Manimohan05/SG13G2_2.4GHz_LC_VCO_FPLL/README.md

## A 2.4 GHz Type-II ∆Σ Fractional-N Phase Locked Loop (PLL) with a Type-IV Cross-Coupled Differential LC Voltage-Controlled Oscillator (VCO) for Wi-Fi/Bluetooth Applications — [Universalization of IC Design from CASS](https://github.com/unic-cass)

**Paper:** [A 2.4 GHz LC-VCO Fractional-N Phase Locked Loop Open-Source Design in 130-nm BiCMOS — IEEE Xplore](https://ieeexplore.ieee.org/document/11647761) (SMACD 2026)

# Table of Contents

1. [Members](#members)
2. [Overview of the Project](#overview)
3. [Specifications of the Project](#specs)
    - [Achieved — as published at SMACD 2026](#specs_achieved)
    - [Specifications not yet verified](#specs_open)
4. [Circuit Design](#circuit)
    - [Phase-Locked Loop (PLL)](#pll)
    - [Phase-Frequency Detector (PFD)](#pfd)
    - [Charge Pump (CP)](#cp)
    - [Loop Filter (LF)](#lf)
    - [Bandgap Reference (BGR)](#bgr)
    - [LC Voltage-Controlled Oscillator (LC-VCO)](#vco)
    - [Delta-Sigma Modulator and Fractional-N Divider](#dsm)
5. [On-Chip Spiral Inductor](#inductor)
    - [Geometry and Performance](#ind_geom)
    - [Open-Source EM Extraction Flow](#ind_flow)
6. [Simulation Results (Pre-Layout)](#sim)
    - [LC-VCO Output Waveform and Spectrum](#sim_vco)
    - [Varactor Tuning Range](#sim_var)
    - [VCO Tuning Curve and K_VCO](#sim_kvco)
    - [Integrated PLL Testbench](#sim_pll)
    - [Integrated Pre-Layout Simulation Circuit](#sim_circuit)
7. [Layout Design](#layout)
    - [Integrated PLL Layout](#lay_pll)
    - [2.5D View](#lay_3d)
    - [Layout Information](#layout_info)
8. [Physical Verification (DRC, LVS)](#pv)
9. [Post-Layout Results after PEX](#pex)
    - [Parasitic Extraction (RC) with Kpex](#pex_flow)
    - [Post-Layout Performance](#pex_results)
    - [Lock Behaviour](#pex_lock)
    - [Phase Noise](#pex_pn)
    - [Reference Spur](#pex_spur)
    - [Comparison with Published Work](#pex_cmp)
    - [Block-Level Pre- vs Post-Layout Comparison](#pex_blocks)
    - [LC-VCO Tuning: Pre- vs Post-Layout](#pex_vco)
10. [UNIC-CASS Tapeout](#tapeout)
11. [Repository Structure](#repo)
12. [Publication](#paper)
13. [References](#ref)

---

## 1. Members (Department of Electronic and Telecommunication Engineering, University of Moratuwa)

- Manimohan	Thiriloganathan (BSc).
- Shenal Ranasinghe (UG).
- Avishka Herath (BSc).
- Rajinthan	Rameshkumar (UG).
- Hansa Marasinghe (BSc).
- Anjana Viduranga (UG).
- Gayangana Leelarathne (MSc) - School of Electrical Engineering, Aalto University, Finland.
- Kithmin Wickremasinghe (MASc) - Department of Electrical and Computer Engineering, University of British Columbia, Canada.

[Return to top](#toc)

---

## 2. Overview of the Project

This project implements a charge-pump (Type-II) **fractional-N phase-locked loop** in the
**IHP SG13G2 130 nm open-source BiCMOS PDK**, using a fully open-source EDA flow. The
loop synthesises the 2.4 GHz ISM band from a stable `10 MHz` reference.

### Architecture

- **Phase-frequency detector** compares the reference `CLK_IN` against the divided VCO
  output and emits `UP`/`DN` pulses proportional to phase error.
- **Charge pump** converts those pulses into a signed current into the loop filter.
- **Third-order passive loop filter** integrates that charge into the control voltage
  `VCTRL` and suppresses reference-rate ripple.
- **Cross-coupled LC-VCO** converts `VCTRL` into an output near 2.44 GHz, tuned by an
  accumulation-mode varactor pair across a tank built on a **custom on-chip spiral
  inductor**.
- **Fractional-N divider** divides the output by 240 or 248, dithered by a first-order
  **delta-sigma modulator** so the *average* ratio is fractional.

### Frequency Relationship

`f_out = N_eff × f_ref`, where `N_eff` ranges from 240 to 248 as set by a 9-bit word
loaded serially over `SCLK`/`SDATA`/`EN`. With `f_ref = 10 MHz` this spans
`2.40 GHz to 2.48 GHz`, covering the 2.4 GHz ISM band. Fractional-N is what gets the
channel resolution below the 10 MHz reference spacing that integer-N would impose.

### Why this design is unusual

Open-source PDKs ship **no on-chip spiral inductor models**. Every previously published
open-source PLL therefore falls back on a ring oscillator and accepts the phase-noise
penalty. This design builds the missing model from scratch with an electromagnetic
solver, making it — to the best of our knowledge — the **first fully open-source CMOS
PLL with an integrated on-chip spiral inductor**.

### Block Diagram

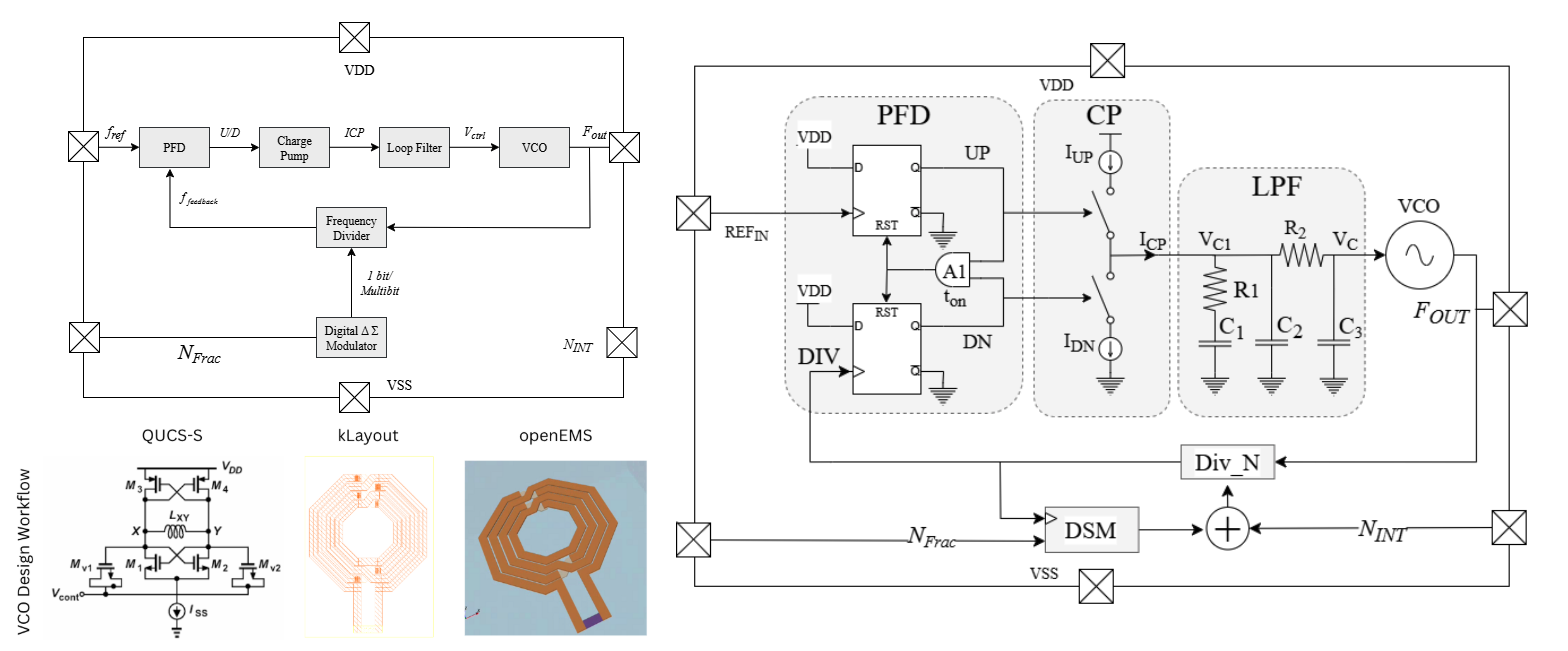
[picture p1: images/block.png]

<p align="center"><em>Figure 1: Block diagram of the fractional-N PLL</em></p>

[Return to top](#toc)

---

## 3. Specifications of the Project

The goal was a 2.4 GHz fractional-N synthesiser suitable for BLE and 2.4 GHz Wi-Fi,
minimising power and area while meeting phase-noise and settling requirements. BLE needs
stringent phase noise and fast settling (typically `< 150 µs`) for stable frequency
hopping.

| Category | Specification | Min | Typ | Max | Unit |
|---|---|-----|-----|-----|---|
| Top-level | Supply voltage | 1.08 | **1.20** | 1.32 | V |
| Top-level | Temperature | 20 | 27 | 50 | °C |
| Top-level | Reference frequency | – | 10 | – | MHz |
| Top-level | Output centre frequency range | 2.40 | 2.45 | 2.48 | GHz |
| Top-level | Expected PLL lock time | – | 25 | 40 | µs |
| Loop/Control | Loop bandwidth | 80 | 150 | 300 | kHz |
| Loop/Control | Phase margin | 50 | 55 | 60 | ° |
| Dividers | MMD division range | 240 | 245 | 248 | – |
| Charge Pump | CP current range | 50 | 150 | 300 | µA |
| VCO | Oscillation frequency | 2.35 | 2.45 | 2.55 | GHz |
| VCO | K<sub>VCO</sub> sensitivity | 50 | 80 | 150 | MHz/V |
| VCO | Phase noise (@1 MHz offset) | – | −100 | – | dBc/Hz |
| Power/Area | Total DC power consumption | – | 12 | 25 | mW |
| Power/Area | Die area | 0.48 | 0.8 | 1.2 | mm² |

> **Supply note.** Earlier revisions of this repository listed a 1.8 V supply. That was
> inherited from an older plan and is wrong for this implementation: SG13G2 low-voltage
> devices are 1.2 V parts, every testbench runs at `.param VDD=1.2`, and the archived
> corner runs use 1.08 / 1.20 / 1.32 V.

### 3.1 Achieved — post-layout, as published at SMACD 2026

Values below are the ones reported in the paper (see [§12](#paper)), measured from
post-layout simulation with parasitic extraction at V<sub>DD</sub> = 1.2 V, 27 °C,
f<sub>REF</sub> = 10 MHz, carrier 2.44 GHz.

| Parameter | Value |
|---|---|
| Technology | IHP SG13G2, 130 nm SiGe BiCMOS |
| Architecture | Type-II fractional-N, 1st-order digital ∆Σ |
| Reference frequency | 10 MHz |
| Division ratios | 240 and 248, ∆Σ-dithered |
| Output frequency range | 2.4 – 2.48 GHz |
| VCO tuning range | > 3.3 % |
| K<sub>VCO</sub> | ≈ 120 MHz/V |
| Phase noise @ 1 MHz offset | −100.8 dBc/Hz |
| Reference spur | ≈ −40.2 dBc |
| Total DC power | 12.73 mW |
| Die area | 660 µm × 526.5 µm ≈ 0.347 mm² |
| Varactor capacitance swing | 70 – 200 fF over 1.2 V V<sub>CTRL</sub> |
| VCO startup | reliable down to ≈ 0.7 V tail bias |

> The frequency and K<sub>VCO</sub> rows are the paper's figures. Re-simulating the LC-VCO alone
> on the extracted layout gives 2.3255 – 2.4256 GHz, so the post-layout VCO does not reach the
> top of the band; see [§9.8](#pex_vco).

The tuning range and the reference spur fall short of the targets in the table above —
3.3 % against 8 %, and −40.2 dBc against −60 dBc. The achieved tuning range still covers
the intended ISM band, and the spur still meets BLE requirements; both are addressed
under future work in [§9.6](#pex_cmp).

**Spiral inductor (paper §II):**

| Parameter | Value |
|---|---|
| Geometry | 3-turn symmetric octagonal, TopMetal2 spiral, TopMetal1 underpass via TopVia2 |
| R<sub>out</sub> / S / W | 218 µm / 14 µm / 30 µm |
| L<sub>diff</sub> @ 2.45 GHz | **4.000 nH** (2 % tolerance constraint) |
| Q<sub>diff</sub> @ 2.45 GHz | **16.80** |
| Peak Q<sub>diff</sub> | ≈ 18.9 near 3.8 GHz |
| Self-resonant frequency | ≈ 10 GHz |
| Q<sub>diff</sub> over 2.3 – 2.7 GHz, ±5 % geometry | 16.32 – 17.49 |
| L<sub>diff</sub> over 2.3 – 2.7 GHz, ±5 % geometry | 3.9 – 4.1 nH |
| EM setup | OpenEMS FDTD, 0 – 12 GHz Gaussian excitation, 0.5 µm refined cell size |

### 3.2 Specifications not yet verified

Listed rather than silently omitted — these appear in the target table but have no
archived evidence in this repository:

| Specification | Status |
|---|---|
| Lock time (25 – 40 µs) | Measured on the pre-layout schematic-level closed-loop run (§9.3): frequency-locked within ±1000 ppm from 7.6 µs, phase settled from 11 µs — inside the target. No post-layout closed-loop lock-time measurement yet |
| Loop bandwidth and phase margin | Design values from `model/calculations/PLL/`; no post-layout loop-gain measurement |
| PVT across TT/FF/SS/FS/SF | Corner libraries wired into the testbenches; only the typical corner archived |
| Monte Carlo yield (99 %) | Not run as a full sign-off across all blocks; bandgap and charge-pump mismatch run, see below |
| Power-down current | No power-down mode in this revision |

**Monte Carlo (mismatch), 200 samples, ngspice `mos_tt_mismatch`/`res_typ_mismatch`/`cap_typ_mismatch`:**

| Block | Quantity | Mean | Std. dev. |
|---|---|-----:|---:|
| Bandgap reference | V<sub>BGR</sub> | 601.6 mV | 3.7 mV |
| Charge pump | `UP` current | 48.8 µA | 0.4 µA |
| Charge pump | `DN` current | 51.7 µA | 0.4 µA |
| Charge pump | Up/down mismatch | −5.8 % | 0.5 % |

The −5.8 % mean mismatch is a real, quantified instance of the mechanism named in
[§4.3](#cp) as the dominant reference-spur source. Not yet run: a full 99 % yield
Monte Carlo across every block, and no PVT corners were combined with mismatch.

[Return to top](#toc)

---

## 4. Circuit Design

### 4.1 Phase-Locked Loop (PLL)

The top-level cell `LC_VCO_FPLL` has the interface:

```
.subckt LC_VCO_FPLL CLK_IN VDD CLK_OUT VSS EN RST SDATA SCLK
```

| Pin | Direction | Function |
|-----|---|---|
| `CLK_IN` | input | 10 MHz reference clock |
| `CLK_OUT` | output | Buffered 2.4 GHz VCO output |
| `EN`, `SCLK`, `SDATA` | input | Serial configuration of the division ratio |
| `RST` | input | Asynchronous active-high reset |
| `VDD`, `VSS` | supply | 1.2 V / ground |

A bandgap reference biases both the charge pump and the VCO tail current source, so loop
gain and oscillation amplitude track together over supply and temperature. Forty MIM
capacitors (20 µm × 20 µm) decouple the supply at the top level, keeping the switching
digital divider out of the VCO tank.

### 4.2 Phase-Frequency Detector (PFD)

Two rising-edge-triggered D flip-flops with a NAND reset — built entirely from SG13G2
standard cells:

| Instance | Cell | Role |
|---|---|---|
| `x1` | `sg13g2_dfrbp_2` | Reference-path flip-flop, sets `UP` |
| `x2` | `sg13g2_dfrbp_2` | Feedback-path flip-flop, sets `DN` |
| `x3` | `sg13g2_nand2_2` | Reset from `UP · DN` |

Being a PFD rather than a plain phase detector, its average output tracks *frequency*
error as well as phase, so the loop pulls in without a separate acquisition aid. The
delay through the NAND reset path sets a minimum `UP`/`DN` pulse width, which removes the
**dead zone** that would otherwise leave the VCO drifting near zero phase error.

### 4.3 Charge Pump (CP)

A current-steering charge pump: cascoded PMOS source and NMOS sink branches, switched by
`UP` and `DN`, biased from `VBGR`.

| Device | Type | W / L | Fingers | Role |
|---|---|---|---|---|
| `MM9` | `sg13_lv_pmos` | 163.6 µm / 2 µm | 20 | Source device into `VCP` |
| `MM5` | `sg13_lv_nmos` | 40.7 µm / 2 µm | 5 | Sink device from `VCP` |
| `MM7` | `sg13_lv_pmos` | 29.6 µm / 2 µm | 5 | `UP` switch |
| `MM1` | `sg13_lv_nmos` | 6 µm / 2 µm | 1 | `DN` switch |
| `MM6` | `sg13_lv_nmos` | 3.9 µm / 2 µm | 1 | `VBGR` reference current |

Every device is drawn at `L = 2 µm` — not for speed, but for output impedance and
matching. **Up/down current mismatch is the dominant reference-spur mechanism**: any
imbalance injects a net charge packet once per reference cycle, modulating the VCO at
10 MHz.

### 4.4 Loop Filter (LF)

Third-order passive, entirely on-chip:

| Element | Device | Size | Value |
|---|---|---|---|
| `RR1`, `RR2` | `rppd` | W = 2 µm, L = 407.2 µm | ≈ 14.84 kΩ each |
| `CC1` | `cap_cmim` | 48.34 µm × 48.34 µm, m = 16 | Integrating capacitor |
| `CC2` | `cap_cmim` | 18.63 µm × 18.63 µm, m = 4 | Ripple bypass |

`C1` gives the pole at the origin that makes the loop **type-II** (zero static phase
error). `R1` sets the stabilising zero that recovers phase margin. `R2`–`C2` add a third
pole well above the loop bandwidth to attenuate reference-rate ripple without eating the
margin `R1` just bought back.

### 4.5 Bandgap Reference (BGR)

An all-CMOS self-biased reference producing `VBGR ≈ 0.6 V`, with a startup network
(`dn2`/`dn3`/`dn4`) that forces the circuit out of its zero-current state at power-up and
then disengages. Channel lengths of 5 µm and above throughout — matching and low flicker
noise matter far more than speed here, because `VBGR` noise reaches the VCO tail and
up-converts into phase noise.

### 4.6 LC Voltage-Controlled Oscillator (LC-VCO)

A **type-IV cross-coupled topology**: complementary NMOS *and* PMOS cross-coupled pairs
across a shared LC tank, with an NMOS tail current source.

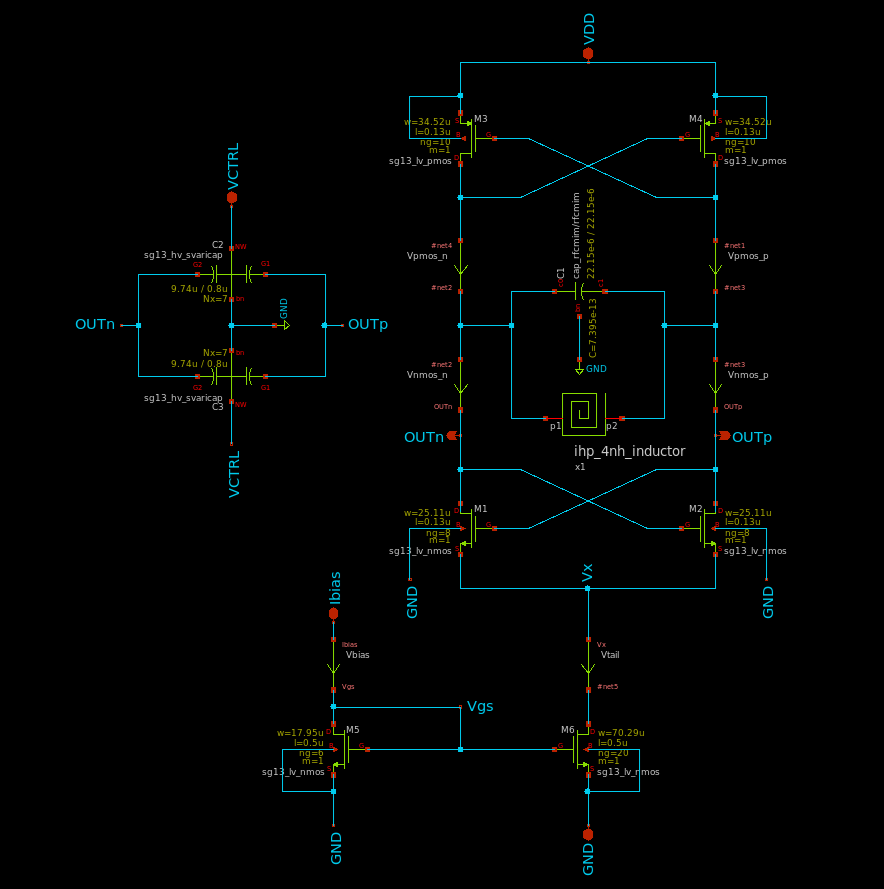
[picture p2: xschem/lc-vco/images/VCO_v2_Sch.png]

<p align="center"><em>Figure 2: LC-VCO schematic</em></p>

| Device | Type | W / L | Fingers | Role |
|---|---|---|---|---|
| `MM1`, `MM2` | `sg13_lv_nmos` | 21.99 µm / 130 nm | 3 | NMOS cross-coupled pair |
| `MM3`, `MM4` | `sg13_lv_pmos` | 36 µm / 130 nm | 5 | PMOS cross-coupled pair |
| `MM5` | `sg13_lv_nmos` | 384 µm / 1 µm | 48 | Tail current source |
| `MM6` | `sg13_lv_nmos` | 64 µm / 1 µm | 8 | Tail mirror diode |
| `MM7` | `sg13_lv_pmos` | 38 µm / 1 µm | 5 | Bias injection from `VBGR` |
| `MM8`, `MM9` | lv pmos / nmos | 15 µm, 1.5 µm / 130 nm | 10 / 1 | Output buffer |
| `MM10`, `MM11` | lv pmos / nmos | 15 µm, 1.5 µm / 130 nm | 10 / 1 | Dummy, balances the load |

Adding the PMOS pair roughly doubles the transconductance available for a given bias
current, which buys startup margin — the design starts reliably down to about `0.7 V` on
the tail bias — at the cost of extra tank parasitic capacitance.

`MM10`/`MM11` drive nothing. They exist so both tank nodes see the same capacitive load;
an asymmetric load would convert common-mode noise into phase noise.

**The tank:**

| Element | Device | Size | Value |
|---|---|---|---|
| `x1` | `4nH_INDUCTOR` | see [§5](#inductor) | 4.0 nH, Q<sub>diff</sub> = 16.8 @ 2.45 GHz |
| `CC1` | `rfcmim` | 21.9 µm × 21.9 µm | Fixed tank capacitance |
| `CC2`, `CC3` | `sg13_hv_svaricap` | 9.74 µm / 0.8 µm, Nx = 7 | Tuning, 70–200 fF over 1.2 V |

### 4.7 Delta-Sigma Modulator and Fractional-N Divider

The only synthesised block, hardened from Verilog with Yosys and LibreLane into the
`DSM_N_FREQ_DIV` macro.

**Divider chain:**

```
CLK_OUT ──► ÷4 fixed ──► ÷4/÷5 prescaler ──► mod-7 counter ──► ÷2 duty corrector ──► CLK_FB
 2.4 GHz      600 MHz          ▲                     │
                               └─── modulus controller ◄─── SEL (from ΔΣ)
```

| Path | Arithmetic | Total |
|---|---|---|
| ÷4 → (÷4/÷5 + mod-7 = 30) → ÷2 | 4 × 30 × 2 | **240** |
| ÷4 → (÷4/÷5 + mod-7 = 31) → ÷2 | 4 × 31 × 2 | **248** |

Only the first stage runs at 2.4 GHz; everything after it sees 600 MHz or less, so the
ratio-switching logic is ordinary synthesised standard-cell logic. The final ÷2 forces an
exact 50 % duty cycle, so the PFD sees no ratio-dependent phase offset.

**Delta-sigma modulator:** a first-order digital modulator — 9-bit signed accumulator,
9-bit comparator acting as a 1-bit quantiser, and a mapper expanding the decision back to
9 bits for subtraction. It shapes the quantisation error to high frequencies where the
loop filter attenuates it, replacing discrete fractional spurs with a small noise floor.
This is why the loop bandwidth must stay well below the frequency at which the shaped
noise rises.

[Return to top](#toc)

---

## 5. On-Chip Spiral Inductor

### 5.1 Geometry and Performance

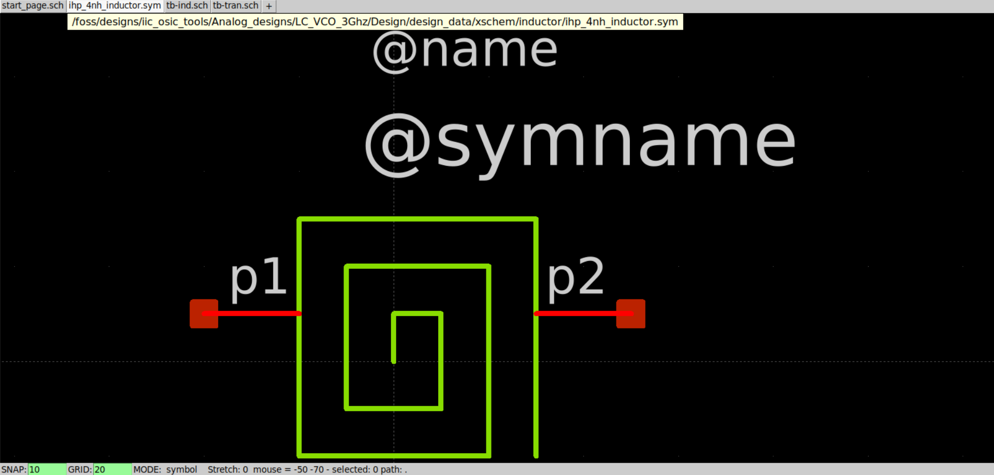
[picture p3: xschem/lc-vco/inductor/images/Inductor_symbol.png]

<p align="center"><em>Figure 3: Inductor symbol used in the VCO schematic</em></p>

| Parameter | Symbol | Value |
|---|---|---|
| Turns | N | 3 |
| Shape | – | Symmetric octagonal |
| Outer radius | R<sub>out</sub> | 218 µm |
| Turn spacing | S | 14 µm |
| Trace width | W | 30 µm |
| Main spiral | – | TopMetal2 (3.0 µm thick, σ = 3.03e7 S/m) |
| Underpass | – | TopMetal1 via TopVia2 |

**Octagonal** rather than square: the 45° corners avoid the current crowding that square
corners cause. **TopMetal2** because it is the thickest metal in the stack, giving the
lowest series resistance — and series resistance is what limits Q.

| Quantity | Value |
|---|---|
| L<sub>diff</sub> @ 2.45 GHz | 4.000 nH |
| Q<sub>diff</sub> @ 2.45 GHz | 16.80 |
| Peak Q<sub>diff</sub> | ≈ 18.9 near 3.85 GHz |
| Self-resonant frequency | ≈ 9.95 GHz |
| Q<sub>diff</sub> over 2.3–2.7 GHz (±5 % geometry) | 16.32 – 17.49 |
| L<sub>diff</sub> over 2.3–2.7 GHz (±5 % geometry) | 3.9 – 4.1 nH |

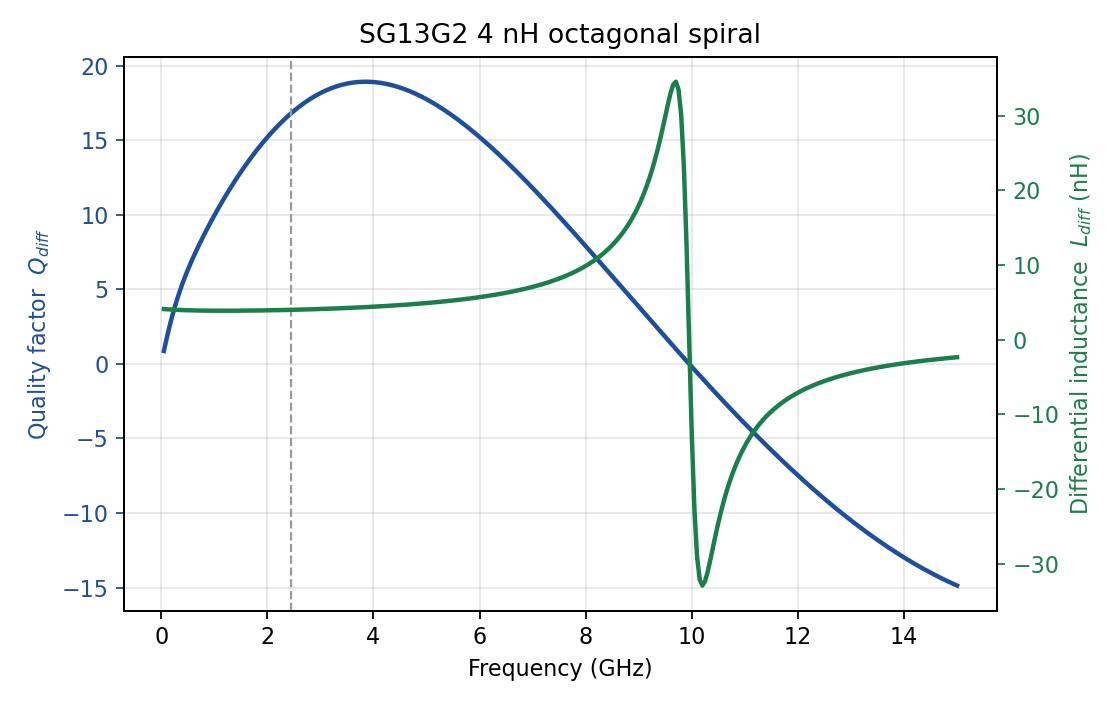
[picture p4: docs/img/inductor-LQ.png]

<p align="center"><em>Figure 4: Differential inductance and quality factor versus frequency, produced by the open-source flow in <code>em/</code></em></p>

Tank Q is essentially inductor Q, and oscillator phase noise falls as 1/Q², so every
point of Q is worth roughly 2 dB. Maximising Q<sub>diff</sub> at 2.45 GHz was therefore
the objective of the geometry optimisation; the 4 nH target was the *constraint*.

### 5.2 Open-Source EM Extraction Flow

The on-chip inductor is characterised by a **fully open-source EM extraction flow** in
[`em/`](em/), which takes the layout and emits the SPICE model directly, with no
proprietary EM solver in the loop:

```
gds/blocks/4nH_INDUCTOR.gds
      │  flatten polygons, map GDS layers onto the SG13G2 stackup
      ▼
 OpenEMS FDTD (0–12 GHz, graded mesh, real BEOL stack and substrate)
      │  raw 2-port S-parameters
      ▼
 two-step open-short de-embedding
      │
      ├──► L_diff, Q_diff, peak Q, SRF + plot
      ▼
 vector fit (shared poles) ──► .subckt 4nH_INDUCTOR 1 2
```

The generated model's subcircuit name and pin order match the Xschem testbenches, so it
drops straight in with no schematic change. An Ansys HFSS characterisation of the same
geometry (archived in [`archive/hfss/`](archive/hfss/)) is kept for cross-reference. The
`em` stage (the OpenEMS FDTD solve itself) has not been run in this repository; what is
verified is the rest of the pipeline — running the de-embedding, vector-fit and
circuit-solve stages on the archived HFSS S-parameters reproduces every published figure
to within a fraction of a percent:

| Quantity | Open-source flow | HFSS |
|---|---|---|
| L<sub>diff</sub> @ 2.45 GHz | 4.0005 nH | 4.000 nH |
| Q<sub>diff</sub> @ 2.45 GHz | 16.805 | 16.80 |
| Peak Q<sub>diff</sub> | 18.915 at 3.85 GHz | ≈ 18.9 near 3.8 GHz |
| Self-resonant frequency | 9.95 GHz | ≈ 10 GHz |

```bash
cd em
pip install -r requirements.txt
python scripts/validate.py                                   # self-check
python scripts/run_pipeline.py --config config/inductor_4nH.yaml
```

Full details in [`em/README.md`](em/README.md).

[Return to top](#toc)

---

## 6. Simulation Results (Pre-Layout)

### 6.1 LC-VCO Output Waveform and Spectrum

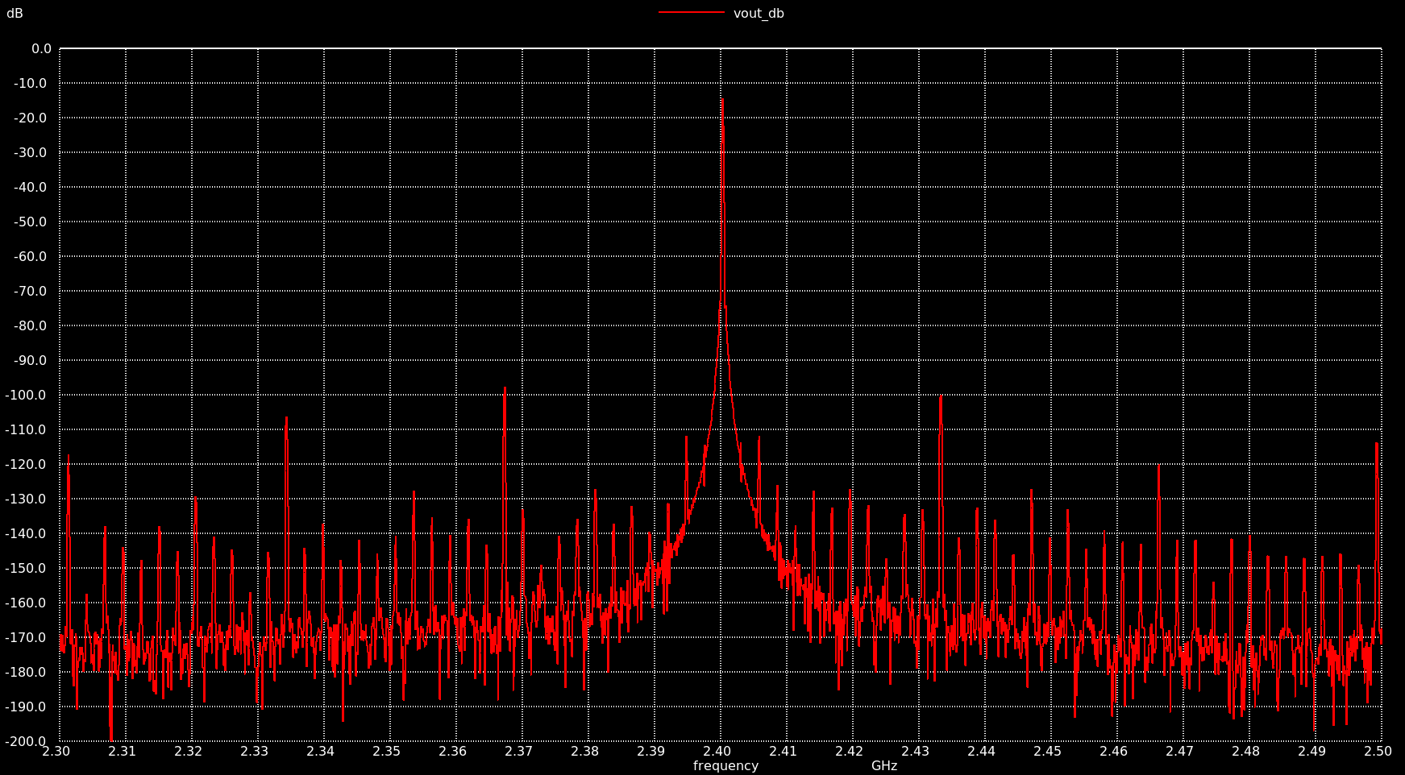
[picture p5: xschem/lc-vco/images/VCO_v2_FFT_2.4G.png]

<p align="center"><em>Figure 5: LC-VCO output spectrum at 2.4 GHz</em></p>

### 6.2 Varactor Tuning Range

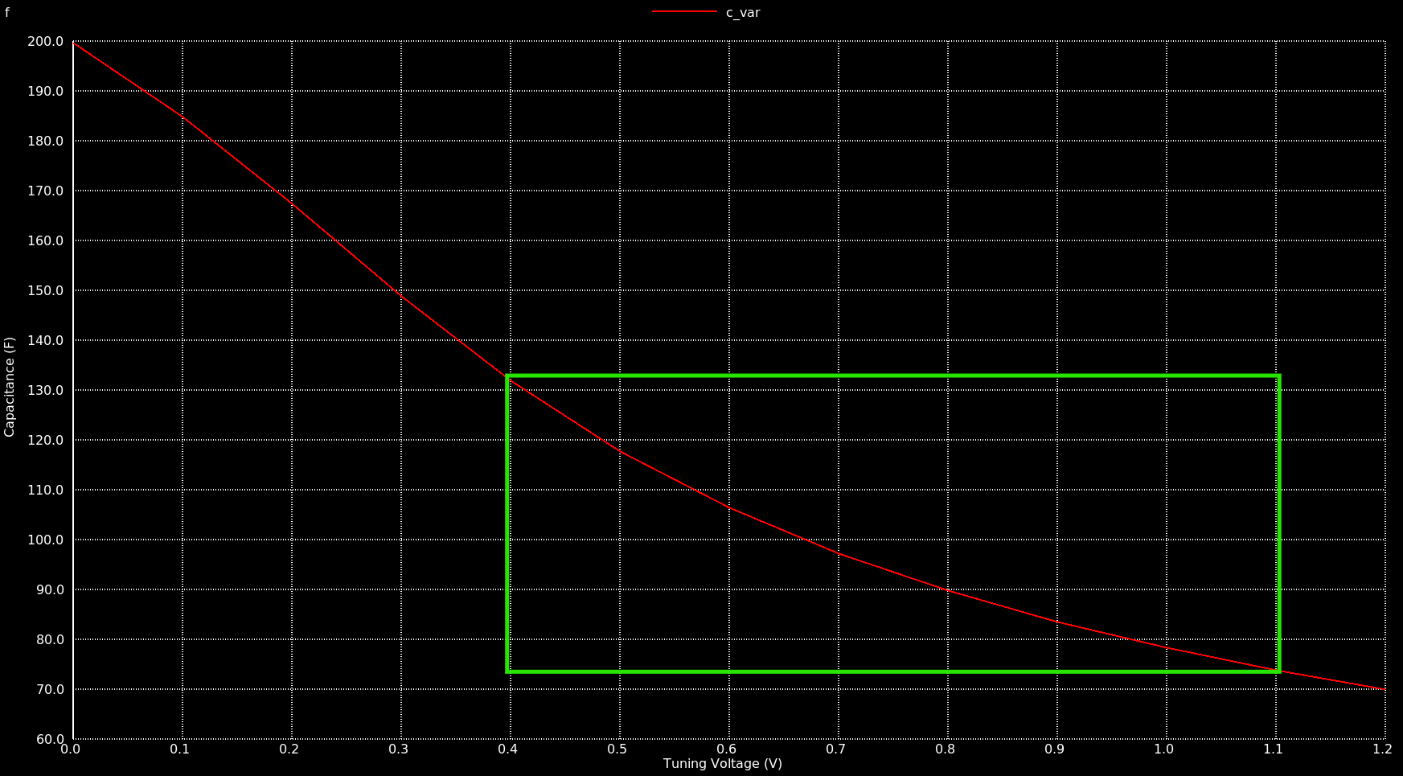
[picture p6: xschem/lc-vco/images/Varicap_Range.png]

<p align="center"><em>Figure 6: Varactor capacitance versus control voltage — 70 fF to 200 fF over 1.2 V</em></p>

### 6.3 VCO Tuning Curve and K<sub>VCO</sub>

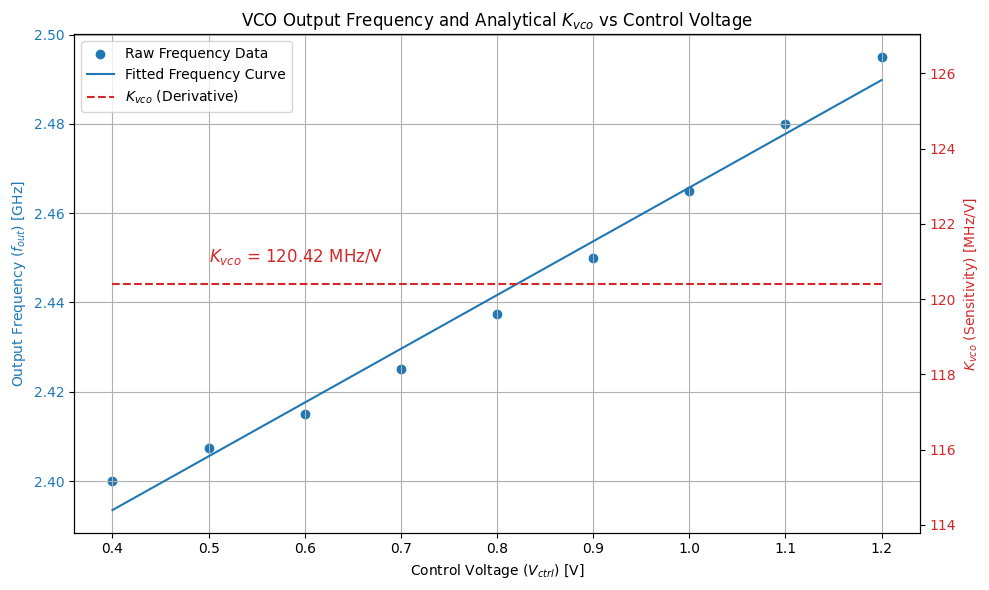
[picture p7: xschem/lc-vco/images/VCO_v2_Kvco.png]

<p align="center"><em>Figure 7: Oscillation frequency and K<sub>VCO</sub> versus control voltage</em></p>

### 6.4 Integrated PLL Testbench

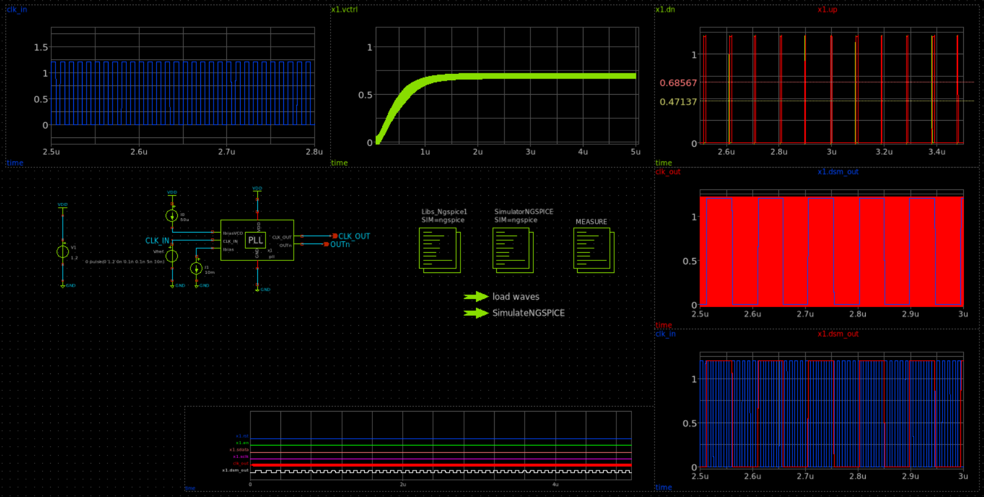
[picture p8: xschem/top-pll/images/Pll_tb.png]

<p align="center"><em>Figure 8: Closed-loop PLL testbench</em></p>

### 6.5 Integrated Pre-Layout Simulation Circuit

The complete schematic driven for the pre-layout closed-loop runs — PFD, charge pump,
loop filter, LC-VCO, bandgap reference and the ∆Σ fractional-N divider wired as one
system.

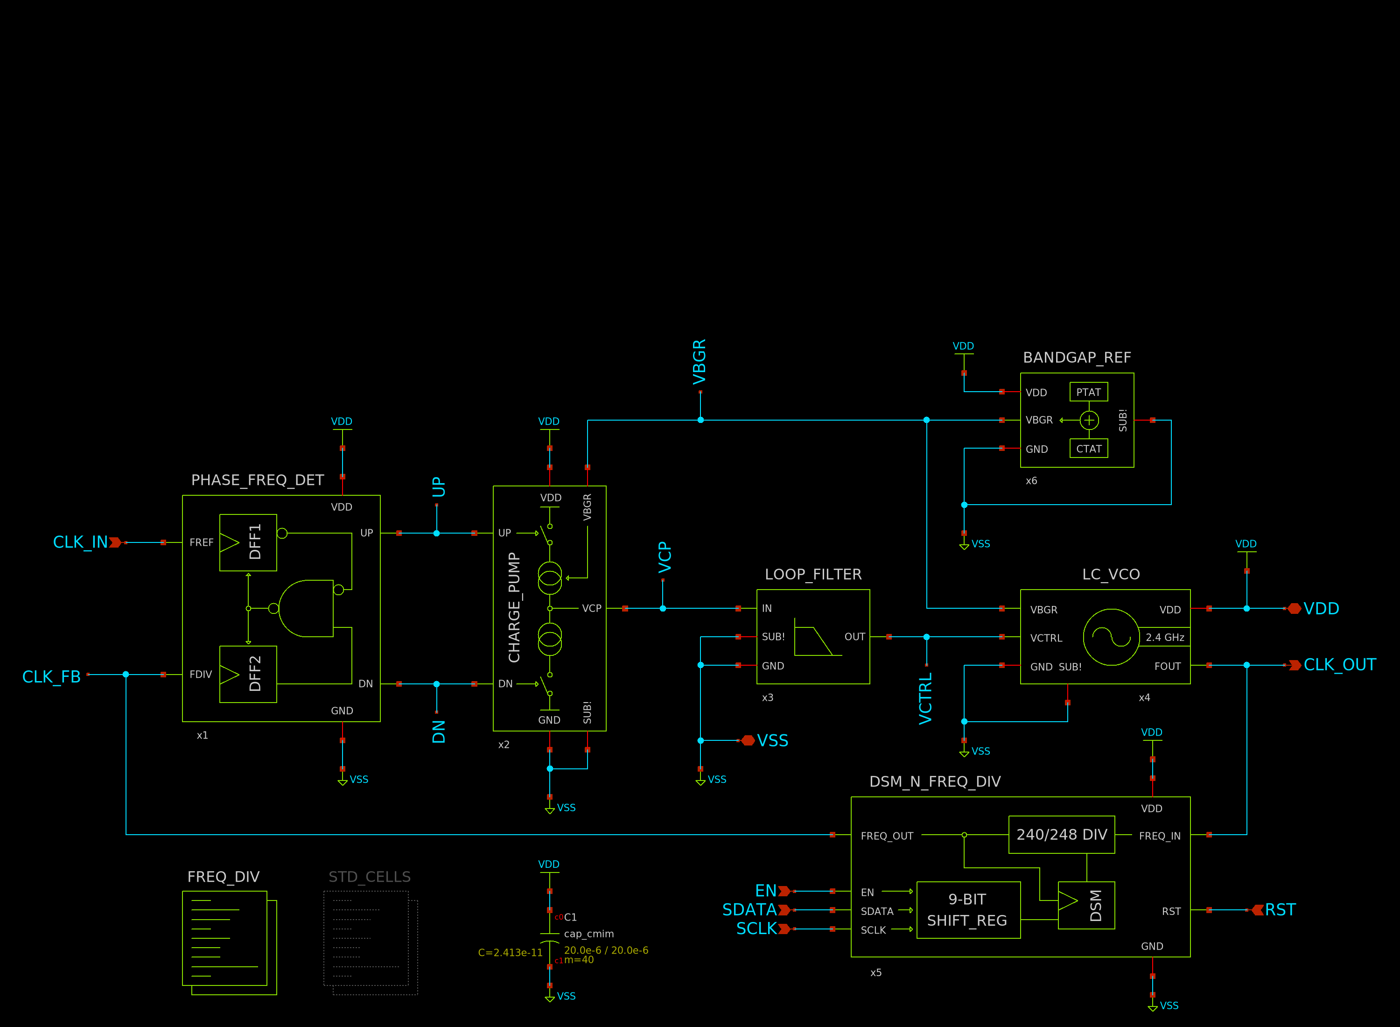
[picture p9: images/PLL_integrated_schematic.png]

<p align="center"><em>Figure 9: Integrated pre-layout simulation circuit</em></p>

[Return to top](#toc)

---

## 7. Layout Design

### 7.1 Integrated PLL Layout

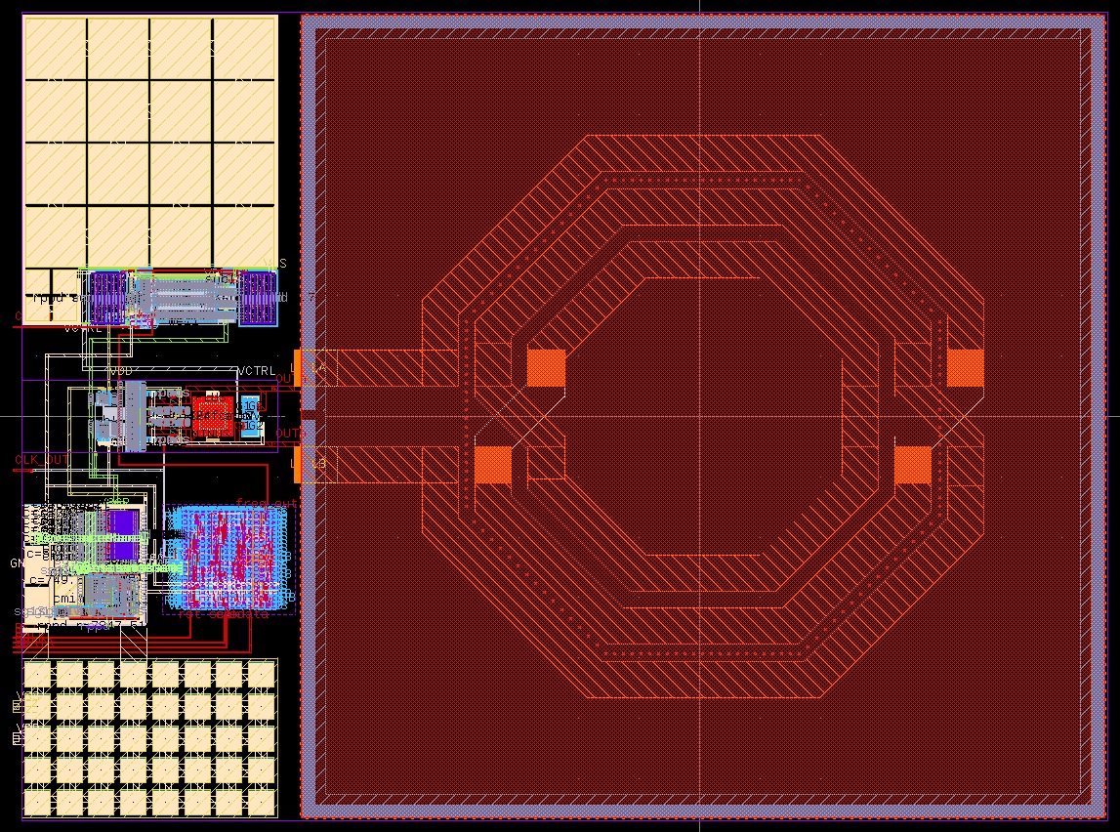
[picture p10: images/PLL_Layout.jpeg]

<p align="center"><em>Figure 10: Top-level PLL layout — 907 µm × 670 µm</em></p>

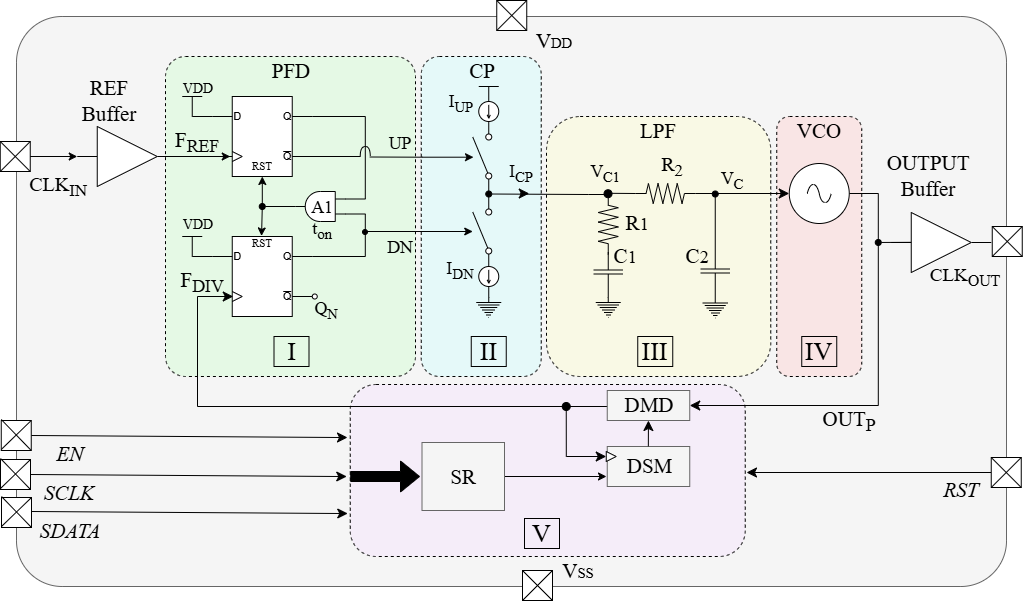
[picture p11: images/PLL_Architecture.png]

<p align="center"><em>Figure 11: The five blocks of the PLL — PFD (I), charge pump (II), loop filter (III), LC-VCO (IV), and the serially programmed ΔΣ modulator with divider (V)</em></p>

The spiral inductor dominates the die and sets its size. The floorplan reflects each
block's sensitivity: the inductor and VCO occupy a guard-ringed region as far as
practical from the digital divider; the switching `DSM_N_FREQ_DIV` macro is placed away
from the tank with its own decoupling; and the PFD, charge pump and loop filter sit
together as the `PFD_CP_LF` group, because charge-pump current matching depends on how
the filter loads it.

### 7.2 2.5D View

The metal stack rendered with KLayout's 2.5D viewer — the spiral on TopMetal2 with its
TopMetal1 underpass is clearly separated from the rest of the circuitry below.

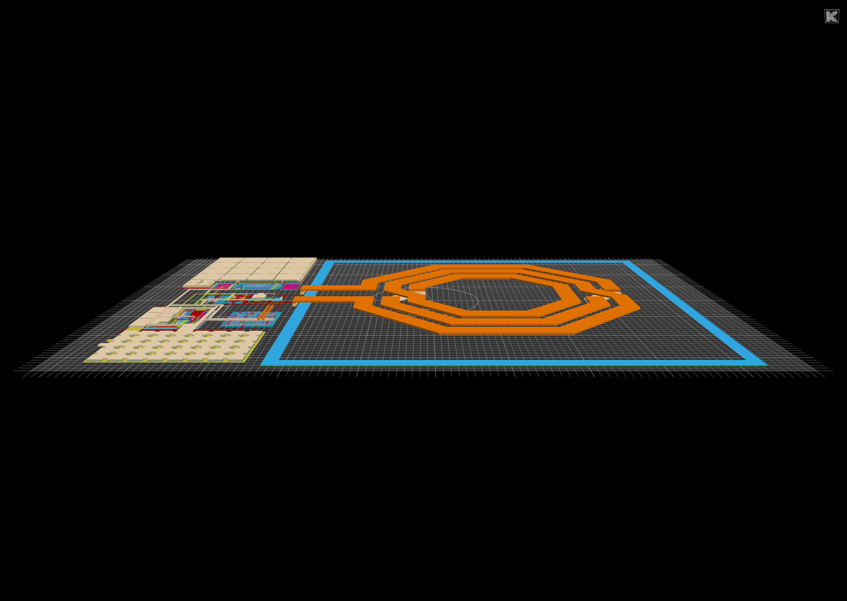
[picture p12: images/PLL_layout_2p5D_oblique_view.png]

<p align="center"><em>Figure 12: 2.5D view of the integrated PLL layout</em></p>

### 7.3 Layout Information

| | **Width (µm)** | **Height (µm)** | **Area (µm²)** | Notes |
|--|---|---|---|---|
| **Integrated PLL** | 907.0 | 670.0 | 607,690 (≈ 0.608 mm²) | bounding box of all layers in `gds/LC_VCO_FPLL.gds` |
| **Spiral inductor** | 666 | 672 | ≈ 447,000 | TopMetal2 / TopMetal1, guard-ringed |

[Return to top](#toc)

---

## 8. Physical Verification (DRC, LVS)

All runs used **KLayout 0.30.11** and IHP-Open-PDK `7e53c77` against the IHP SG13G2 rule
decks (`main` and `sg13g2_maximal` tables for DRC, density rules off). **LVS was run with
strict port checking** — no `--ignore_top_ports_mismatch` — so pin names and pin count on
the layout must equal those of the schematic netlist.

| Cell | DRC | LVS |
|---|-----|-----|
| `LC_VCO_FPLL` (integrated top level) | ✅ clean | ✅ match |
| `PFD_CP_LF` | ✅ clean | ✅ match |
| `PHASE_FREQ_DET` | ✅ clean | ✅ match |
| `CHARGE_PUMP` | ✅ clean | ✅ match |
| `LOOP_FILTER` | ✅ clean | ✅ match |
| `BANDGAP_REF` | ✅ clean | ✅ match |
| `DSM_N_FREQ_DIV` | ✅ clean | ✅ match |
| `LC_VCO_NOIND` | ✅ clean | ✅ match |
| `LC_VCO` | ✅ clean | ✅ match |
| `4nH_INDUCTOR` | ✅ clean | ℹ️ extraction only |

**The integrated top level `LC_VCO_FPLL` is DRC clean and LVS matching** — the result
that gates tapeout.

> **Block pin names.** The standalone block layouts carry the same pin names as their
> schematics: ground is `GND` (`LOOP_FILTER`, `CHARGE_PUMP`), the supplies of
> `DSM_N_FREQ_DIV` are `GND`/`VDD`, and `LC_VCO` has its five pins labelled on the top
> cell. `LOOP_FILTER`, `CHARGE_PUMP` and `BANDGAP_REF` declare a `SUB!` substrate pin in
> their schematics; each layout has a small P+ substrate tap on a Metal1 pad labelled
> `SUB!` (placed clear of the existing shapes) so that pin exists in the layout as well.
> These edits add labels and one tap per block and change no existing geometry. The
> full-chip and `PFD_CP_LF` layouts contain their own copies of these blocks without the
> extra pad and still match. `4nH_INDUCTOR` is extraction-only because there is no
> schematic to compare a passive spiral against; LVS sees the two-terminal black box
> `spice/4nH_INDUCTOR_LVS.spice`.

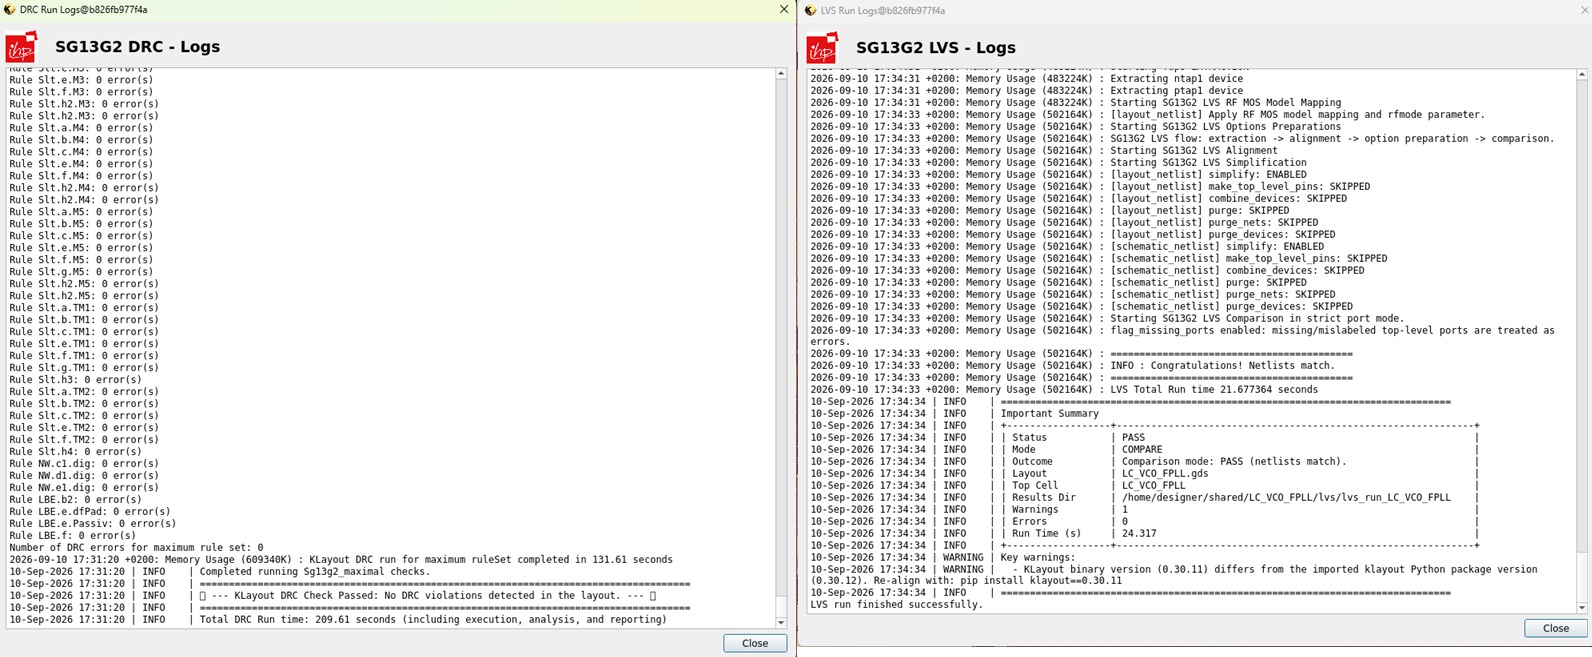
[picture p13: images/DRC_and_LVS_all_blocks_passed_log.jpeg]

<p align="center"><em>Figure 13: DRC and LVS run logs for the blocks</em></p>

Archived runs live in [`drc/`](drc/) and [`lvs/`](lvs/), one directory per cell.

[Return to top](#toc)

---

## 9. Post-Layout Results after PEX

Nominal conditions: V<sub>DD</sub> = 1.2 V, 27 °C, typical corner, f<sub>REF</sub> =
10 MHz, carrier 2.44 GHz.

> **What is actually post-layout here.** §9.2 (frequency, K<sub>VCO</sub>, phase noise, spur,
> power) reports the paper's published post-layout numbers. §9.7 and §9.8 are this repository's
> own post-layout PEX comparisons, block by block and for the VCO alone. §9.3 and §9.4 (lock
> behaviour and phase noise plots) are from a **closed-loop run of the schematic netlist**, not
> a post-layout run — the closed-loop PLL has not yet been simulated on the extracted netlist
> (§9.7 explains why). They are placed here, next to the paper's numbers, so the two can be
> compared; the captions say "schematic level" for this reason. §9.5's figure is the paper's
> post-layout spectrum; the text below it adds the schematic-level run's own spur measurement
> for the same comparison.

### 9.1 Parasitic Extraction (RC) with Kpex

RC extraction is run with Magic through `kpex`. Results are archived per cell in
[`pex/`](pex/):

```
pex/<CELL>__<TOPCELL>/
  kpex.log
  magic_RC/<CELL>.pex.spice              ← the extracted netlist used in PEX simulation
  magic_RC/<CELL>.ext
  magic_RC/<CELL>_MAGIC_RC_Script.tcl
```

Extracted netlists feed the `*_PEX` testbenches in [`simulations/`](simulations/), for
example `tb_CP_LF_PEX.spice` and `tb_PHASE_FREQ_DET_PEX.spice`. PEX is archived for
`BANDGAP_REF`, `CHARGE_PUMP_V2`, `LOOP_FILTER`, `PHASE_FREQ_DET` and `LC_VCO_NOIND`. The archived `<CELL>.pex.spice` files are the testbench-ready netlists
(subcircuit named `<CELL>_PEX`, ports in the testbench pin order); the extraction is from
the layouts in `gds/blocks/`, including revision **V2** of the charge pump that ships in
the top level.

**Digital divider.** `DSM_N_FREQ_DIV` is a standard-cell block from the OpenLane flow, so it has no separate
RC extraction here. Its post-layout simulation uses the layout-extracted netlist of the OpenLane run,
[`xschem/dsm/src/runs/RUN_2026-03-04_15-08-00/final/spice/dsm_and_freq_divider.spice`](xschem/dsm/src/runs/RUN_2026-03-04_15-08-00/final/spice/dsm_and_freq_divider.spice)
(transistor-level, no parasitic elements), with the standard cells taken from the PDK.

**LC-VCO.** `kpex`/Magic extract only resistance and capacitance — no inductance and no
mutual coupling — so the spiral must not be extracted with the rest of the VCO. The VCO
is extracted without the inductor as `LC_VCO_NOIND`, and the EM-extracted
`4nH_INDUCTOR` model is connected between its `OUTn` and `OUTp` pins in
`simulations/LC_VCO_NOIND_pex_tb.spice`. `LC_VCO_NOIND.pex_sim.spice` is the same
netlist with the four extracted varactor lines replaced by two `sg13_hv_svaricap`
instances, which ngspice can bind to the PDK model.

### 9.2 Post-Layout Performance

| Metric | Value |
|---|---|
| Output frequency range | 2.40 – 2.48 GHz |
| VCO tuning range | > 3.3 % |
| K<sub>VCO</sub> | ≈ 120 MHz/V |
| Phase noise @ 1 MHz offset | **−100.8 dBc/Hz** |
| Reference spur | ≈ −40.2 dBc |
| Total power consumption | **12.73 mW** |
| Die area | **907 µm × 670 µm (≈ 0.608 mm²)** |

> The die area is measured from the current `gds/LC_VCO_FPLL.gds` (bounding box of all layers); the paper
> reports 660 µm × 526.5 µm (≈ 0.347 mm²), which is a different floorplan (§3.1). The output-frequency and K<sub>VCO</sub> rows are the paper's figures. The extracted LC-VCO,
> simulated on its own, covers 2.3255 – 2.4256 GHz with K<sub>VCO</sub> ≈ 106 MHz/V over
> 0.4 – 1.2 V; see [§9.8](#pex_vco).

### 9.3 Lock Behaviour

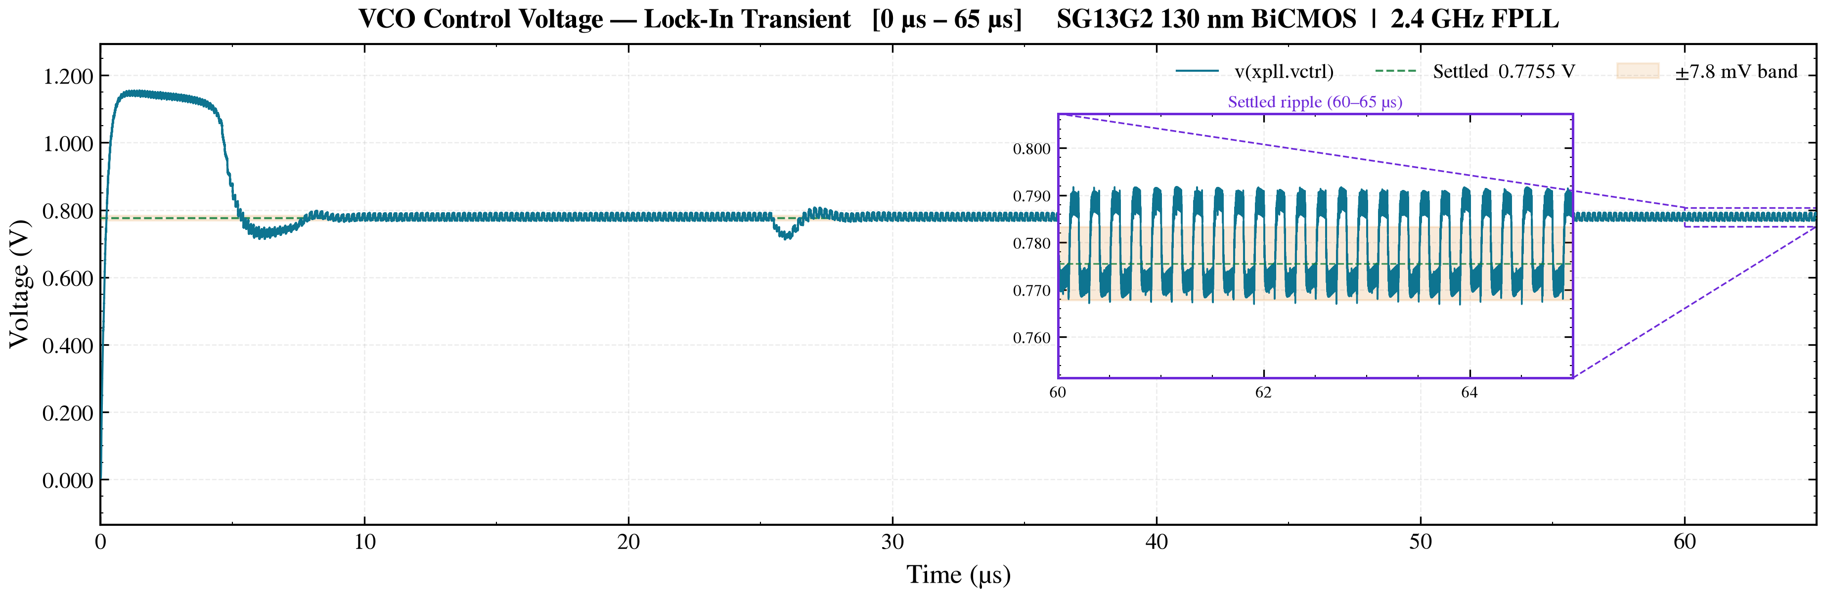
[picture p14: xschem/top-pll/plots/prelayout/plot_vctrl_transient.png]

<p align="center"><em>Figure 14: Control voltage over 0–65 µs (closed-loop run at schematic level) — overshoot to 1.16 V, lock at about 8 µs, and a short disturbance every 25.5 µs from the divider's modulator pattern</em></p>

The loop is frequency-locked within ±1000 ppm from 7.6 µs and within ±500 ppm from 8.5 µs; the phase error is within
±100 ps of its final value from 11 µs. Every 25.5 µs (255 reference cycles) the modulator repeats a pattern in which two
equal bits follow each other, and the loop takes about 2 µs to recover from it; it always returns to the same phase. The
steady-state control voltage is 0.7795 V with about 26 mV of ripple at 10 MHz. Details and plots: [`xschem/top-pll/plots/prelayout/`](xschem/top-pll/plots/prelayout/).

### 9.4 Phase Noise

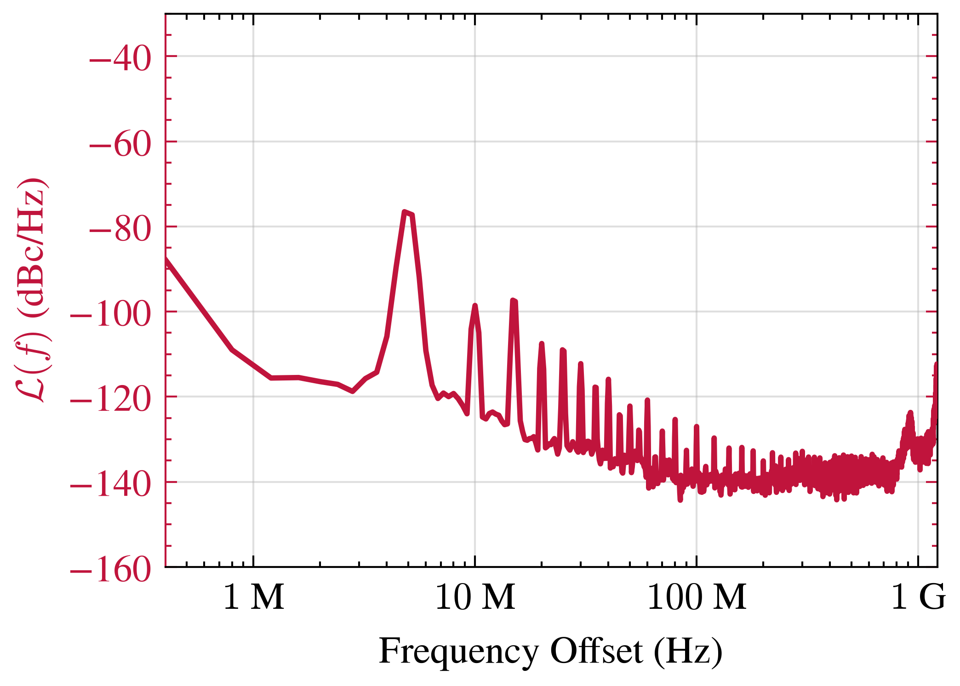
[picture p15: xschem/top-pll/plots/prelayout/phase_noise_with_tone_1.png]

<p align="center"><em>Figure 15: Steady-state closed-loop phase noise at a 2.44 GHz carrier (closed-loop run at schematic level). The peak at 5 MHz, and the smaller peaks at its multiples, come from the divider alternating between 240 and 248 — they are not noise</em></p>

> ngspice has no closed-loop PLL phase-noise analysis, so phase noise is derived by
> post-processing a long transient. The spectrum is taken from the **settled** portion
> only — including the acquisition transient corrupts it. The reference open-source work
> this is compared against uses the same method, so the comparison is like-for-like.

The peak at 5 MHz (about −77 dBc/Hz) is a discrete tone at f<sub>REF</sub>/2. With the
programmed code the ΔΣ modulator makes the divider alternate between ratios 240 and 248 on every
other reference period, so the average is 244 but the instantaneous ratio toggles by ±4. That
modulates the VCO at 5 MHz and at its harmonics, which is also why the 10 MHz reference spur
(§9.5) is one of the peaks. Read the noise level away from the tones: at 1 MHz it is about
−109 to −118 dBc/Hz, depending on the analysis window, and with the tones removed it is about
−122 dBc/Hz at 10 MHz. The paper's −100.8 dBc/Hz (§3.1) is not reproduced by this run. The
tone-free plots, the tone sizes (5 MHz: −17.7 dBc; 10 MHz: −40.7 dBc) and the other analysis
windows are in [`xschem/top-pll/plots/prelayout/`](xschem/top-pll/plots/prelayout/).

### 9.5 Reference Spur

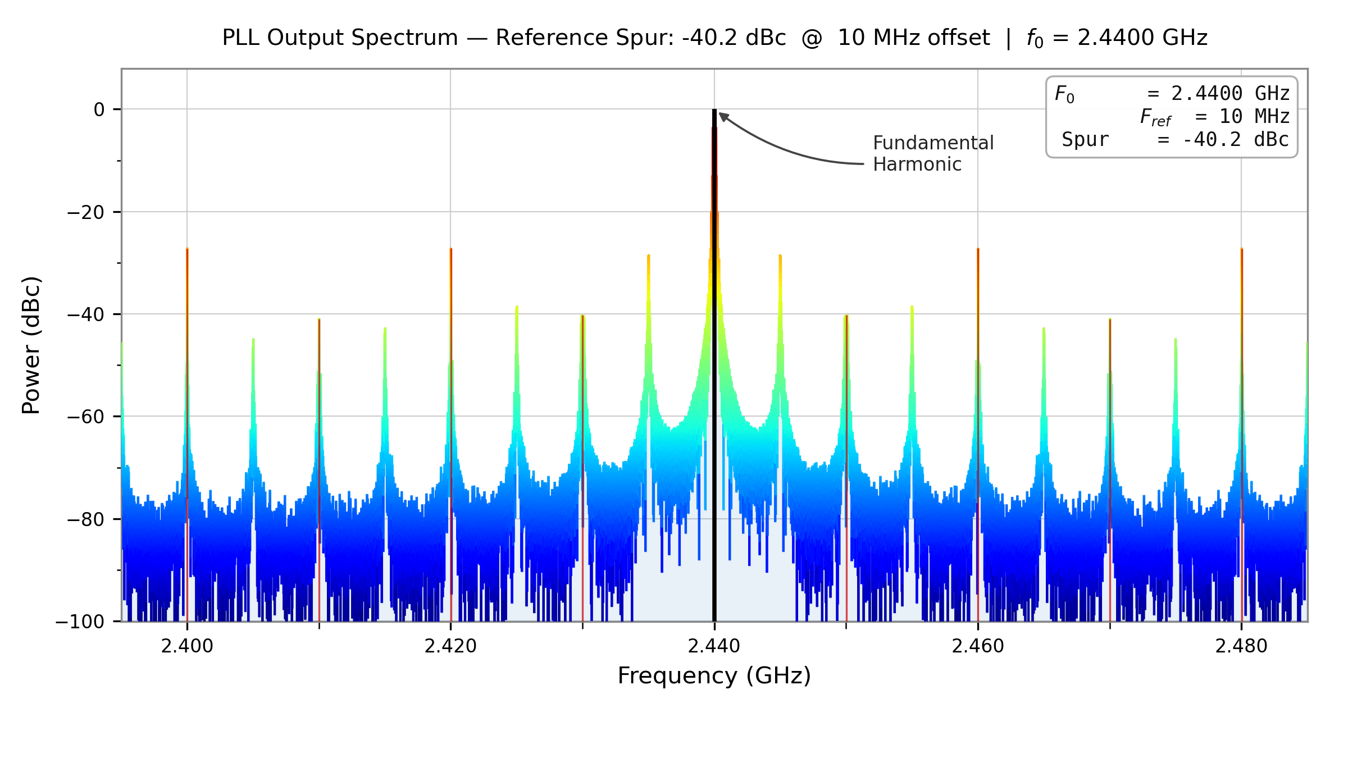
[picture p16: xschem/top-pll/plots/reference_spur_SA.png]

<p align="center"><em>Figure 16: Output spectrum showing the reference spur at f<sub>out</sub> ± 10 MHz</em></p>

At ≈ −40.2 dBc this is the weakest result in the design (the schematic-level run gives −40.7 dBc at 10 MHz; the larger tone at 5 MHz is not part of this figure). It clears BLE requirements but
misses the −60 dBc target. The two mechanisms are charge-pump up/down current mismatch
and finite loop-filter rejection at 10 MHz.

### 9.6 Comparison with Published Work

| PLL Architecture | VCO | Process | Frequency (GHz) | Phase Noise (dBc/Hz) | Power (mW) | Area (mm²) |
|---|-----|---|---|---|---|---|
| Integer-N PLL | Ring-Oscillator | 130 nm | 2.4 | −167.88 (@1 MHz) | 11.63 | 0.0495 |
| Integer-N PLL | CMOS LC VCO | 180 nm | 2.4 | −119 (@1 MHz) | 8 | 0.96 |
| CMOS LC-PLL | CMOS LC VCO | 65 nm | 10.3 | −95.12 (@1 MHz) | 6.8 | — |
| Fractional-N PLL | Multi-Core VCO | 130 nm | 0.125–8.4 | −152.9 (@10 MHz) | — | — |
| Fractional-N Oversampling PLL | CMOS LC VCO | 65 nm | 2.4 | −217.8 (FOM) | 4.97 | 0.58 |
| **Our Design [Fractional-N PLL]** | **CMOS LC VCO** | **130 nm** | **2.4** | **−100.8 (@1 MHz)** | **12.73** | **0.347** |

Most entries are published silicon; this work is post-layout simulation. The contribution
here is not a phase-noise record — it is that an LC tank with a real, EM-characterised
on-chip inductor can be built at all in a fully open-source flow.

**Future work.** Reference-spur suppression via charge-pump current matching and loop
filter optimisation; higher-order ∆Σ modulators and fast-locking techniques to reduce
fractional spurs and settling time.

### 9.7 Block-Level Pre- vs Post-Layout Comparison

Each block was simulated twice with the same testbench and stimulus: **pre-layout** on the
schematic netlist and **post-layout** on the layout-extracted netlist (the Magic RC extraction
archived in [`pex/`](pex/), and for the digital divider the layout-extracted netlist of the OpenLane
run). Conditions: V<sub>DD</sub> = 1.2 V, 27 °C, typical corner, ngspice. Each testbench is an xschem
schematic (`tb_<BLOCK>.sch` and `tb_<BLOCK>_PEX.sch`) whose waveform viewer shows the same
signals as its ngspice popup plots.

| Block | Metric | Pre-layout | Post-layout | Difference |
|---|---|---:|---:|---:|
| Bandgap reference | Output at 27 °C | 0.6024 V | 0.6026 V | +0.04 % |
| | Supply current | 183 µA | 183 µA | 0.0 % |
| Phase-frequency detector | `UP` average | 0.916 V | 0.901 V | −1.7 % |
| | `DN` average | 0.040 V | 0.057 V | +44 % (17 mV) |
| | `UP` second rising edge | 3.17 ns | 3.31 ns | +4.4 % |
| | `DN` second rising edge | 12.90 ns | 12.94 ns | +0.4 % |
| | Supply current (100 MHz test stimulus) | 20.0 µA | 25.8 µA | +29 % |
| Charge pump + loop filter | `CTRL` after 6 µs | 0.0770 V | 0.0691 V | −10 % |
| | `CTRL` peak | 1.176 V | 1.177 V | +0.1 % |
| | `VCP` peak | 1.283 V | 1.281 V | −0.2 % |
| | Supply current | 102.5 µA | 102.3 µA | −0.2 % |
| PFD + charge pump + loop filter (`PFD_CP_LF`) | `VCTRL` after 300 ns | 0.892 V | 0.877 V | −1.8 % |
| LC-VCO (with the EM-extracted inductor) | Oscillation frequency at V<sub>ctrl</sub> = 0.6 V | 2.416 GHz | 2.356 GHz | −2.5 % |
| | Output swing (`OUTp`) | 0.769 V<sub>pp</sub> | 0.749 V<sub>pp</sub> | −2.6 % |
| | Supply power | 0.93 mW | 1.00 mW | +8.6 % |
| ∆Σ modulator + divider (2.4 GHz, 1.2 V clock) | First output rising edge | 80.02 ns | 78.72 ns | −1.6 % |
| | First output falling edge | 131.69 ns | 130.35 ns | −1.0 % |
| | Output period (division ratio) | 103.334 ns (248.0) | 103.335 ns (248.0) | 0.0 % |

The blocks agree within a few percent wherever the quantity is a level or a frequency.
The larger percentages (`DN` average, the PFD supply current) are differences of a few tens of
millivolts or microamps on small signals. The 2.5 % lower VCO frequency is the expected effect of
the added interconnect capacitance; the inductor is the EM model in both runs (the extraction
covers the rest of the VCO only, see §9.1 and §9.8).

> **DSM testbench.** The divider runs at the PLL's own condition: a 2.4 GHz, 1.2 V input clock
> (what the VCO delivers) with the reset, enable and serial-load stimulus of `stimuli_test.cir`,
> a 10 ps step and a 250 ns window. Pre-layout uses the compiled behavioural divider
> (`dsm_and_freq_divider.so`); post-layout uses the transistor-level netlist extracted from the
> layout by the OpenLane flow (standard cells from the PDK, no parasitic elements), so the
> comparison is transistor level against the ideal model. Both divide by 248. The paper
> testbench's original 10 MHz, 1.8 V clock works pre-layout (first edge at 5.709 µs) but makes
> the transistor-level netlist abort at about 15 µs, so it is not used post-layout.

Testbenches: `tb_BGR`, `tb_PHASE_FREQ_DET`, `tb_CP_LF`, `tb_DSM_N_FREQ_DIV` and `LC_VCO_tb`
(pre-layout) and the matching `*_PEX` testbenches, including `LC_VCO_PEX_tb` (post-layout), in
[`xschem/`](xschem/), with their netlists in [`simulations/`](simulations/).
The full closed-loop PLL is not simulated on the transistor-level extracted netlist: at 10 ps
steps it runs at roughly 4 ns of simulated time per minute on the machine used here, so 40 µs
would take weeks.

### 9.8 LC-VCO Tuning: Pre- vs Post-Layout

The LC-VCO alone was swept over V<sub>CTRL</sub> = 0 – 1.2 V in 0.1 V steps at V<sub>DD</sub> = 1.2 V,
V<sub>BGR</sub> = 0.6 V, 27 °C, typical corner (10 ps step, frequency from 20 oscillation cycles
after start-up). **Pre-layout** is the schematic netlist; **post-layout** is the Magic RC
extraction of `LC_VCO_NOIND` with the EM-extracted 4 nH inductor across `OUTp`/`OUTn` (§9.1). In
a noise-free simulation the oscillator can stay at its unstable equilibrium, so a small initial
voltage on `OUTp` starts the oscillation.

| Metric | Pre-layout | Post-layout |
|---|---:|---:|
| f<sub>osc</sub> at V<sub>CTRL</sub> = 0 V | 2.3840 GHz | 2.3255 GHz |
| f<sub>osc</sub> at V<sub>CTRL</sub> = 0.6 V | 2.4160 GHz | 2.3556 GHz |
| f<sub>osc</sub> at V<sub>CTRL</sub> = 1.2 V | 2.4906 GHz | 2.4256 GHz |
| Tuning range (of centre frequency) | 4.4 % | 4.2 % |
| V<sub>CTRL</sub> for 2.40 GHz | 0.39 V | 0.99 V |
| V<sub>CTRL</sub> for 2.48 GHz | 1.12 V | not reached |
| Peak K<sub>VCO</sub> (near 1.0 V) | 134 MHz/V | 126 MHz/V |
| Mean K<sub>VCO</sub>, 0.4 – 1.2 V | 112 MHz/V | 106 MHz/V |
| Mean K<sub>VCO</sub>, 0.7 – 1.2 V | 129 MHz/V | 121 MHz/V |
| VCO core power | 0.93 mW | 1.00 mW |
| Tank swing at `OUTp` | 0.75 – 0.80 V<sub>pp</sub> | 0.74 – 0.77 V<sub>pp</sub> |

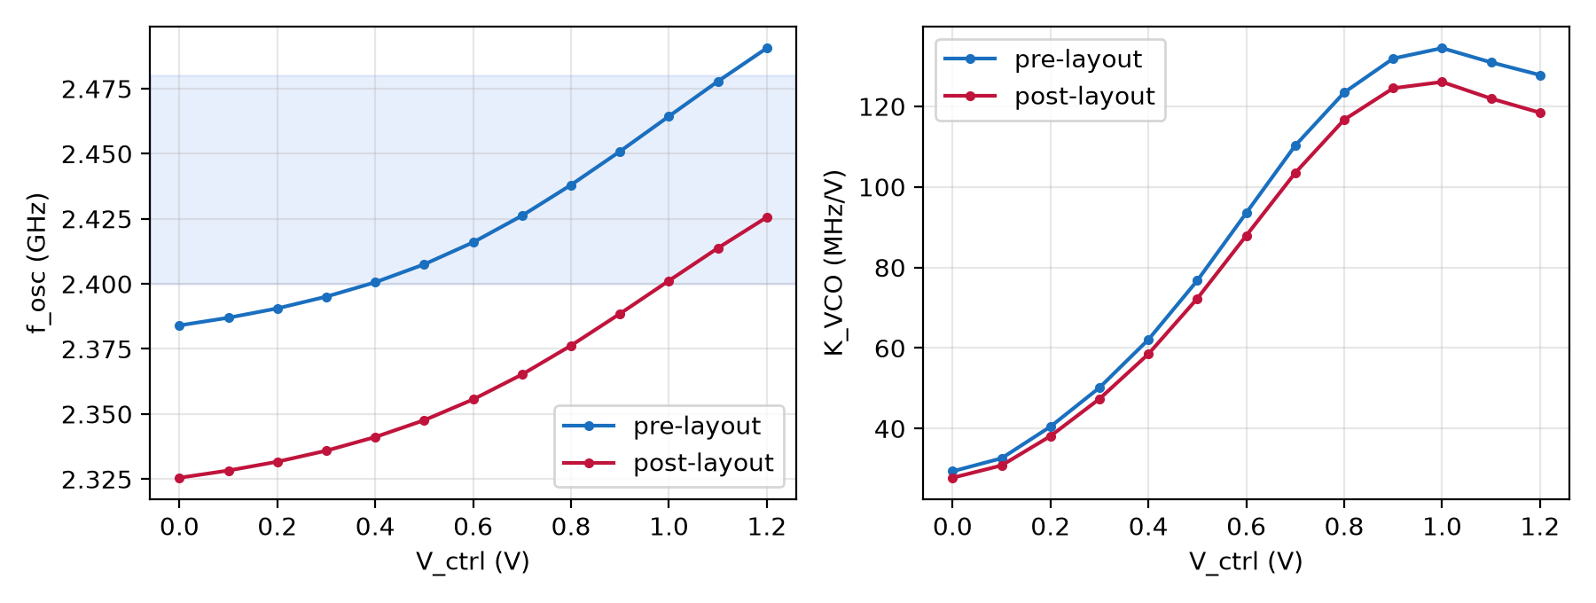
[picture p17: xschem/top-pll/plots/vco_tuning_pre_vs_post.png]

<p align="center"><em>Figure 17: LC-VCO frequency and K<sub>VCO</sub> against V<sub>CTRL</sub>, pre- and post-layout; the shaded band is 2.40 – 2.48 GHz</em></p>

K<sub>VCO</sub> is not constant: it rises from about 30 MHz/V at 0 V to a peak near 1.0 V. The
paper's ≈ 120 MHz/V corresponds to the mean slope over the operating region (0.4 – 1.2 V:
112 MHz/V pre-layout, 106 MHz/V post-layout; 0.7 – 1.2 V: 129 and 121 MHz/V). The pre-layout
sweep reproduces the paper's tuning curve — 2.40 GHz at 0.39 V and 2.48 GHz at 1.12 V, against
0.40 V and 1.10 V from the paper's points.

**Post-layout shortfall.** The layout parasitics lower the frequency by about 2.5 % (≈ 60 MHz) at
every control voltage. With V<sub>CTRL</sub> limited to 1.2 V the extracted VCO reaches 2.4256 GHz, so it
cannot cover the top of the 2.40 – 2.48 GHz band, and the higher division ratios of the
240 – 248 range are out of reach. This revision keeps the layout as taped out. A frequency
recovery would need about 5 % less tank capacitance (≈ 55 – 60 fF, estimated from the 1/√C
scaling), which is a schematic and layout change and is left to a later revision.

Data and plots: [`vco_tuning_pre.csv`](xschem/top-pll/simulations/vco_tuning_pre.csv),
[`vco_tuning_post.csv`](xschem/top-pll/simulations/vco_tuning_post.csv) and
[`plots/`](xschem/top-pll/plots/) (`vco_tuning_pre.png`, `vco_tuning_post.png`,
`vco_tuning_pre_vs_post.png`, drawn with `plot_vco_paper.py`).

[Return to top](#toc)

---

## 10. UNIC-CASS Tapeout

The design is submitted through the **UNIC-CASS** programme, which fabricates user
designs on a shared shuttle using the IHP open-source PDK. The design is integrated into
the [unic-cass-wrapper](https://github.com/unic-cass/unic-cass-wrapper), a lightweight
chip integration template that provides the pad ring and chip-level interface.

### GPIO Configuration

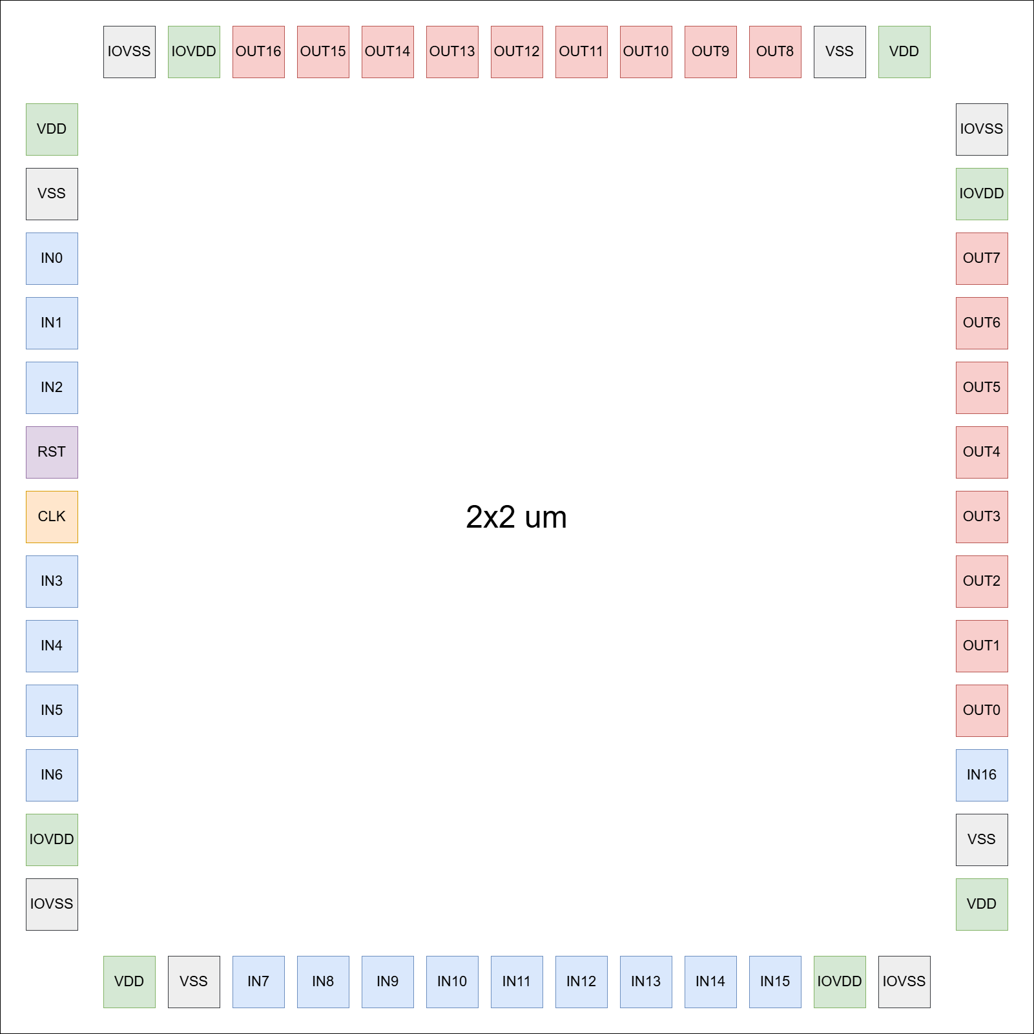
[picture p18: docs/img/unic-cass-mock-tapeout-pinlist.png]

<p align="center"><em>Figure 18: Shuttle GPIO assignment</em></p>

### Layout Integration

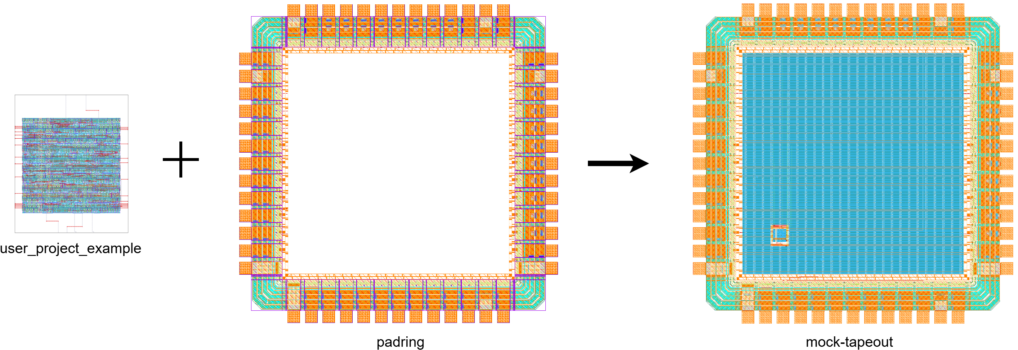
[picture p19: docs/img/unic-cass-mock-tapeout.png]

<p align="center"><em>Figure 19: Integration of user projects into the shuttle</em></p>

### Final Chip

Team 1 integrates three analog designs behind one pad ring, in the
[unic-cass-2025-analog-team1](https://github.com/manuel-monge/unic-cass-2025-analog-team1)
repository. The PLL is taken from its own repository at commit `bc5ef31`, together with the
XPCAM and the multiplier. The final top cell is `MPC0388`: the `team1` integration, the seal
ring and the density fill, on a 2000 µm × 2000 µm die.

| Block | Position on the die (µm) | Source |
|---|---|---|
| `LC_VCO_FPLL` (this PLL, rotated 90°) | x 697 – 1363, y 754 – 1659 | [avishkaherath/LC_VCO_FPLL](https://github.com/avishkaherath/LC_VCO_FPLL) |
| `TOP_XPCAM` | x 1435 – 1618, y 612 – 724 | [EstebanJGC/IHP__CMP9794](https://github.com/EstebanJGC/IHP__CMP9794) |
| `multiplier_top` | x 448 – 622, y 1107 – 1386 | [LohanAtapattu/Unic_Cass_IHP](https://github.com/LohanAtapattu/Unic_Cass_IHP) |

The integration repository reports DRC and LVS clean for the three integrated top cells and
for the chip-level integration before fill. DRC and LVS were not re-run for the copy kept
here. The PLL inside the chip is the layout of this repository: compared layer by layer with
[`gds/LC_VCO_FPLL.gds`](gds/LC_VCO_FPLL.gds), 69 of the 71 layers are identical and the other
two differ by 22.8 µm² of Metal1 and a full-cell marker on layer 189/0.

The screenshots below were taken in KLayout in editor mode with the SG13G2 technology. The
density fill cells were removed from a temporary copy so that the circuit is visible; the
delivered GDS is unchanged.

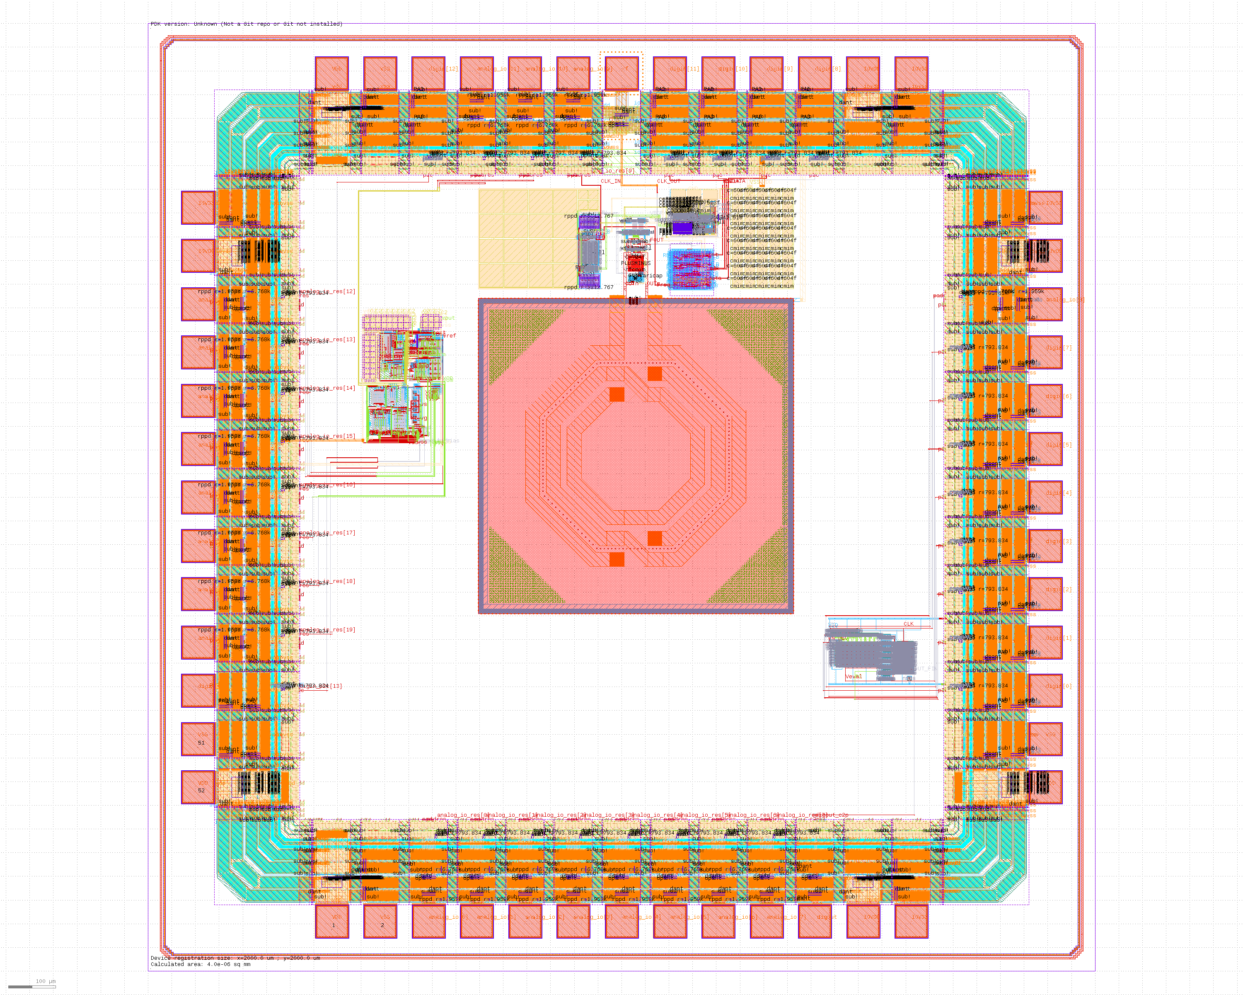
[picture p20: images/final-chip-layout.png]

<p align="center"><em>Figure 20: Final chip <code>MPC0388</code> in KLayout — 2000 µm × 2000 µm, PLL and its on-chip inductor at the centre, pad ring around it</em></p>

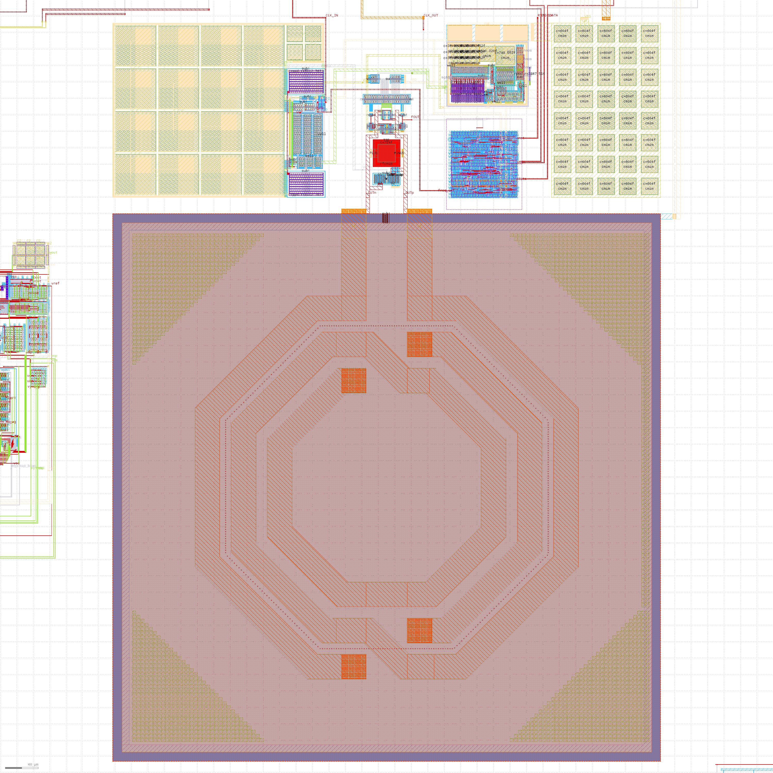
[picture p21: images/final-chip-pll-layout.png]

<p align="center"><em>Figure 21: The PLL inside the chip — inductor below, PFD/CP/LF, divider and bandgap above it</em></p>

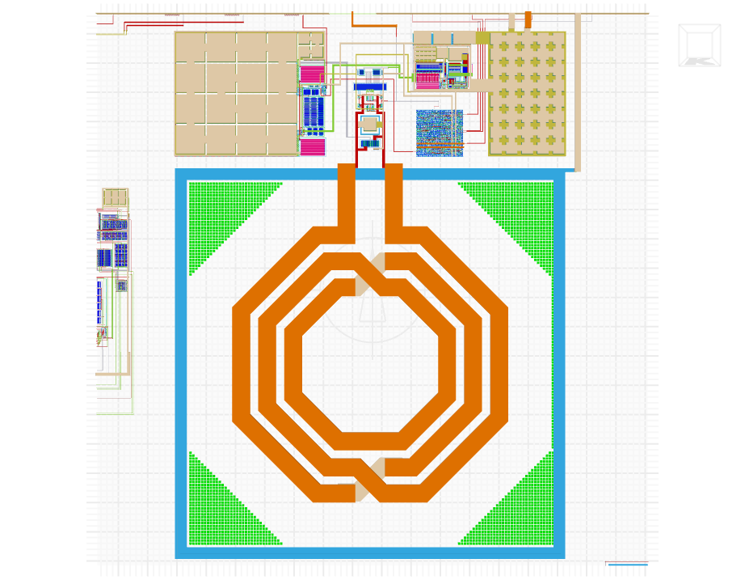
[picture p22: images/final-chip-2.5d-top.png]

<p align="center"><em>Figure 22: 2.5D view of the PLL region from above — TopMetal2 spiral, TopMetal1 underpass and the Metal1 guard ring</em></p>

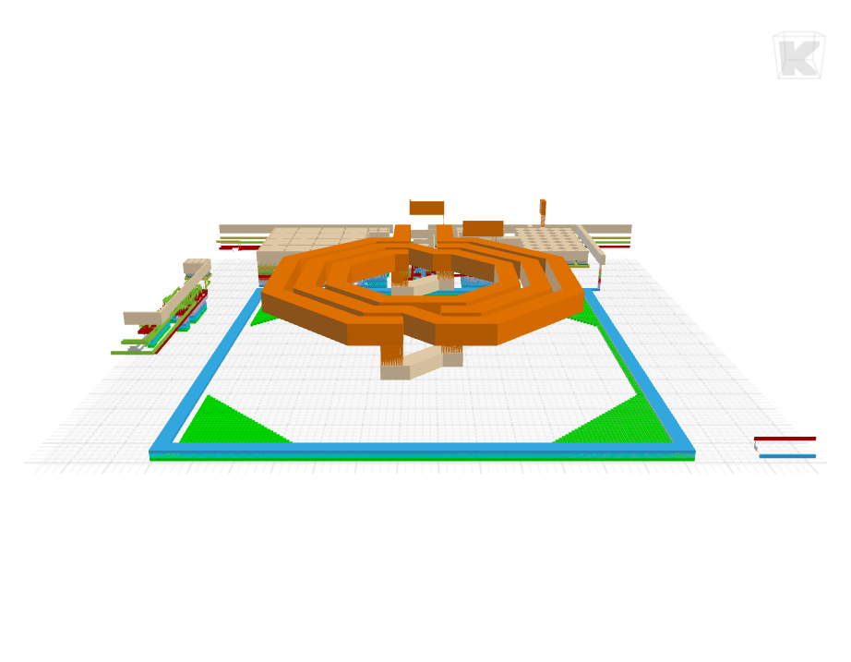
[picture p23: images/final-chip-2.5d-tilt.png]

<p align="center"><em>Figure 23: 2.5D view of the PLL region from an oblique angle, vertical scale ×10</em></p>

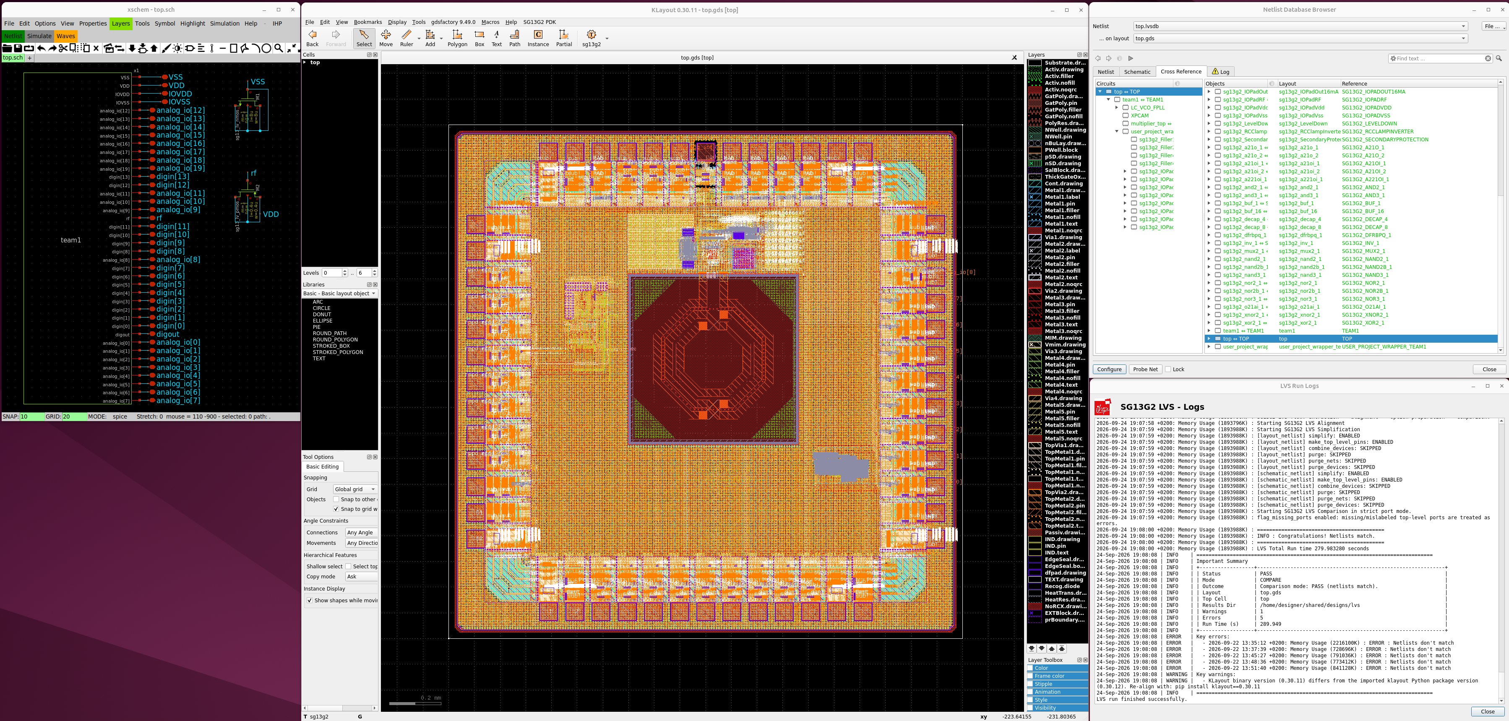
[picture p24: images/Final_chip_uniccass.png]

<p align="center"><em>Figure 24: Final chip — top-level schematic, top-level layout with the on-chip inductor, cross-reference, and the top-level LVS run (netlists match)</em></p>

The wrapper mandates a fixed 17-in / 17-out pad interface. That budget is why this PLL
loads its division ratio over a 3-wire serial interface rather than nine parallel pins.

> A 2.4 GHz output through a general-purpose digital pad is the weak point of this
> arrangement — pad and bond-wire parasitics dominate at that frequency. Plan the bench
> measurement accordingly: a divided-down output, or on-wafer probing.

The final chip is in [`UNIC-CASS-2025/final-chip/`](UNIC-CASS-2025/final-chip/) (GDS and
top-level schematics, with a README on provenance and verification status); the mock-tapeout
data is in [`UNIC-CASS-2025/mock-tapeout/`](UNIC-CASS-2025/mock-tapeout/). The wrapper flow is
documented in [`docs/README.md`](docs/README.md).

[Return to top](#toc)

---

## 11. Repository Structure

| Path | Contents |
|---|---|
| [`xschem/`](xschem/) | Schematics and symbols, grouped by block |
| [`spice/`](spice/) | Netlists exported from Xschem — the golden netlists LVS compares against |
| [`simulations/`](simulations/) | Testbench netlists and simulation decks |
| [`gds/`](gds/) | Layouts — `LC_VCO_FPLL.gds` (top) and `blocks/` |
| [`drc/`](drc/), [`lvs/`](lvs/), [`pex/`](pex/) | Archived verification runs, one directory per cell |
| [`em/`](em/) | **Open-source inductor EM flow: GDS → OpenEMS → SPICE** |
| [`model/`](model/) | Analytical sizing notebooks, gm/I<sub>D</sub> lookup tables, Qucs-S models |
| [`docs/`](docs/) | Documentation and images |
| [`archive/hfss/`](archive/hfss/) | Ansys HFSS characterisation of the inductor, kept for cross-reference against `em/` |
| [`UNIC-CASS-2025/`](UNIC-CASS-2025/) | Mock-tapeout wrapper data and the final-chip submission (top-level GDS, schematics) |
| [`paper_submission/`](paper_submission/) | Manuscripts and figure sources |

Working in this repository with an AI coding agent? See [`CLAUDE.md`](CLAUDE.md) for the
conventions, environment setup and known issues.

> **Windows users:** clone with `git clone -c core.longpaths=true ...` — some archived
> paths approach the 260-character limit and checkout otherwise fails partway.

[Return to top](#toc)

---

## 12. Publication

Accepted for presentation at the **International Conference on Synthesis, Modeling,
Analysis and Simulation Methods, and Applications to Circuit Design (SMACD) 2026**.

> M. Thiriloganathan, S. Ranasinghe, A. Herath, R. Rameshkumar, H. Marasinghe,
> A. Viduranga, G. Leelarathne and K. Wickremasinghe,
> "**A 2.4 GHz LC-VCO Fractional-N Phase Locked Loop Open-Source Design in 130-nm
> BiCMOS**," *SMACD*, 2026.

Paper: [IEEE Xplore, document 11647761](https://ieeexplore.ieee.org/document/11647761)

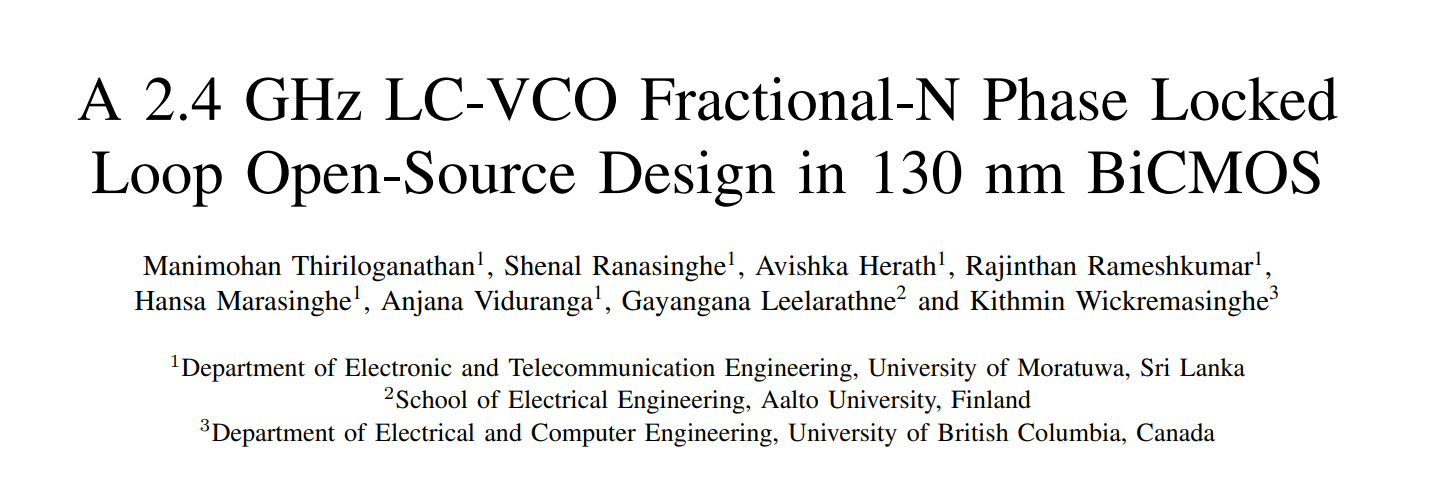
[picture p25: images/smacd_paper.png]

<p align="center"><em>Figure 25: SMACD 2026 paper</em></p>

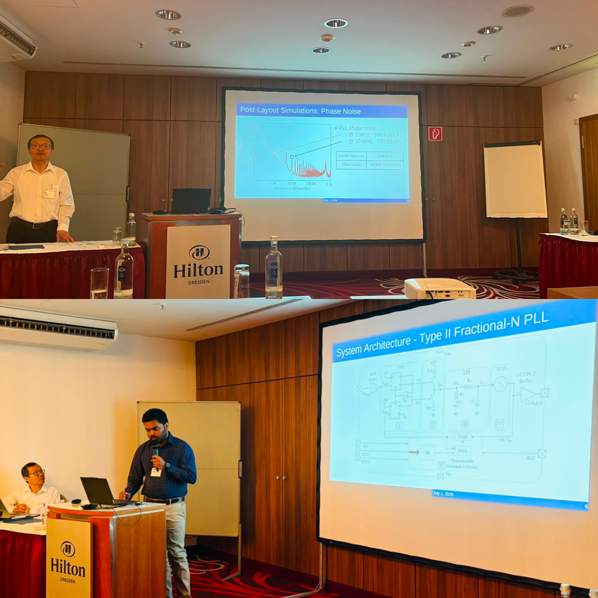
[picture p26: images/SMACD_2026_conference_presentation.jpg]

<p align="center"><em>Presenting the paper at SMACD 2026, Dresden</em></p>

Manuscripts and figure sources are in [`paper_submission/`](paper_submission/).

### In the news


<p align="center"><em>Figure 26: Coverage by the Department of Electronic and Telecommunication Engineering, University of Moratuwa</em></p>

[Return to top](#toc)

---

## 13. References

Built with the [IIC-OSIC-TOOLS](https://github.com/iic-jku/IIC-OSIC-TOOLS) open-source IC design container:

> H. Pretl and G. Zachl, "GitHub repository of the IIC-OSIC-TOOLS," 2022.
> [https://github.com/iic-jku/IIC-OSIC-TOOLS](https://github.com/iic-jku/IIC-OSIC-TOOLS)

```bibtex
@software{Pretl_IIC-OSIC-TOOLS_2022,
  author = {Pretl, Harald and Zachl, Georg},
  title = {{GitHub repository of the IIC-OSIC-TOOLS}},
  year = {2022},
  url = {https://github.com/iic-jku/IIC-OSIC-TOOLS}
}
```

The following open-source PLL designs were referred to during development:

- Our past IHP openMPW submission (30 MHz Fractional-N PLL) — [TO_July2025](https://github.com/avishkaherath/TO_July2025/blob/main/30_MHz_Fractional_N_PLL/doc/source/designdata.rst)
- The 2025 IHP tapeout PLL — [cmos-pll-ihp-sg13g2](https://github.com/SkillSurf/cmos-pll-ihp-sg13g2)
- tt08-tiny-pll — [https://github.com/LegumeEmittingDiode/tt08-tiny-pll](https://github.com/LegumeEmittingDiode/tt08-tiny-pll)
- Razavi papers

Cited in the paper:

1. N. F. Assaify *et al.*, "A ring-oscillator-based 2.4 GHz integer-N PLL design in skywater 130nm open-source technology," in *ISPACS*, 2025.
2. B. Razavi, "Education of chip designers at a large scale: A proposal," *IEEE Solid-State Circuits Mag.*, 2024.
3. K. Herman *et al.*, "On the versatility of the IHP BiCMOS open source and manufacturable PDK," *IEEE Solid-State Circuits Mag.*, vol. 16, no. 2, pp. 30–38, 2024.
4. D. Liao *et al.*, "A 2.4-GHz 16-phase sub-sampling fractional-N PLL with robust soft loop switching," *IEEE J. Solid-State Circuits*, 2018.
5. G. Z. Gomez *et al.*, "Bluetooth low energy (BLE) radio design trends and considerations," *Electronics*, 2021.
6. B. Razavi, *RF Microelectronics*. Pearson, 2011.
7. S. S. Mohan *et al.*, "Simple accurate expressions for planar spiral inductances," *IEEE J. Solid-State Circuits*, 1999.
8. T. Liebig *et al.*, "openEMS — a free and open source equivalent-circuit (EC) FDTD simulation platform," *Int. J. Numer. Model.*, 2013.
9. F. Zhang *et al.*, "Design optimization and modeling of on-chip RF inductors in CMOS," in *IEEE MWSCAS*, 2009.
10. D. Ham and A. Hajimiri, "Concepts and methods in optimization of integrated LC VCOs," *IEEE J. Solid-State Circuits*, 2001.
11. J. Jo *et al.*, "Low phase-noise, 2.4 and 5.8 GHz dual-band frequency synthesizer with Class-C VCO and bias-controlled charge pump," *Electronics*, 2022.
12. J. S. Gaggatur *et al.*, "A digitally programmable 9.1–11.2 GHz CMOS LC-PLL with integrated power management for X-Band FMCW radar systems," in *IEEE SPACE*, 2025.
13. H. Shi *et al.*, "An ultra-wideband 125-MHz-to-8.4-GHz fractional-N PLL featuring an isolated multi-core VCO and an active-feedback doubler," *IEEE Microw. Wireless Technol. Lett.*, 2026.
14. J. Qiu *et al.*, "A 32-kHz-reference 2.4-GHz Fractional-N oversampling PLL with 200-kHz loop bandwidth," *IEEE J. Solid-State Circuits*, 2021.

[Return to top](#toc)
