Manimohan05/SG13G2_2.4GHz_LC_VCO_FPLL/HFSS Inductor Files/HFSS_Layer_Stackup_Reference.pdf

# HFSS 3D Layout - IHP Technology Layer Stackup Definition

EM Simulation Setup Reference

February 1, 2026

## 1 Material Properties

### 1.1 Conductor Materials

Material Name | Conductivity (S/m) | Permit. | Color
Activ Metal1 Metal2 Metal3 Metal4 Metal5 TopMetal1 TopMetal2 TopVia2 TopVia1 Via4 Via3 Via2 Via1 Cont LOWLOSS | 3.57141e5 2.164e7 2.319e7 2.319e7 2.319e7 2.319e7 2.78e7 3.03e7 3.143e6 2.191e6 1.66e6 1.66e6 1.66e6 1.66e6 2.39e6 1e10 | 1 1 1 1 1 1 1 1 1 1 1 1 1 1 1 1 | 00ff00 39bfff ccccd9 d80000 93e837 dcd146 ffe6bf ff8000 ff8000 ffe6bf deac5e 9ba940 ff3736 ccccff 00ffff ff0000

### 1.2 Dielectric Materials

Material | Permit. | Loss Tan. | Cond. | Color
Passive SiO2 AIR MIM equiv | 6.6 4.1 1.0 16.87 | 0.0 0.0 0.0 0.0 | 0 0 0 0 | a0a0f0 fffcad d0d0d0 ff0000

### 1.3 Semiconductor Materials

Material | Permit. | Loss Tan. | Cond. (S/m) | Color
Substrate EPI | 11.9 11.9 | 0 0 | 2.0 5.0 | 01e0ff 294fff

1

## 2 Complete Layer Stackup (Bottom to Top)

Important Setup Parameters:

| Substrate Offset: 283.75 µ m
| Length Unit: Micrometers ( µm)
| Layer Type: Use “signal” for all conductor/via layers, “dielectric” for dielectric layers
# | Layer Name | Type | Zmin | Zmax | Thick. | Material | L#

SUBSTRATE REGION
1 | Substrate | dielectric | -283.75 | -3.75 | 280.00 | Substrate | -
2 | SUBGND | signal | -283.75 | -283.75 | 0.00 | LOWLOSS | 210
3 | EPI | dielectric | -3.75 | 0.00 | 3.75 | EPI | - ACTIVE & INTERCONNECT REGION
4 | Activ | signal | 0.00 | 0.40 | 0.40 | Activ (3.57e5) | 1
5 | Passive fill | dielectric | 0.40 | 1.04 | 0.64 | Passive | -
6 | Cont | signal | 0.40 | 1.04 | 0.64 | Cont (2.39e6) | 6
METAL1 LAYER
7 | SiO2 fill | dielectric | 1.04 | 1.46 | 0.42 | SiO2 | -
8 | Metal1 | signal | 1.04 | 1.46 | 0.42 | Metal1 (2.164e7) | 8
9 | SiO2 fill Via1 | dielectric signal | 1.46 1.46 | 2.00 2.00 | 0.54 0.54 | SiO2 Via1 (1.66e6) | 19 - 10

METAL2 LAYER
11 | SiO2 fill Metal2 | dielectric signal | 2.00 2.00 | 2.49 2.49 | 0.49 0.49 | SiO2 Metal2 (2.319e7) | 10 - 12
13 | SiO2 fill Via2 | dielectric signal | 2.49 2.49 | 3.03 3.03 | 0.54 0.54 | SiO2 Via2 (1.66e6) | 29 - 14

METAL3 LAYER
15 | SiO2 fill Metal3 | dielectric signal | 3.03 3.03 | 3.52 3.52 | 0.49 0.49 | SiO2 Metal3 (2.319e7) | 30 - 16
17 | SiO2 fill Via3 | dielectric signal | 3.52 3.52 | 4.06 4.06 | 0.54 0.54 | SiO2 Via3 (1.66e6) | 49 - 18

METAL4 LAYER
19 | SiO2 fill | dielectric | 4.06 | 4.55 | 0.49 | SiO2 | -

2

# | Layer Name | Type | Zmin | Zmax | Thick. | Material | L#

20 | Metal4 | signal | 4.06 | 4.55 | 0.49 | Metal4 (2.319e7) | 50
21 | SiO2 fill Via4 | dielectric signal | 4.55 4.55 | 5.09 5.09 | 0.54 0.54 | SiO2 Via4 (1.66e6) | 66 - 22

METAL5 & MIM LAYERS
23 | SiO2 fill Metal5 | dielectric signal | 5.09 5.09 | 5.58 5.58 | 0.49 0.49 | SiO2 Metal5 (2.319e7) | 67 - 24
25 | MIM DK | dielectric | 5.58 | 5.68 | 0.10 | MIM equiv | 136
26 | MIM | signal | 5.68 | 5.78 | 0.10 | Metal5 (2.319e7) | 137
27 | SiO2 fill TopVia1 | dielectric signal | 5.58 5.58 | 6.43 6.43 | 0.85 0.85 | SiO2 TopVia1 | - 28
(2.191e6) | 125

TOPMETAL1 LAYER
29 | SiO2 fill TopMetal1 | dielectric signal | 6.43 6.43 | 8.43 8.43 | 2.00 2.00 | SiO2 TopMetal1 | - 30
| | | | | | (2.78e7) | 126
31 | SiO2 fill TopVia2 | dielectric signal | 8.43 8.43 | 11.23 11.23 | 2.80 2.80 | SiO2 TopVia2 | - 32
(3.143e6) | 133

TOPMETAL2 LAYER (TOP)
33 | SiO2 fill TopMetal2 | dielectric signal | 11.23 11.23 | 14.23 14.23 | 3.00 3.00 | SiO2 TopMetal2 | - 34
(3.03e7) | 134
35 | AIR | dielectric | 14.23 | 314.23 | 300.00 | AIR | - Table 4: Complete unified stackup with conductors and dielectric

fillers (all dimensions in

µm)

3

## 3 Manual Entry Steps in HFSS 3D Layout

### 3.1 Material Properties Quick Reference

| Conductors: Activ (3.57e5), Metal1 (2.164e7), Metal2-5 (2.319e7), TopMetal1 (2.78e7), TopMetal2 (3.03e7), Cont (2.39e6), Via1-4 (1.66e6), TopVia1 (2.191e6), TopVia2 (3.143e6), LOWLOSS (1e10)
| Dielectrics: SiO2 (εr=4.1), Passive (εr=6.6), AIR (εr=1.0), MIM equiv (εr=16.87)
| Semiconductors: Substrate (εr=11.9, σ=2.0), EPI (εr=11.9, σ=5.0)

### 3.2 Stackup Entry Procedure

1. Create all materials first using the tables above
2. In Layer Stackup Manager, set Substrate Offset = 283.75 µm
3. Enter layers from bottom to top following the unified stackup table
4. For conductor layers: Enter Name, Type=signal, Zmin, Zmax, Material, Layer#
5. For dielectric fill: Enter Name, Type=dielectric, Zmin, Zmax, Material (no Layer# needed)
6. Note: Dielectric fills represent the insulating material between and around conductors

4
