Manimohan05/SG13G2_2.4GHz_LC_VCO_FPLL/xschem/top-pll/plots/regenerated/vco_phase_noise_from_transient.pdf

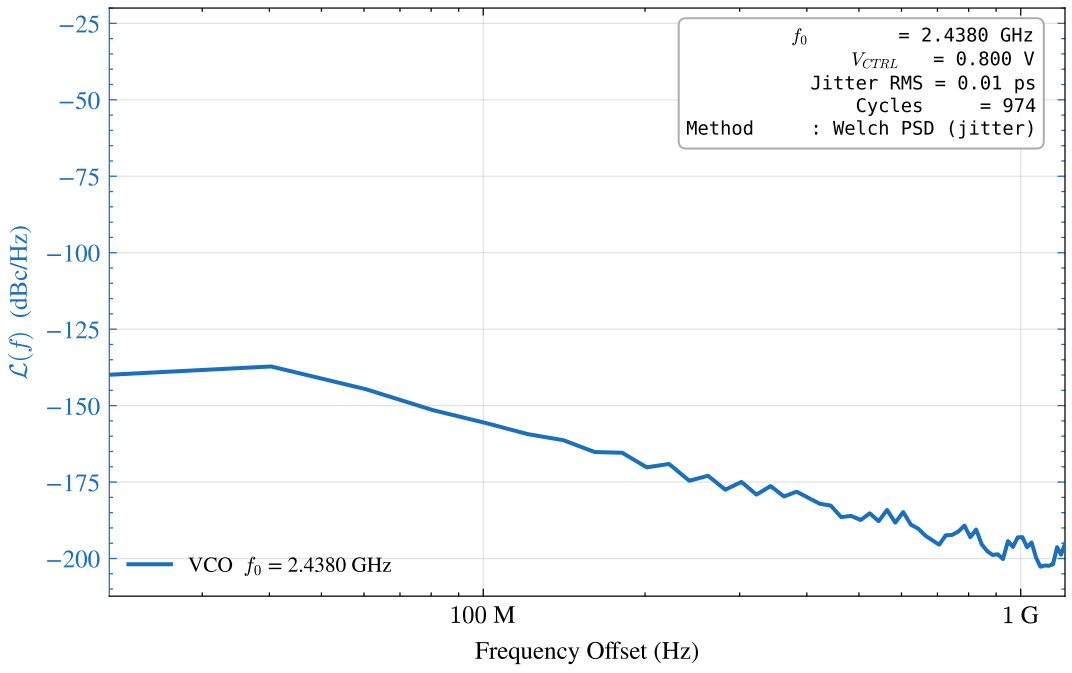
[picture p41: figure]
Frequency Offset (Hz); VCO f0 = 2.4380 GHz

f0 = 2.4380 GHz VCTRL = 0.800 Jitter RMS = 0.01 ps | V

Cycles = 974 Method : Welch PSD (jitter)

LC-VCO Phase Noise | f0 = 2.4380 GHz | VCTRL = 0.80 V
