Manimohan05/SG13G2_2.4GHz_LC_VCO_FPLL/xschem/dsm/src/runs/RUN_2026-03-04_15-08-00/56-openroad-irdropreport/net-VGND.csv

Instance | Terminal | Layer | X location | Y location | Voltage
FILLER_20_160 | VSS | Metal1 | 84.2460 | 91.1800 | 0.008477
FILLER_20_153 | VSS | Metal1 | 80.8860 | 91.1800 | 0.008477
FILLER_20_146 | VSS | Metal1 | 77.5260 | 91.1800 | 0.008477
FILLER_20_139 | VSS | Metal1 | 74.1660 | 91.1800 | 0.008477
FILLER_20_132 | VSS | Metal1 | 70.8060 | 91.1800 | 0.008477
FILLER_20_125 | VSS | Metal1 | 67.4460 | 91.1800 | 0.008477
FILLER_20_118 | VSS | Metal1 | 64.0860 | 91.1800 | 0.008477
FILLER_20_111 | VSS | Metal1 | 60.7260 | 91.1800 | 0.008477
FILLER_20_104 | VSS | Metal1 | 57.3660 | 91.1800 | 0.008477
FILLER_20_97 | VSS | Metal1 | 54.0060 | 91.1800 | 0.008477
FILLER_20_91 | VSS | Metal1 | 49.9200 | 90.7200 | 0.008477
FILLER_20_84 | VSS | Metal1 | 47.7660 | 91.1800 | 0.008105
FILLER_20_77 | VSS | Metal1 | 44.4060 | 91.1800 | 0.007712
FILLER_20_70 | VSS | Metal1 | 41.0460 | 91.1800 | 0.006476
FILLER_20_63 | VSS | Metal1 | 37.6860 | 91.1800 | 0.005240
FILLER_20_56 | VSS | Metal1 | 34.3260 | 91.1800 | 0.004004
FILLER_20_49 | VSS | Metal1 | 30.9660 | 91.1800 | 0.002768
FILLER_20_42 | VSS | Metal1 | 27.6060 | 91.1800 | 0.001532
FILLER_20_35 | VSS | Metal1 | 24.2460 | 91.1800 | 0.000296
FILLER_20_28 | VSS | Metal1 | 20.8860 | 91.1800 | 0.000308
FILLER_20_21 | VSS | Metal1 | 17.5260 | 91.1800 | 0.000308
FILLER_20_14 | VSS | Metal1 | 14.1660 | 91.1800 | 0.000308
FILLER_20_7 | VSS | Metal1 | 10.8060 | 91.1800 | 0.000316
FILLER_20_0 | VSS | Metal1 | 7.4460 | 91.1800 | 0.000338
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
_121_ | VSS | Metal1 | 12.5120 | 52.6500 | 0.000073
_120_ | VSS | Metal1 | 12.5120 | 60.2100 | 0.000184
_119_ | VSS | Metal1 | 12.5120 | 68.3090 | 0.000089
_118_ | VSS | Metal1 | 12.5120 | 75.8690 | 0.000035
_117_ | VSS | Metal1 | 12.5120 | 90.4500 | 0.000314
