Manimohan05/SG13G2_2.4GHz_LC_VCO_FPLL/xschem/dsm/src/runs/RUN_2026-03-04_15-08-00/56-openroad-irdropreport/net-VPWR.csv

Instance | Terminal | Layer | X location | Y location | Voltage
FILLER_20_160 | VDD | Metal1 | 84.2490 | 93.9010 | 1.199844
FILLER_20_153 | VDD | Metal1 | 80.8890 | 93.9010 | 1.199844
FILLER_20_146 | VDD | Metal1 | 77.5290 | 93.9010 | 1.199844
FILLER_20_139 | VDD | Metal1 | 74.1690 | 93.9010 | 1.199844
FILLER_20_132 | VDD | Metal1 | 70.8090 | 93.9010 | 1.199844
FILLER_20_125 | VDD | Metal1 | 67.4490 | 93.9010 | 1.199844
FILLER_20_118 | VDD | Metal1 | 64.0890 | 93.9010 | 1.199844
FILLER_20_111 | VDD | Metal1 | 60.7290 | 93.9010 | 1.199844
FILLER_20_104 | VDD | Metal1 | 57.3690 | 93.9010 | 1.199844
FILLER_20_97 | VDD | Metal1 | 54.0090 | 93.9010 | 1.199844
FILLER_20_91 | VDD | Metal1 | 49.9200 | 94.5000 | 1.199894
FILLER_20_84 | VDD | Metal1 | 47.7690 | 93.9010 | 1.199896
FILLER_20_77 | VDD | Metal1 | 44.4090 | 93.9010 | 1.199906
FILLER_20_70 | VDD | Metal1 | 41.0490 | 93.9010 | 1.199916
FILLER_20_63 | VDD | Metal1 | 37.6890 | 93.9010 | 1.199926
FILLER_20_56 | VDD | Metal1 | 34.3290 | 93.9010 | 1.199937
FILLER_20_49 | VDD | Metal1 | 30.9690 | 93.9010 | 1.199947
FILLER_20_42 | VDD | Metal1 | 27.6090 | 93.9010 | 1.199957
FILLER_20_35 | VDD | Metal1 | 24.2490 | 93.9010 | 1.199967
FILLER_20_28 | VDD | Metal1 | 20.8890 | 93.9010 | 1.199977
FILLER_20_21 | VDD | Metal1 | 17.5290 | 93.9010 | 1.199986
FILLER_20_14 | VDD | Metal1 | 14.1690 | 93.9010 | 1.199986
FILLER_20_7 | VDD | Metal1 | 10.8090 | 93.9010 | 1.199986
FILLER_20_0 | VDD | Metal1 | 7.4490 | 93.9010 | 1.199986
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
_121_ | VDD | Metal1 | 12.4680 | 49.5160 | 1.199927
_120_ | VDD | Metal1 | 12.4680 | 57.0760 | 1.199883
_119_ | VDD | Metal1 | 12.4680 | 71.4430 | 1.199919
_118_ | VDD | Metal1 | 12.4680 | 79.0030 | 1.199916
_117_ | VDD | Metal1 | 12.4680 | 87.3160 | 1.199617
