Manimohan05/SG13G2_2.4GHz_LC_VCO_FPLL/HFSS Inductor Files/Workflow Development/Inductor_Workflow.drawio (1).png

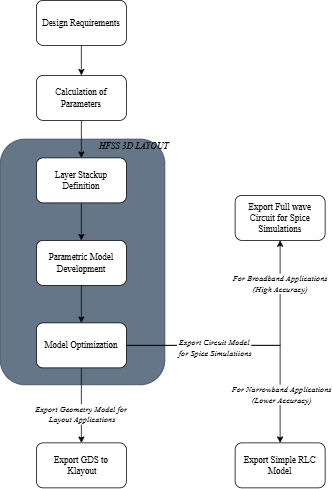
HFSS Inductor Files/Workflow Development/Inductor_Workflow.drawio (1).png
