Manimohan05/SG13G2_2.4GHz_LC_VCO_FPLL/images/PLL_integrated_schematic_and_simulation_waveforms_collage.png

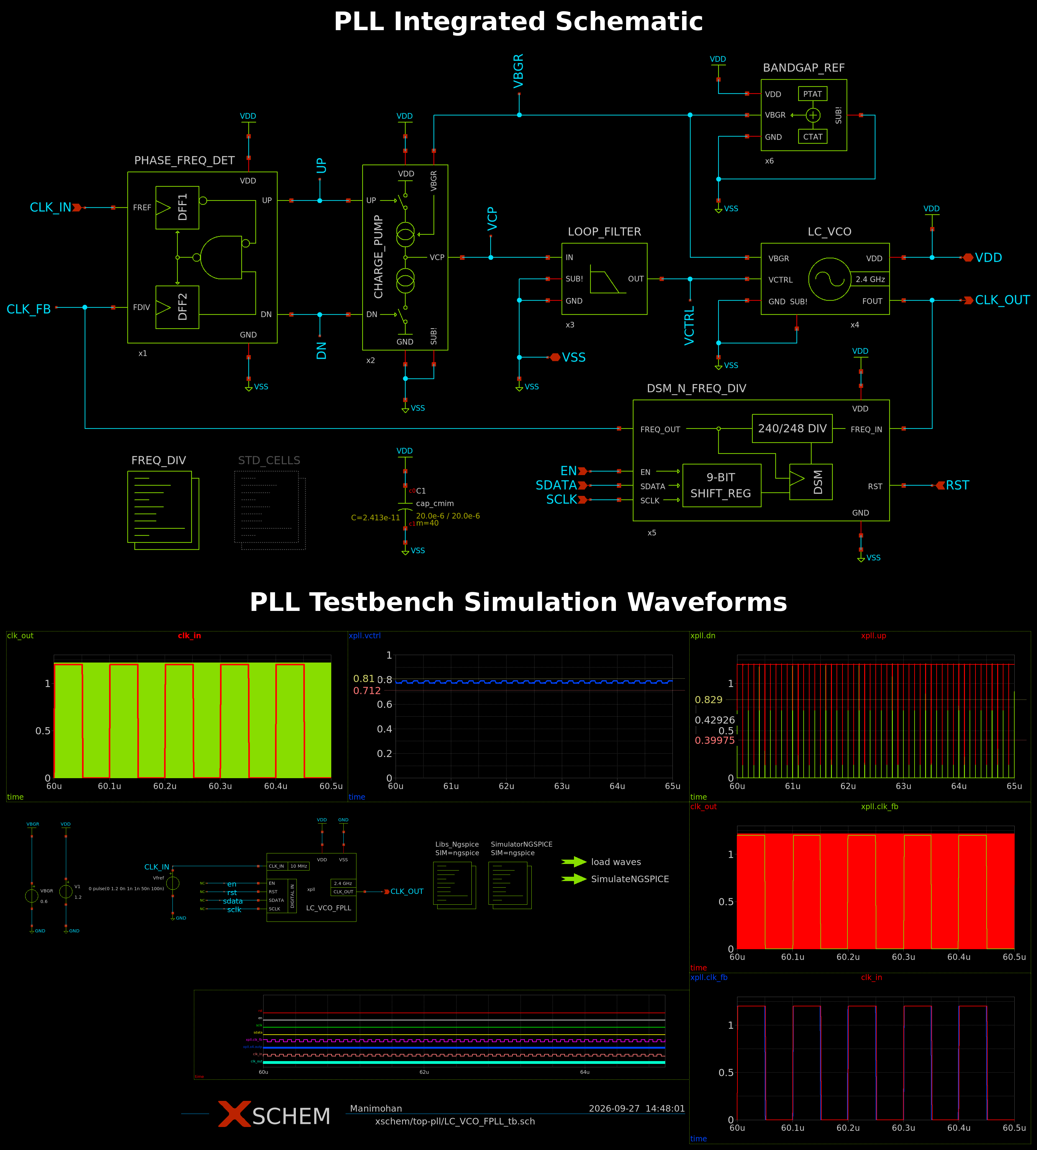
images/PLL_integrated_schematic_and_simulation_waveforms_collage.png
