Manimohan05/SG13G2_2.4GHz_LC_VCO_FPLL/images/PLL_layout.png

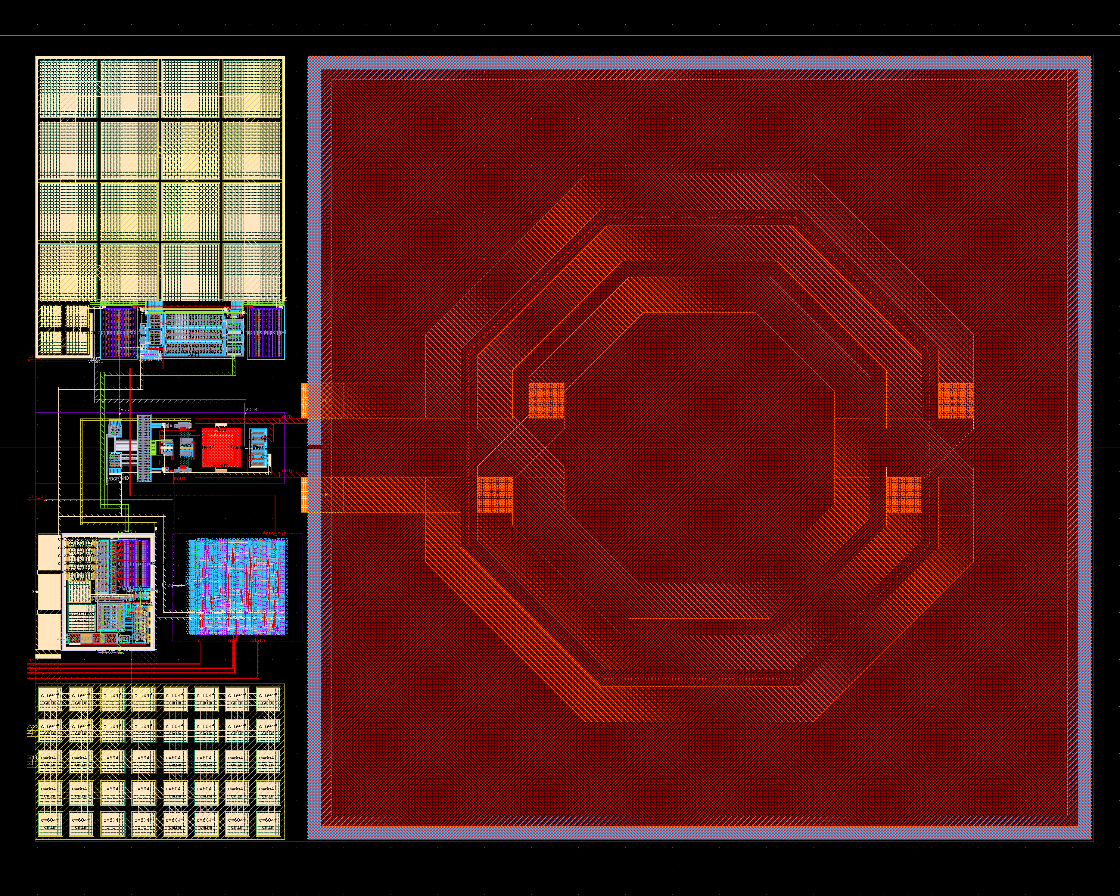
images/PLL_layout.png
