Manimohan05/SG13G2_2.4GHz_LC_VCO_FPLL/images/PLL_layout_2p5D_top_view.png

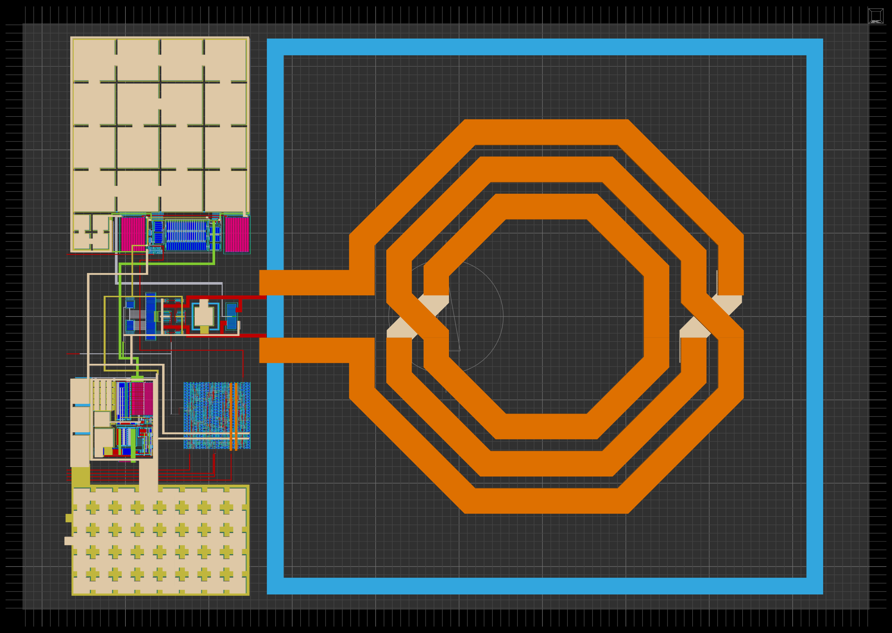
images/PLL_layout_2p5D_top_view.png
