Manimohan05/SG13G2_2.4GHz_LC_VCO_FPLL/images/SMACD_paper_and_PLL_architecture_collage.png

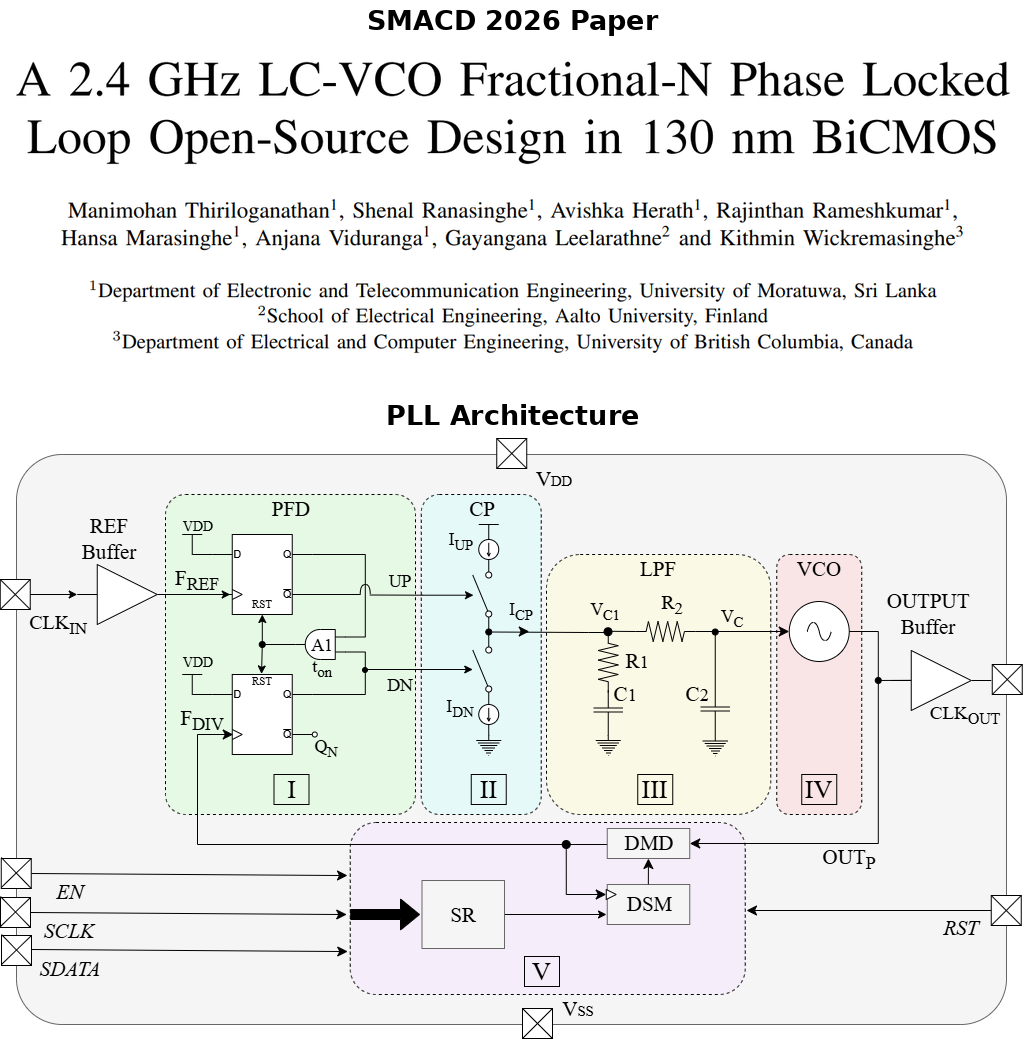
images/SMACD_paper_and_PLL_architecture_collage.png
