Manimohan05/SG13G2_2.4GHz_LC_VCO_FPLL/images/UNICCASS_chip_2p5D_oblique_view.png

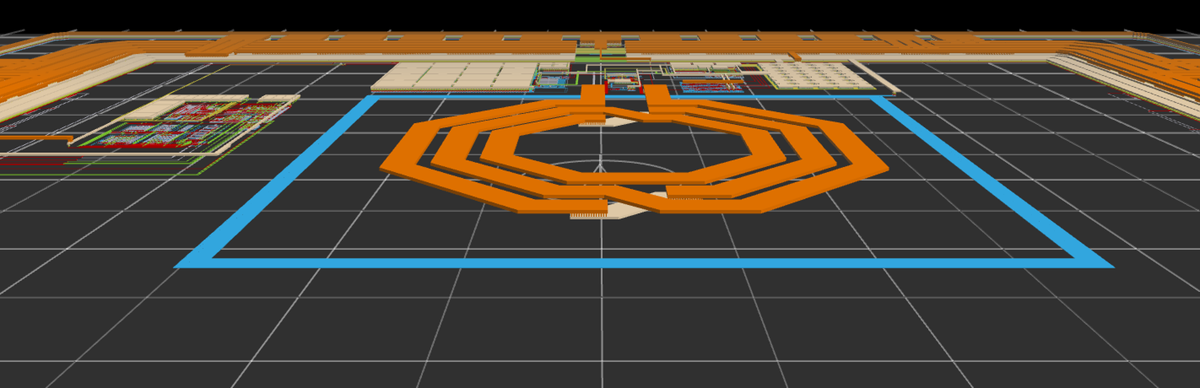
images/UNICCASS_chip_2p5D_oblique_view.png
