Manimohan05/SG13G2_2.4GHz_LC_VCO_FPLL/images/UNICCASS_chip_layout_top_view_and_2p5D_view_collage.png

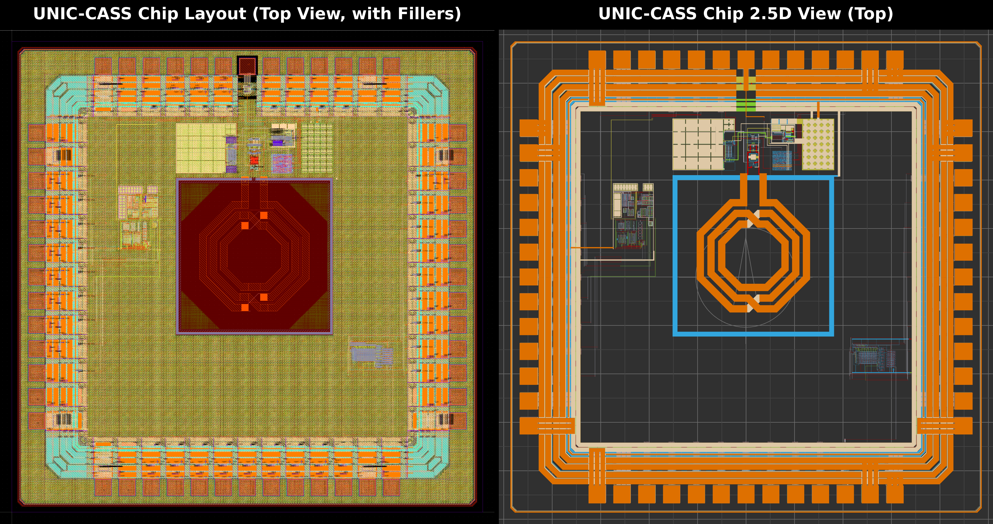
images/UNICCASS_chip_layout_top_view_and_2p5D_view_collage.png
