Manimohan05/SG13G2_2.4GHz_LC_VCO_FPLL/images/UNICCASS_chip_layout_with_fillers.png

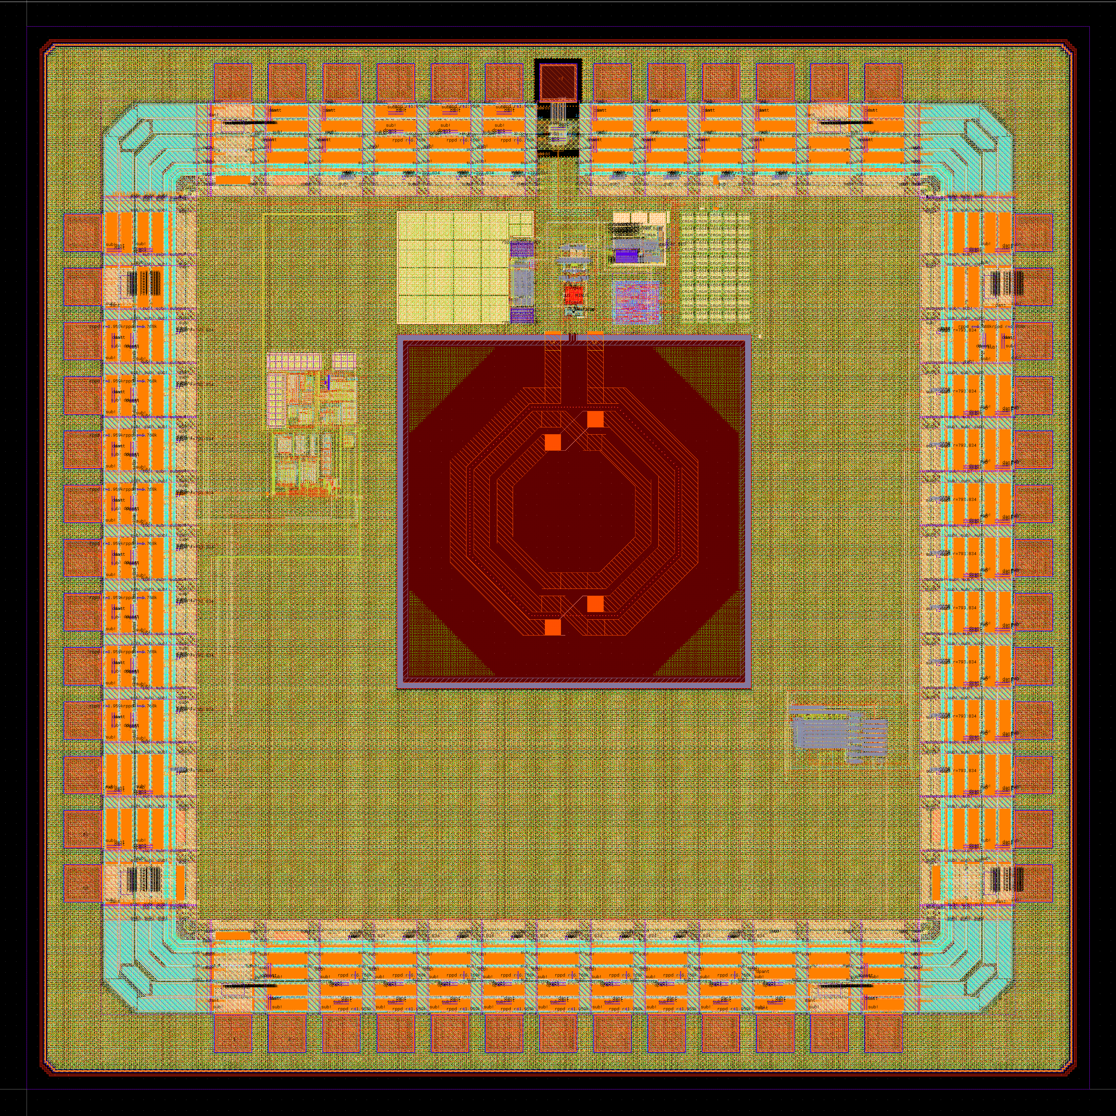
images/UNICCASS_chip_layout_with_fillers.png
