Manimohan05/SG13G2_2.4GHz_LC_VCO_FPLL/model/calculations/ihp-sg13g2_lookup/noisetest_sg13_lv_nmos.png

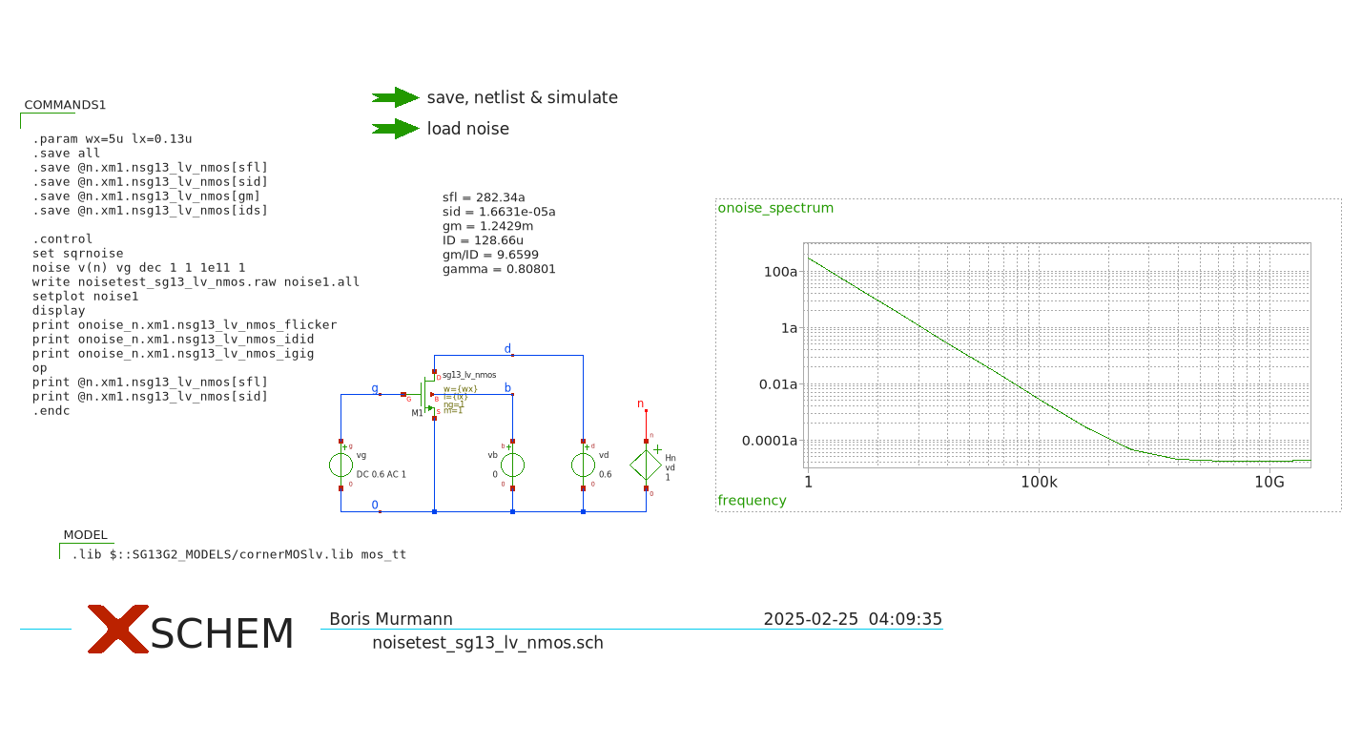
model/calculations/ihp-sg13g2_lookup/noisetest_sg13_lv_nmos.png
