Manimohan05/SG13G2_2.4GHz_LC_VCO_FPLL/xschem/dsm/src/runs/RUN_2026-03-04_15-08-00/59-klayout-render/dsm_and_freq_divider.png

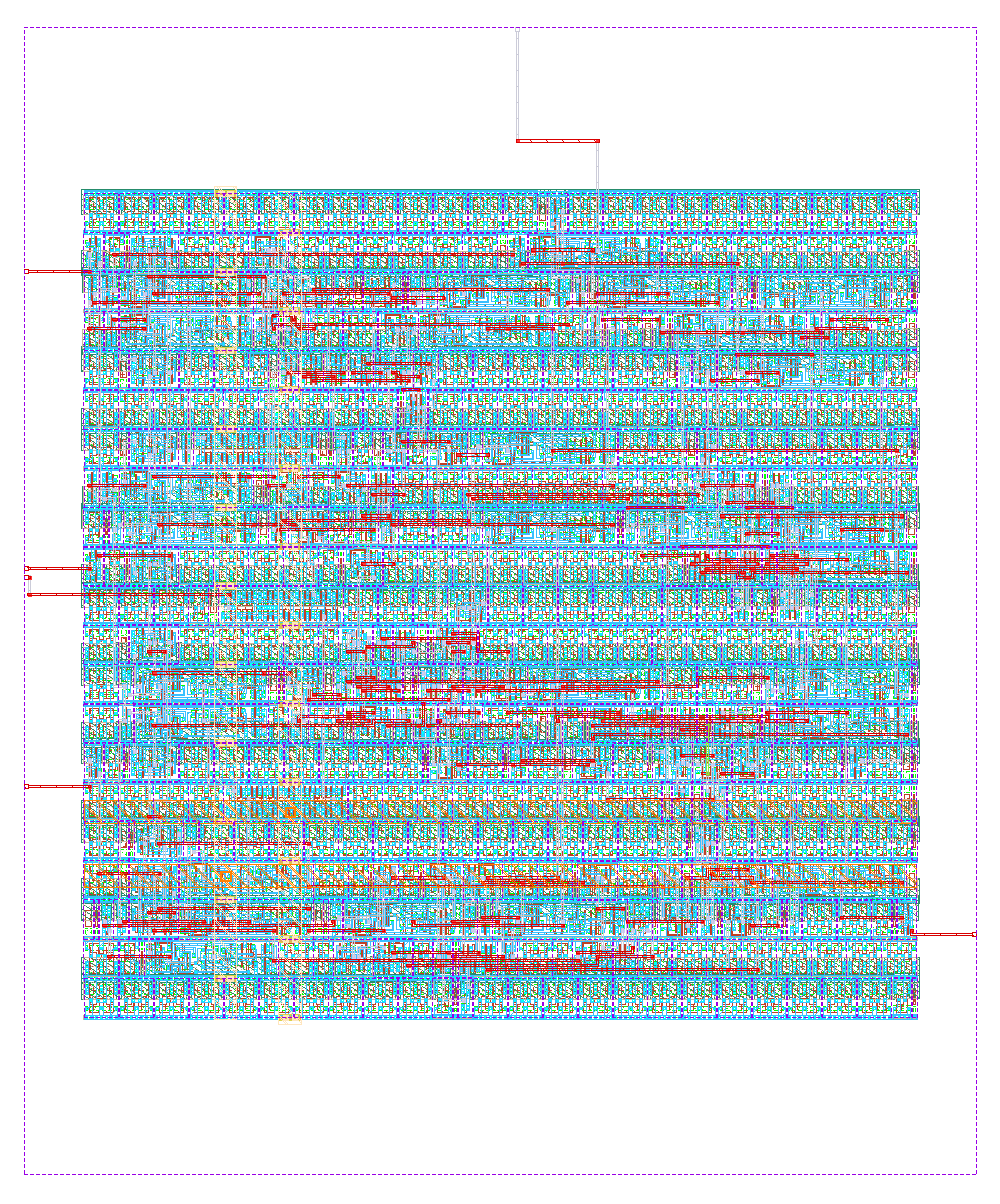
xschem/dsm/src/runs/RUN_2026-03-04_15-08-00/59-klayout-render/dsm_and_freq_divider.png
