Manimohan05/SG13G2_2.4GHz_LC_VCO_FPLL/xschem/freq_divider/techmap-stats.png

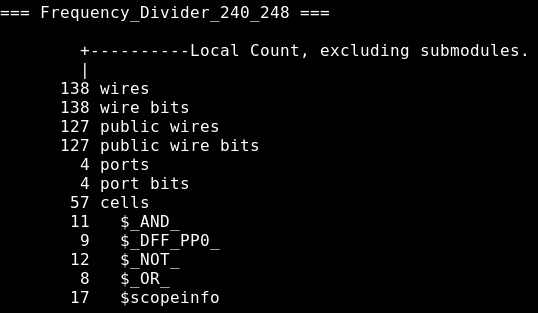
xschem/freq_divider/techmap-stats.png
