Manimohan05/SG13G2_2.4GHz_LC_VCO_FPLL/xschem/lc-vco/images/VCO_swing_0.6.png

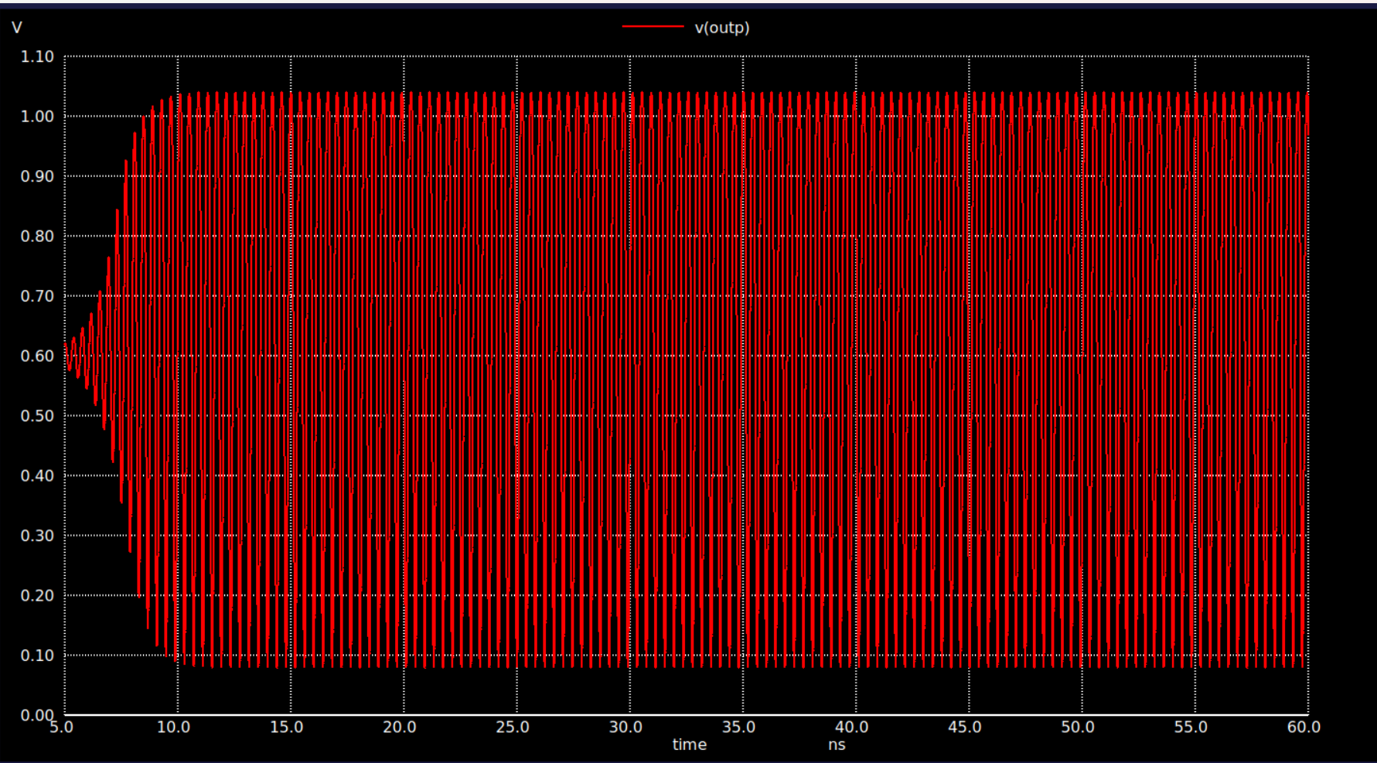
xschem/lc-vco/images/VCO_swing_0.6.png
