Manimohan05/SG13G2_2.4GHz_LC_VCO_FPLL/xschem/lc-vco/images/VCO_tb.png

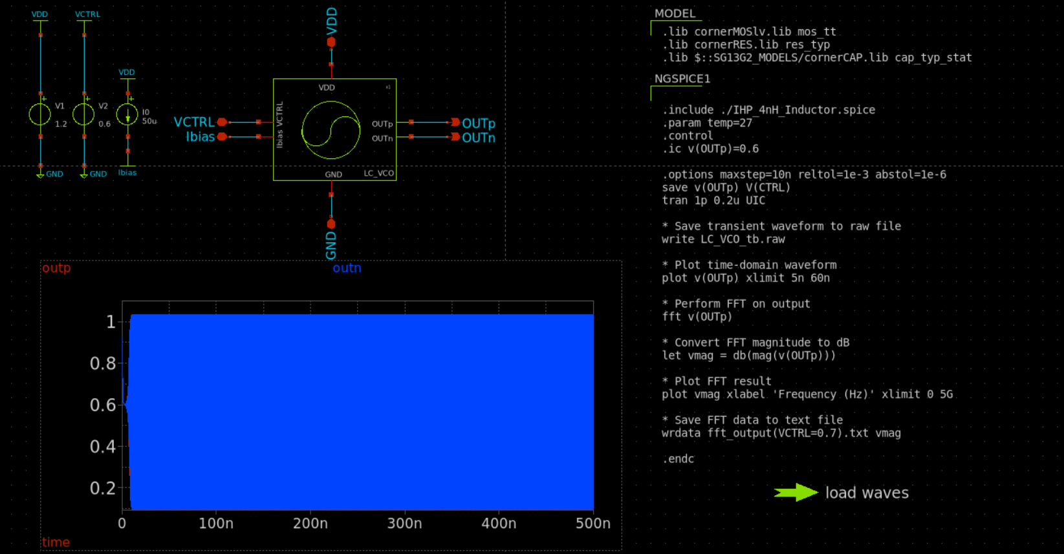
xschem/lc-vco/images/VCO_tb.png
