Manimohan05/SG13G2_2.4GHz_LC_VCO_FPLL/xschem/lc-vco/images/VCO_v2_VCTRL_vs_Frequency.png

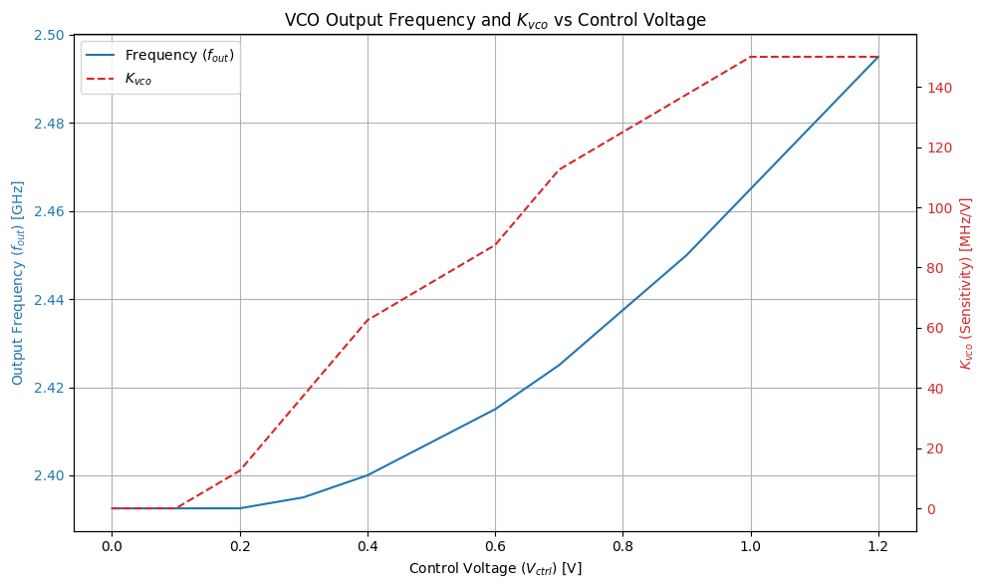
xschem/lc-vco/images/VCO_v2_VCTRL_vs_Frequency.png
