Manimohan05/SG13G2_2.4GHz_LC_VCO_FPLL/xschem/lc-vco/inductor/images/plot_tb_trans.png

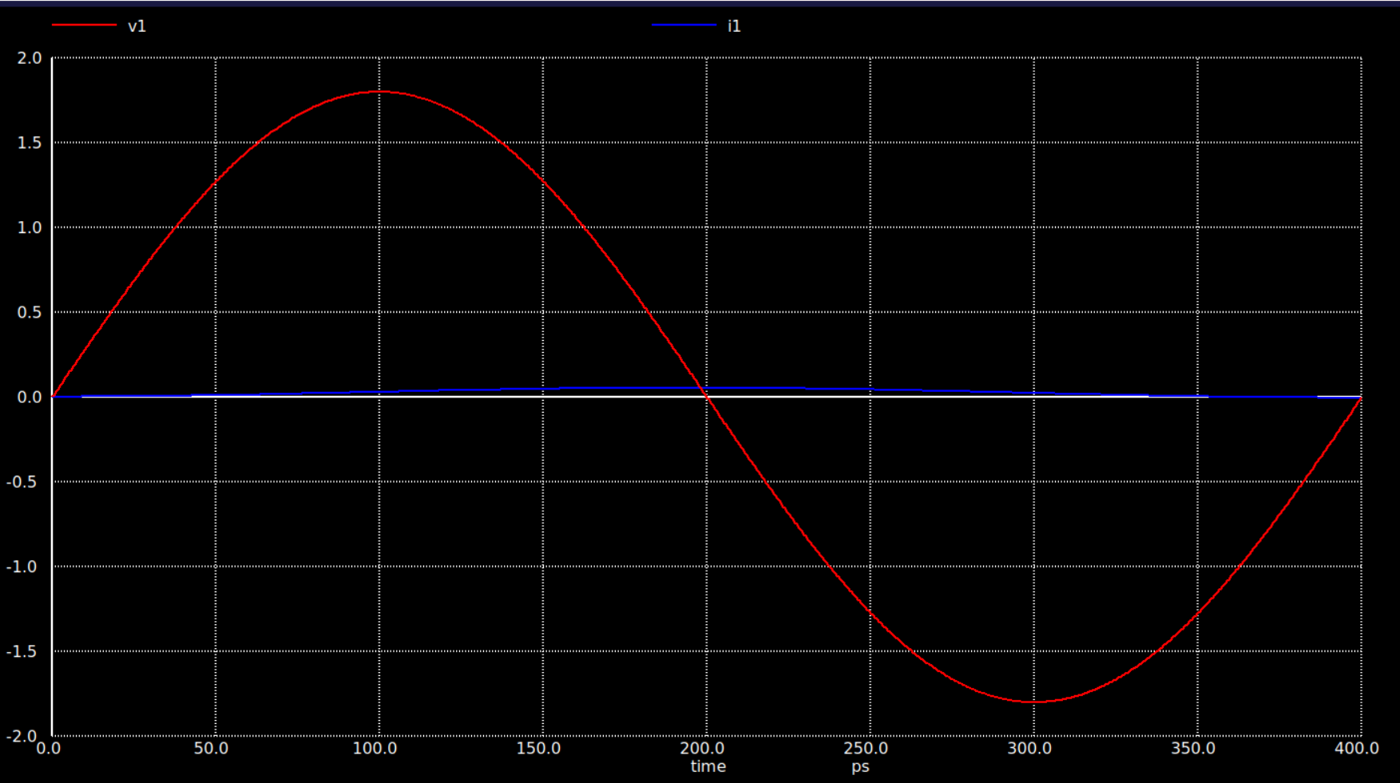
xschem/lc-vco/inductor/images/plot_tb_trans.png
