Manimohan05/SG13G2_2.4GHz_LC_VCO_FPLL/xschem/lc-vco/inductor/images/tb_ind.png

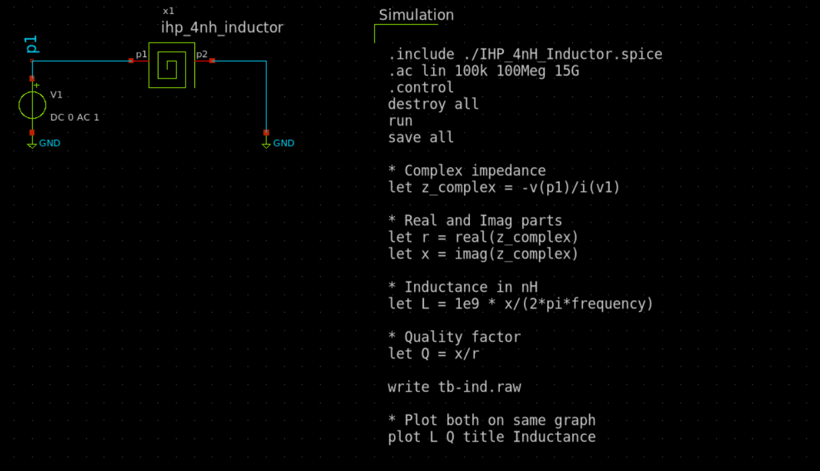
xschem/lc-vco/inductor/images/tb_ind.png
