Manimohan05/SG13G2_2.4GHz_LC_VCO_FPLL/xschem/top-pll/plots/phase_noise.png

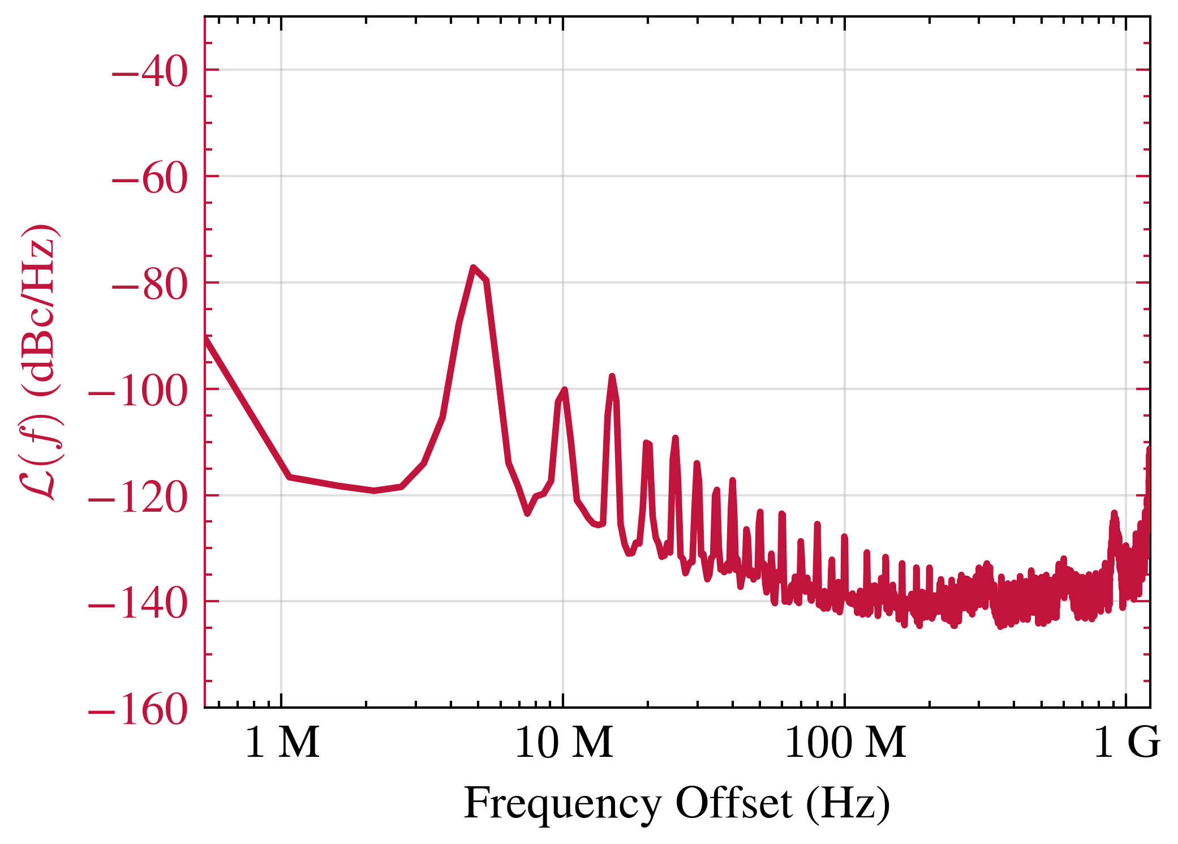
xschem/top-pll/plots/phase_noise.png
