Manimohan05/SG13G2_2.4GHz_LC_VCO_FPLL/xschem/top-pll/plots/plot_vco.png

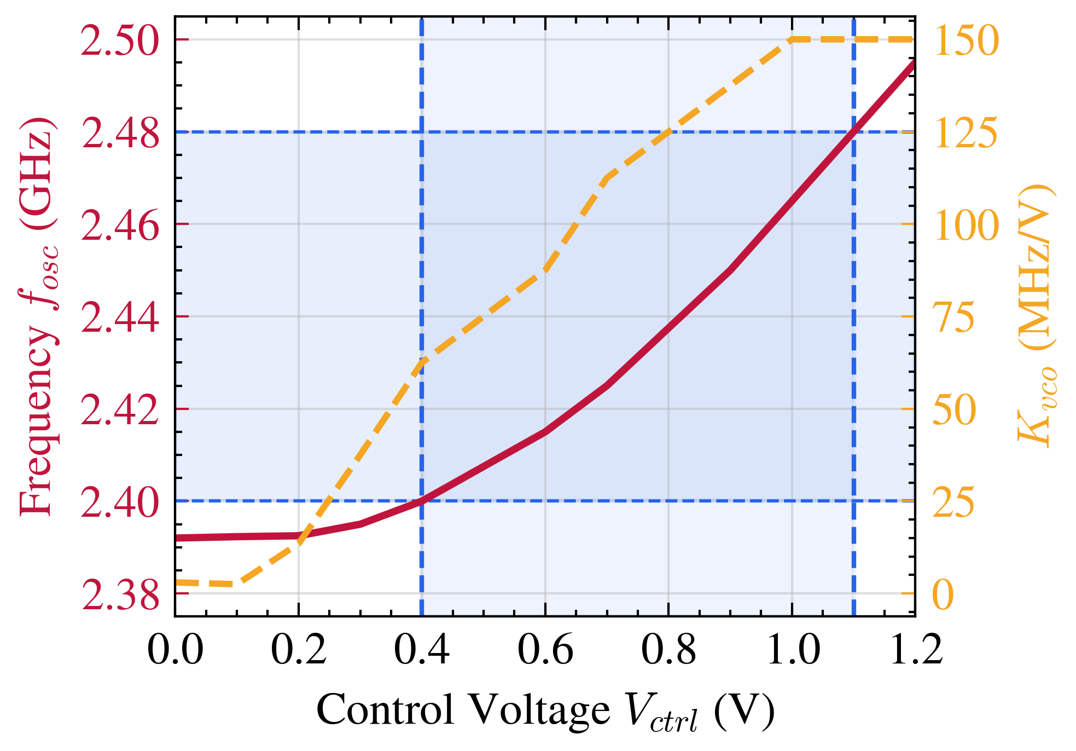
xschem/top-pll/plots/plot_vco.png
