Manimohan05/SG13G2_2.4GHz_LC_VCO_FPLL/xschem/top-pll/plots/prelayout/phase_noise_with_tone_2.png

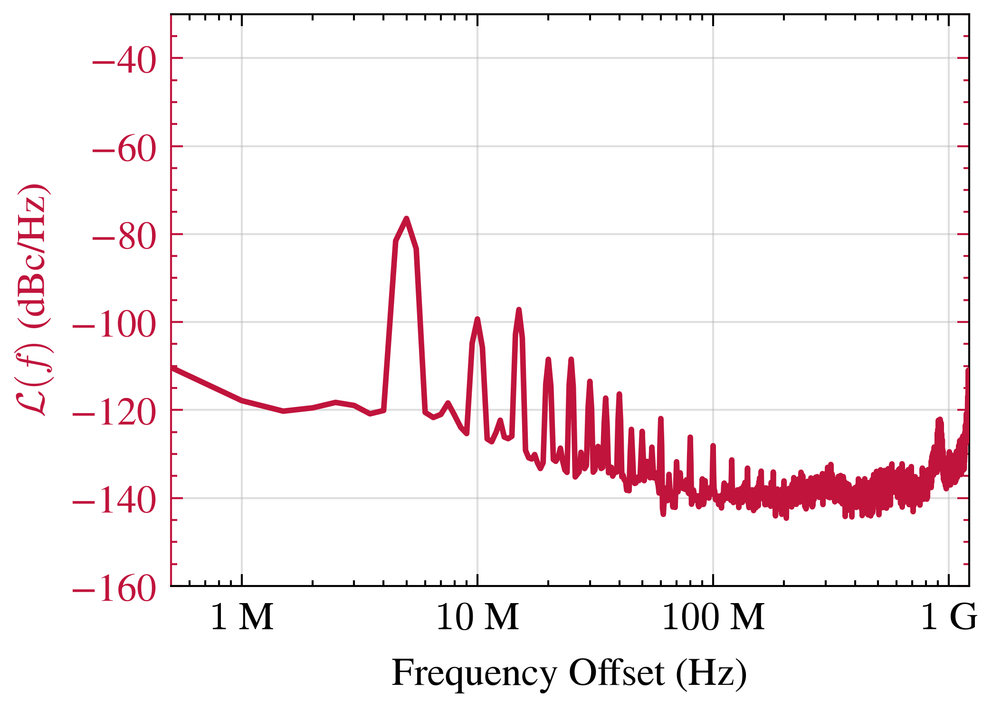
xschem/top-pll/plots/prelayout/phase_noise_with_tone_2.png
