Manimohan05/SG13G2_2.4GHz_LC_VCO_FPLL/xschem/top-pll/plots/prelayout/pll_lock_error.png

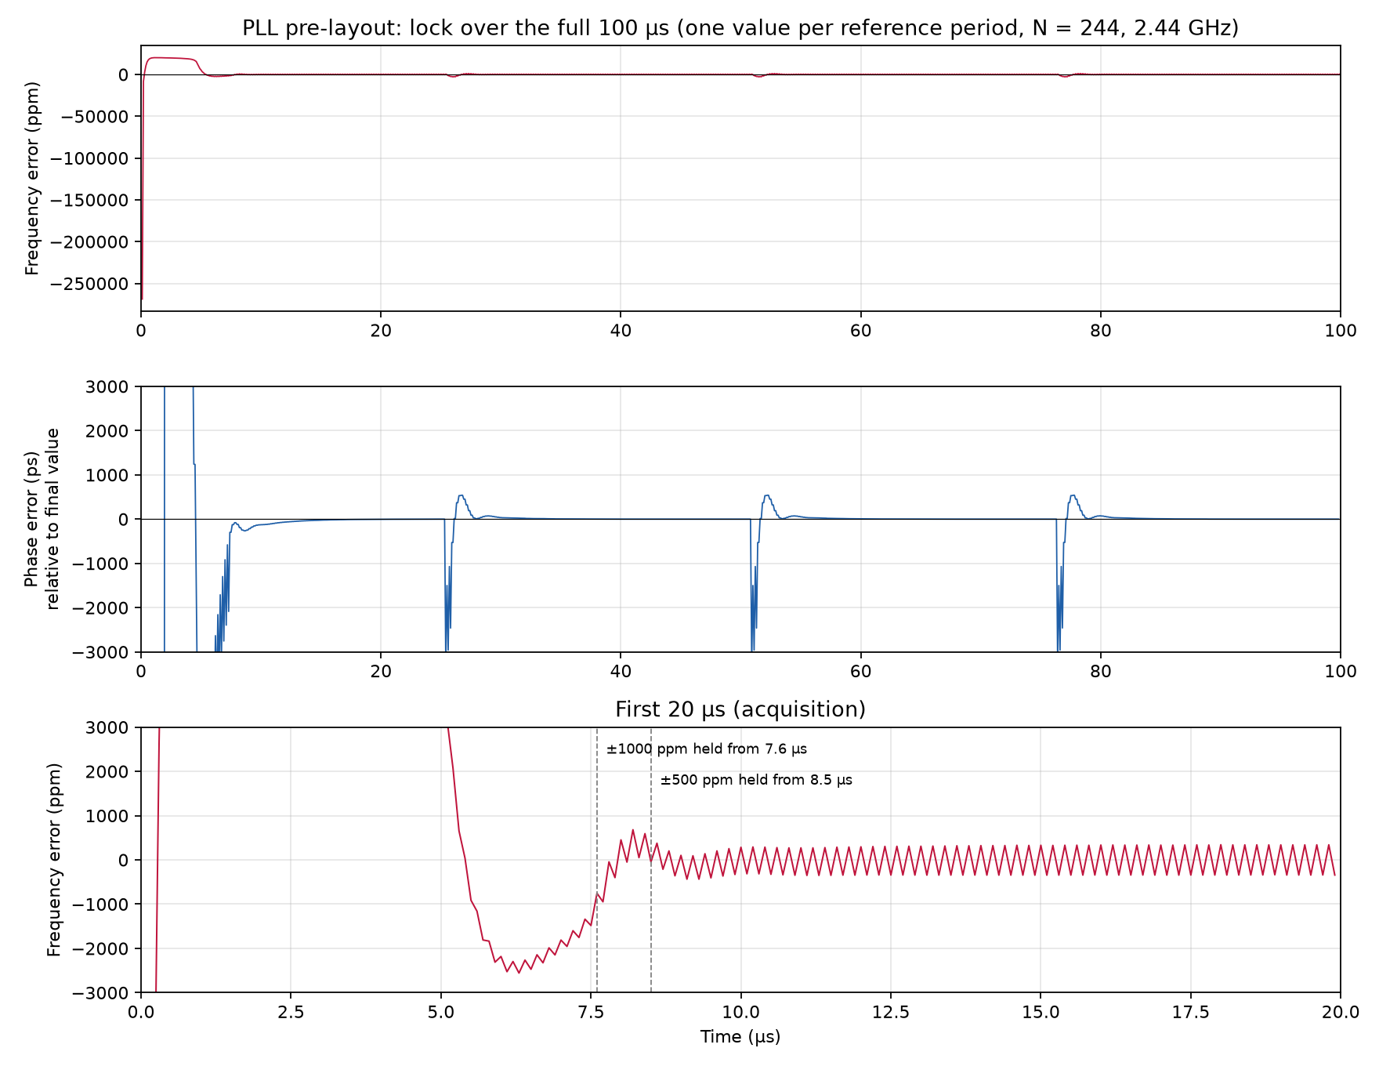
xschem/top-pll/plots/prelayout/pll_lock_error.png
