Manimohan05/SG13G2_2.4GHz_LC_VCO_FPLL/xschem/top-pll/plots/prelayout/plot_paper_pll_slide_v3.png

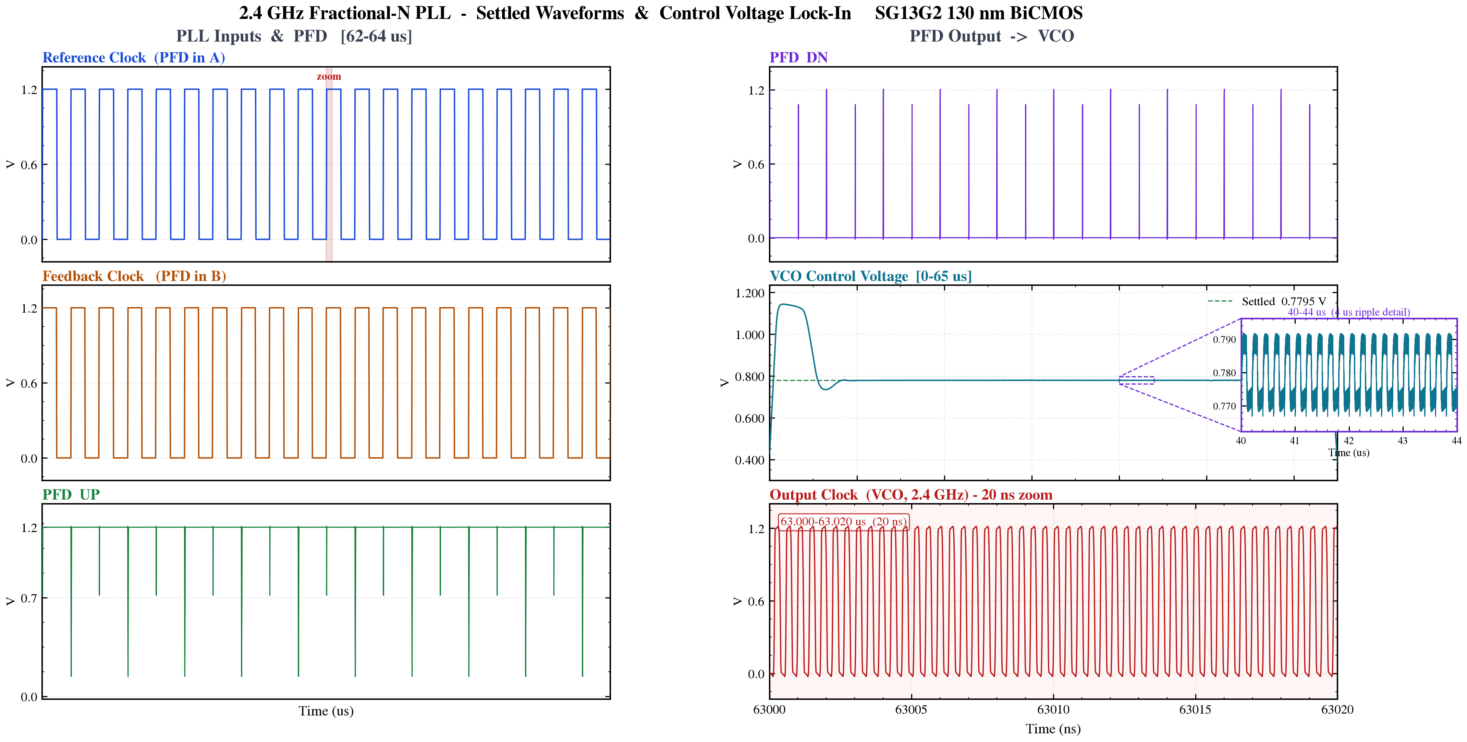
xschem/top-pll/plots/prelayout/plot_paper_pll_slide_v3.png
