Manimohan05/SG13G2_2.4GHz_LC_VCO_FPLL/xschem/top-pll/plots/prelayout/reference_spur_fixed_2.png

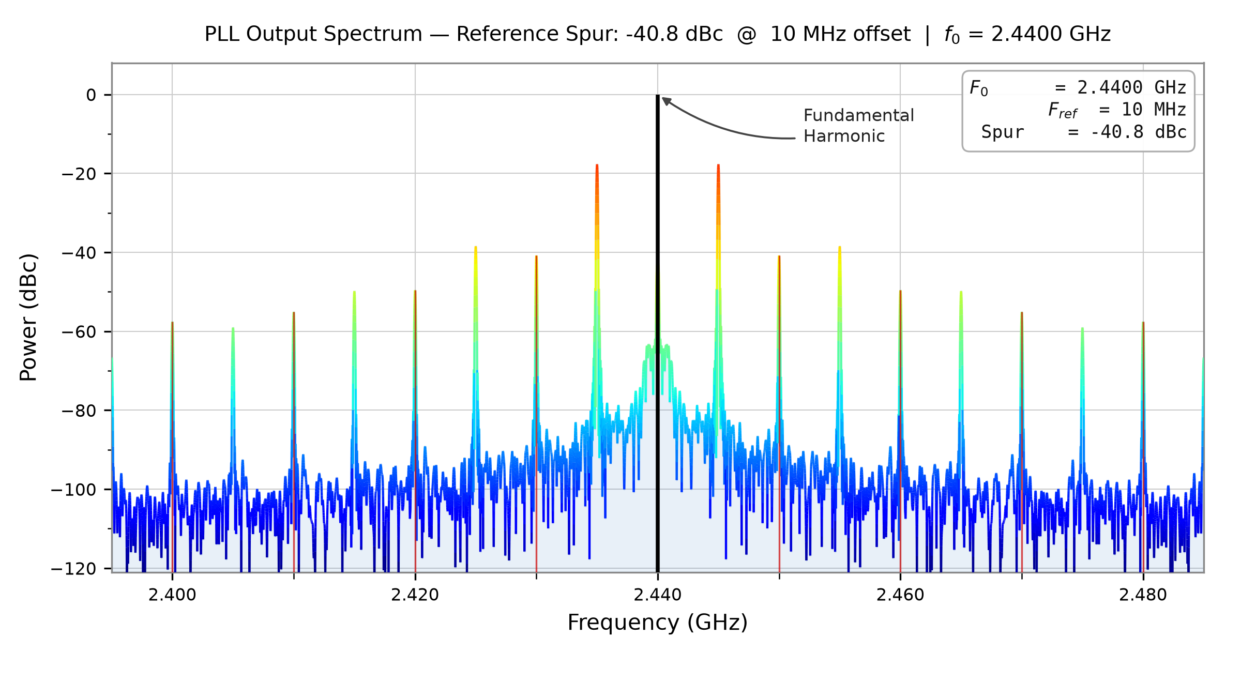
xschem/top-pll/plots/prelayout/reference_spur_fixed_2.png
