Manimohan05/SG13G2_2.4GHz_LC_VCO_FPLL/xschem/top-pll/plots/regenerated/vco_phase_noise_from_transient.png

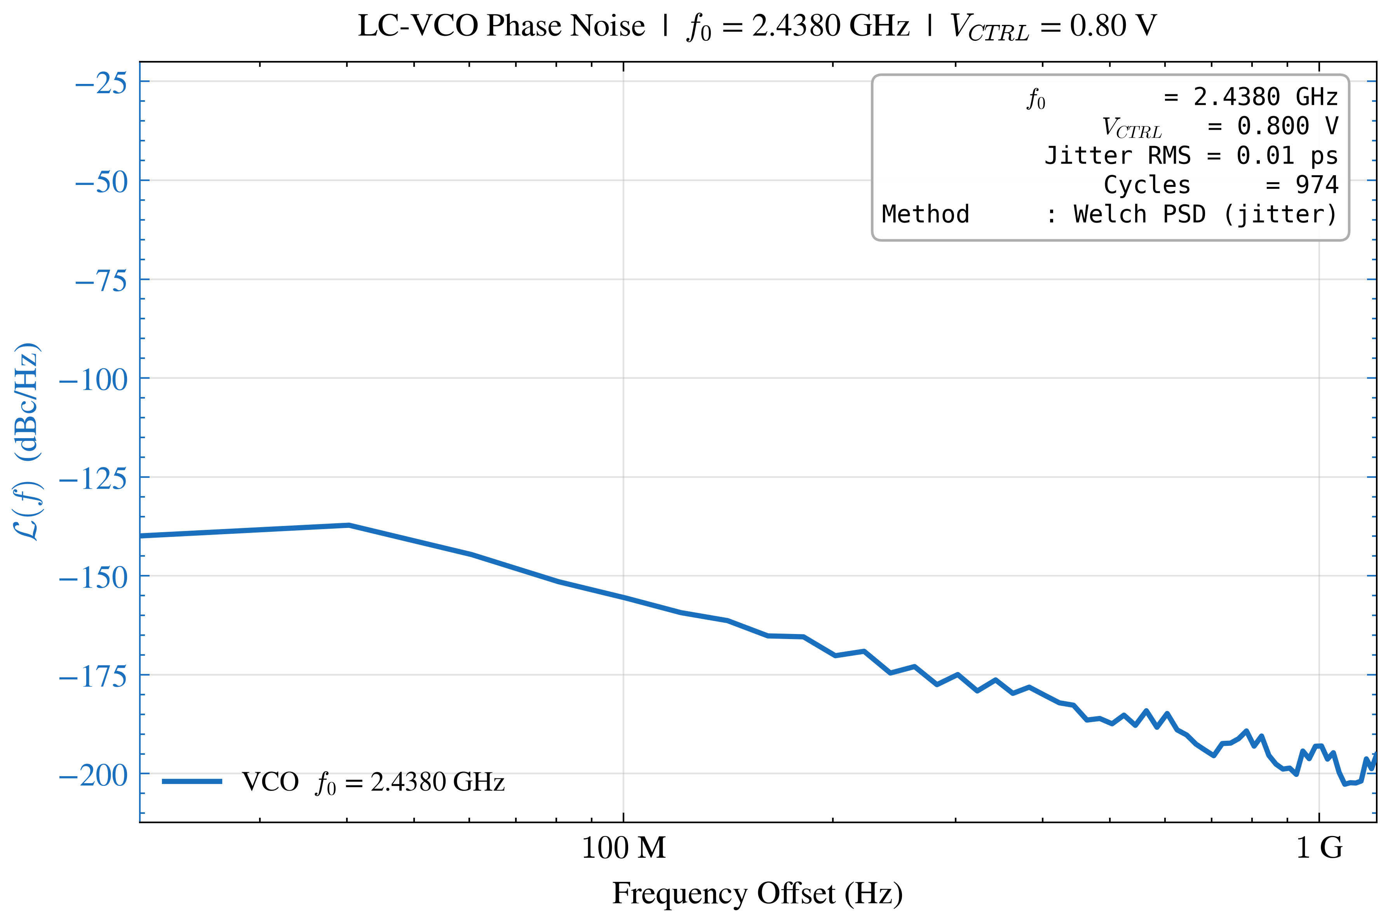
xschem/top-pll/plots/regenerated/vco_phase_noise_from_transient.png
