Manimohan05/SG13G2_2.4GHz_LC_VCO_FPLL/xschem/top-pll/simulations/stimuli_test.txt

unit n
voltage 1.8
slope 5
format hspice_simple

signal sdata
signal sclk
signal rst
signal en

beginfile stimuli_test.cir

* --- Initialization ---
set rst 1
set en 0
set sclk 0
set sdata 0
s 50
set rst 0
s 20

* --- Sending word -128 ---
set en 1
s 3
set sdata 1
s 1
set sclk 1
s 5
set sclk 0
s 5
set sdata 1
s 1
set sclk 1
s 5
set sclk 0
s 5
set sdata 0
s 1
set sclk 1
s 5
set sclk 0
s 5
set sdata 0
s 1
set sclk 1
s 5
set sclk 0
s 5
set sdata 0
s 1
set sclk 1
s 5
set sclk 0
s 5
set sdata 0
s 1
set sclk 1
s 5
set sclk 0
s 5
set sdata 0
s 1
set sclk 1
s 5
set sclk 0
s 5
set sdata 0
s 1
set sclk 1
s 5
set sclk 0
s 5
set sdata 0
s 1
set sclk 1
s 5
set sclk 0
s 5
set en 0
set sdata 0
s 10000

* --- Sending word -112 ---
set en 1
s 3
set sdata 1
s 1
set sclk 1
s 5
set sclk 0
s 5
set sdata 1
s 1
set sclk 1
s 5
set sclk 0
s 5
set sdata 0
s 1
set sclk 1
s 5
set sclk 0
s 5
set sdata 0
s 1
set sclk 1
s 5
set sclk 0
s 5
set sdata 1
s 1
set sclk 1
s 5
set sclk 0
s 5
set sdata 0
s 1
set sclk 1
s 5
set sclk 0
s 5
set sdata 0
s 1
set sclk 1
s 5
set sclk 0
s 5
set sdata 0
s 1
set sclk 1
s 5
set sclk 0
s 5
set sdata 0
s 1
set sclk 1
s 5
set sclk 0
s 5
set en 0
set sdata 0
s 10000

* --- Sending word -96 ---
set en 1
s 3
set sdata 1
s 1
set sclk 1
s 5
set sclk 0
s 5
set sdata 1
s 1
set sclk 1
s 5
set sclk 0
s 5
set sdata 0
s 1
set sclk 1
s 5
set sclk 0
s 5
set sdata 1
s 1
set sclk 1
s 5
set sclk 0
s 5
set sdata 0
s 1
set sclk 1
s 5
set sclk 0
s 5
set sdata 0
s 1
set sclk 1
s 5
set sclk 0
s 5
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
set sclk 1
s 5
set sclk 0
s 5
set sdata 1
s 1
set sclk 1
s 5
set sclk 0
s 5
set sdata 0
s 1
set sclk 1
s 5
set sclk 0
s 5
set sdata 0
s 1
set sclk 1
s 5
set sclk 0
s 5
set sdata 0
s 1
set sclk 1
s 5
set sclk 0
s 5
set sdata 0
s 1
set sclk 1
s 5
set sclk 0
s 5
set en 0
set sdata 0
s 10000

endfile
