Manimohan05/SG13G2_2.4GHz_LC_VCO_FPLL/xschem/top-pll/plots/vco_tuning_post.pdf

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
Frequency fosc (GHz)

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
Kvco (MHz/V)
