Manimohan05/SG13G2_2.4GHz_LC_VCO_FPLL/xschem/lc-vco/simulations/vco_tuning.csv

vctrl_V freq_Hz
0
0.1
0.2
0.3
0.4
0.5
0.6
0.7
0.8
0.9
1
1.1
1.2
