Manimohan05/SG13G2_2.4GHz_LC_VCO_FPLL/HFSS Inductor Files/Results/Final_Inductor/All_params_5_reduced.csv

F [GHz] | Qdiff [] | Ldiff []
0 | 0
0.05 | 0.808221302339503 | 3.86967895368629
0.1 | 1.57126213712022 | 3.83847632553214
0.15 | 2.28728026944524 | 3.82263144374075
0.2 | 2.94819767089407 | 3.80595244715383
0.25 | 3.55786930951855 | 3.78995089976052
0.3 | 4.1214264002178 | 3.77511539695406
0.35 | 4.64391540660947 | 3.76148328766977
0.4 | 5.1302410082315 | 3.74896260242924
0.45 | 5.58518969996549 | 3.73745681001403
0.5 | 6.01333250661989 | 3.72689622021975
0.55 | 6.41888039885662 | 3.71723630663733
0.6 | 6.80556366856627 | 3.70844832091741
0.65 | 7.17656216390773 | 3.70051071687813
0.7 | 7.53448497099721 | 3.69340331672576
0.75 | 7.88138736628356 | 3.68710400590068
0.8 | 8.21881171445423 | 3.68158725489683
0.85 | 8.54784152327796 | 3.67682380954102
0.9 | 8.86916108342728 | 3.67278105696072
0.95 | 9.18311585465781 | 3.66942373309137
1 | 9.48977073858991 | 3.66671475872088
1.05 | 9.79288405002196 | 3.66436178585091
1.1 | 10.0903723200975 | 3.66257996339309
1.15 | 10.3823620402679 | 3.6613288471994
1.2 | 10.6689530975075 | 3.66057259683529
1.25 | 10.9502266814979 | 3.66027957630608
1.3 | 11.2262505339262 | 3.66042193217245
1.35 | 11.4970823934199 | 3.66097517960129
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
