Manimohan05/SG13G2_2.4GHz_LC_VCO_FPLL/HFSS Inductor Files/Results/Results for the 2port inductor/Seperation_plots/Seperation_variations.csv

F [GHz] | Ldiff [] - $S='8um' | Ldiff [] - $S='11um' | Ldiff [] - $S='12um' | Ldiff [] - $S='14um' | Ldiff [] - $S='16um' | Qdiff [] - $S='8um' | Qdiff [] - $S='11um' | Qdiff [] - $S='12um' | Qdiff [] - $S='14um' | Qdiff [] - $S='16um'
0 |  |  |  |  |  |  |  |  | 0 | -0
0.05 | 4.91231607098891 | 4.72739334517746 | 4.66135685207335 | 4.51413172026879 | 4.39644912052799 | 0.964127437973695 | 0.932289460703617 | 0.926600735638616 | 0.904891540396393 | 0.884607899084208
0.1 | 4.87809197121213 | 4.69269461395877 | 4.62635532423246 | 4.48014007874908 | 4.36103531316006 | 1.86708595256668 | 1.8068124277388 | 1.7955628635851 | 1.75480917861428 | 1.71565441234539
0.15 | 4.86223492571802 | 4.67486232517467 | 4.60820764149364 | 4.46220521210442 | 4.34238948798644 | 2.70098845753315 | 2.61655871921546 | 2.60033883434424 | 2.54369243479228 | 2.4893110969215
0.2 | 4.84252798907499 | 4.65455131019502 | 4.58785025885214 | 4.44261252311694 | 4.32281900263063 | 3.44798780111242 | 3.34914310816545 | 3.32939355919766 | 3.26123164077802 | 3.19746085282269
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
