Manimohan05/SG13G2_2.4GHz_LC_VCO_FPLL/HFSS Inductor Files/Results/Results for the 2port inductor/radius_plots/Radius_180um_220um.csv

F [GHz] | Ldiff [] - $R_out='180um' | Ldiff [] - $R_out='190um' | Ldiff [] - $R_out='200um' | Ldiff [] - $R_out='210um' | Ldiff [] - $R_out='213um' | Ldiff [] - $R_out='220um' | Qdiff [] - $R_out='180um' | Qdiff [] - $R_out='190um' | Qdiff [] - $R_out='200um' | Qdiff [] - $R_out='210um' | Qdiff [] - $R_out='213um' | Qdiff [] - $R_out='220um'
0 |  |  |  |  |  |  |  |  | 0 | 0 | 0 | 0
0.05 | 2.94635288490682 | 3.29213367682791 | 3.65392599970224 | 4.01396042667912 | 4.13198709288 | 4.38835970213801 | 0.7537081833239 | 0.789028896049678 | 0.839202539896148 | 0.887720089932356 | 0.893176035754212 | 0.909320935678682
0.1 | 2.91628753464463 | 3.26140964524363 | 3.62055198966662 | 3.97916060531061 | 4.09528362653112 | 4.35000855692005 | 1.45732809343296 | 1.52775478382392 | 1.62445253523559 | 1.71718089890242 | 1.72670346446435 | 1.75897878131398
0.15 | 2.90108923579563 | 3.24596107309341 | 3.60423207576276 | 3.96158876710283 | 4.07668906200183 | 4.33111789566121 | 2.10975736657196 | 2.21382815451999 | 2.35317982104596 | 2.48420502967266 | 2.49697681857184 | 2.54575157811841
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
