Manimohan05/SG13G2_2.4GHz_LC_VCO_FPLL/HFSS Inductor Files/Results/Results for the 2port inductor/width_plots/Width_variations.csv

F [GHz] | Ldiff [] - $W='15um' | Ldiff [] - $W='17.5um' | Ldiff [] - $W='20um' | Ldiff [] - $W='22.5um' | Ldiff [] - $W='25um' | Ldiff [] - $W='27.5um' | Ldiff [] - $W='30um' | Qdiff [] - $W='15um' | Qdiff [] - $W='17.5um' | Qdiff [] - $W='20um' | Qdiff [] - $W='22.5um' | Qdiff [] - $W='25um' | Qdiff [] - $W='27.5um' | Qdiff [] - $W='30um'
0 |  |  |  |  |  |  |  | 0 |  |  | 0
0.05 | 6.36075840815174 | 6.0886246468358 | 5.79114104566242 | 5.47099616186935 | 5.21381209066479 | 4.97195963399641 | 4.72739334517746 | 0.618886184666598 | 0.691092094918561 | 0.751190674646604 | 0.802083901880361 | 0.853245788943377 | 0.898536329027343 | 0.932289460703617
0.1 | 6.34555122943527 | 6.06989227195901 | 5.76870261060837 | 5.44590659514406 | 5.18475883110209 | 4.94055259050033 | 4.69269461395877 | 1.22762716554467 | 1.36679748840947 | 1.48037999264114 | 1.57510268087839 | 1.66830486899662 | 1.74962946434537 | 1.8068124277388
0.15 | 6.33973559361164 | 6.06188255334363 | 5.75817215144486 | 5.43424400990087 | 5.17058592296811 | 4.92468281189646 | 4.67486232517467 | 1.82530854893805 | 2.02539801611507 | 2.18483556142578 | 2.31543692493508 | 2.44072809370414 | 2.54705833433821 | 2.61655871921546
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
