Manimohan05/SG13G2_2.4GHz_LC_VCO_FPLL/HFSS Inductor Files/Results/Results for the 2port inductor/Seperation_plots/dual_axis_L_Q_vs_frequency.png

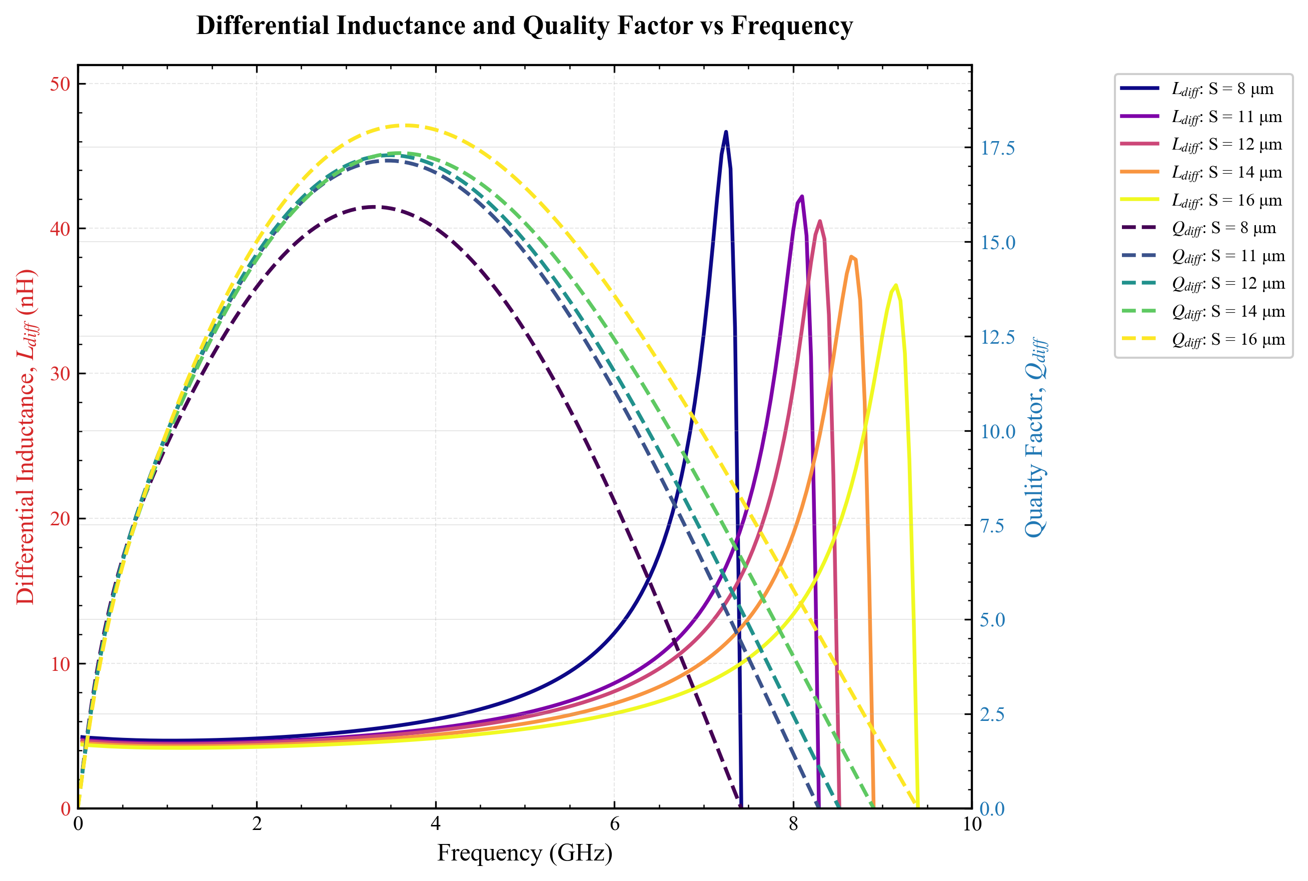
HFSS Inductor Files/Results/Results for the 2port inductor/Seperation_plots/dual_axis_L_Q_vs_frequency.png
