Manimohan05/SG13G2_2.4GHz_LC_VCO_FPLL/images/PLL_testbench_waveforms.png

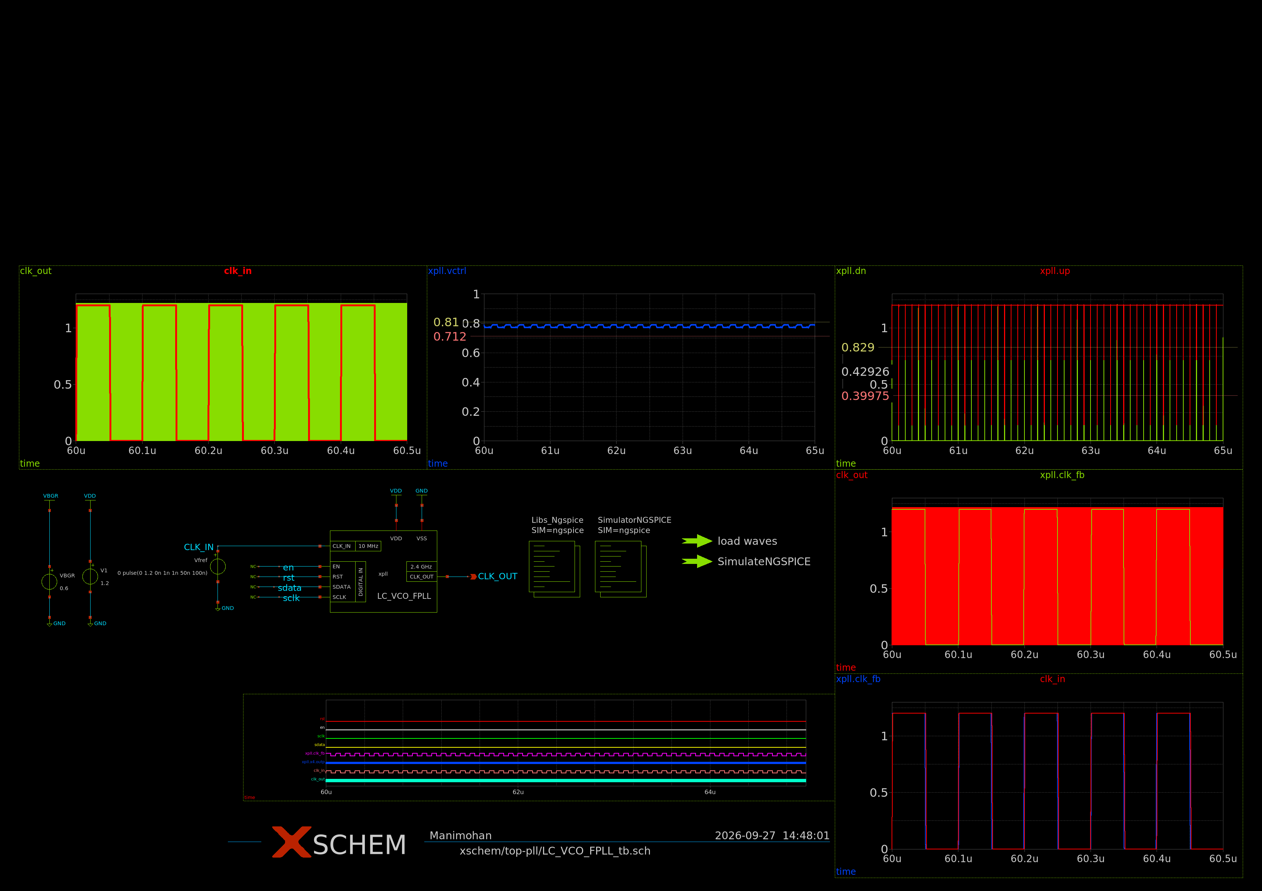
images/PLL_testbench_waveforms.png
