Manimohan05/SG13G2_2.4GHz_LC_VCO_FPLL/xschem/top-pll/plots/prelayout/plot_paper_62_64us.pdf

0.6

1.2

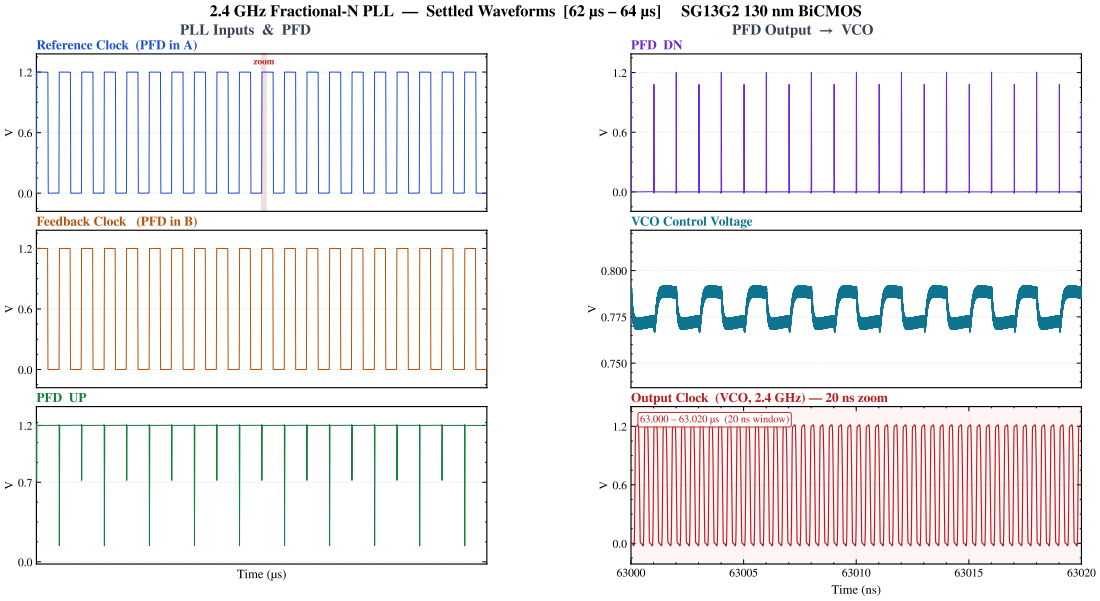
[picture p92: page 1]
zoom; PFD DN; Time (µs); PFD UP; Time (ns); PLL Inputs & PFD; PFD Output → VCO; 2.4 GHz Fractional-N PLL — Settled Waveforms [62 µs – 64 µs]; SG13G2 130 nm BiCMOS

Reference Clock (PFD in A)

Feedback Clock (PFD in B)

VCO Control Voltage

Output Clock (VCO, 2.4 GHz) — 20 ns zoom
63.000 – 63.020 µs (20 ns window)
