Manimohan05/SG13G2_2.4GHz_LC_VCO_FPLL/xschem/top-pll/plots/prelayout/plot_paper_pll_slide.pdf

0.6

1.2

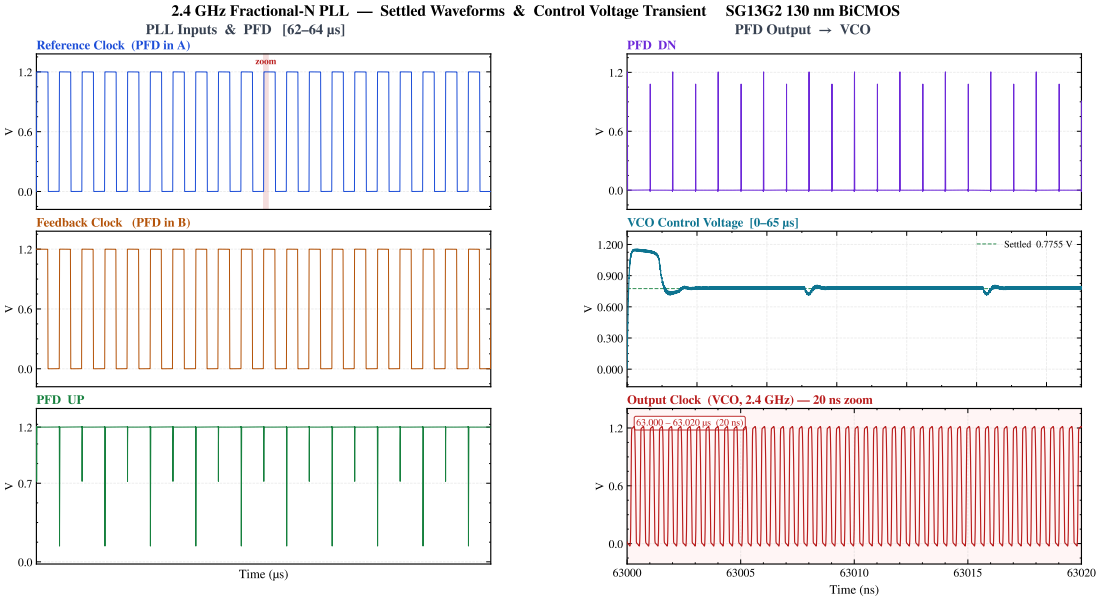
[picture p93: page 1]
zoom; PFD DN; VCO Control Voltage [0–65 µs]; Settled 0.7755 V; Time (µs); PFD UP; Time (ns); PLL Inputs & PFD [62–64 µs]; PFD Output → VCO; 2.4 GHz Fractional-N PLL — Settled Waveforms & Control Voltage Transient; SG13G2 130 nm BiCMOS

Reference Clock (PFD in A)

Feedback Clock (PFD in B)

Output Clock (VCO, 2.4 GHz) — 20 ns zoom
