Manimohan05/SG13G2_2.4GHz_LC_VCO_FPLL/xschem/top-pll/plots/prelayout/plot_paper_pll_slide_v3.pdf

0.6

1.2

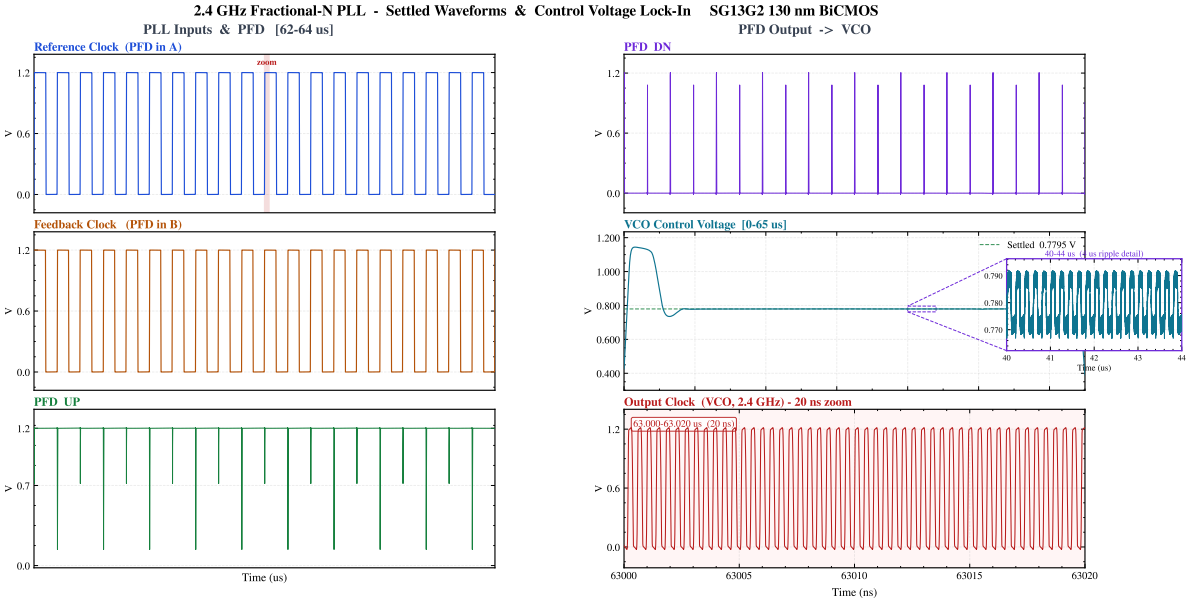
[picture p94: page 1]
zoom; Time (us); PFD UP; PFD DN; Time (ns); PLL Inputs & PFD [62-64 us]; PFD Output -> VCO; 2.4 GHz Fractional-N PLL - Settled Waveforms & Control Voltage Lock-In; SG13G2 130 nm BiCMOS

Reference Clock (PFD in A)

Feedback Clock (PFD in B)

VCO Control Voltage [0-65 us]

Settled 0.7795 V
40-44 us (4 us ripple detail)

Output Clock (VCO, 2.4 GHz) - 20 ns zoom
