Manimohan05/SG13G2_2.4GHz_LC_VCO_FPLL/xschem/top-pll/plots/prelayout/spur_verification_fixed_1.pdf

f0 | = 2.4399 | GHz
f0 | = 2.4399 | GHz

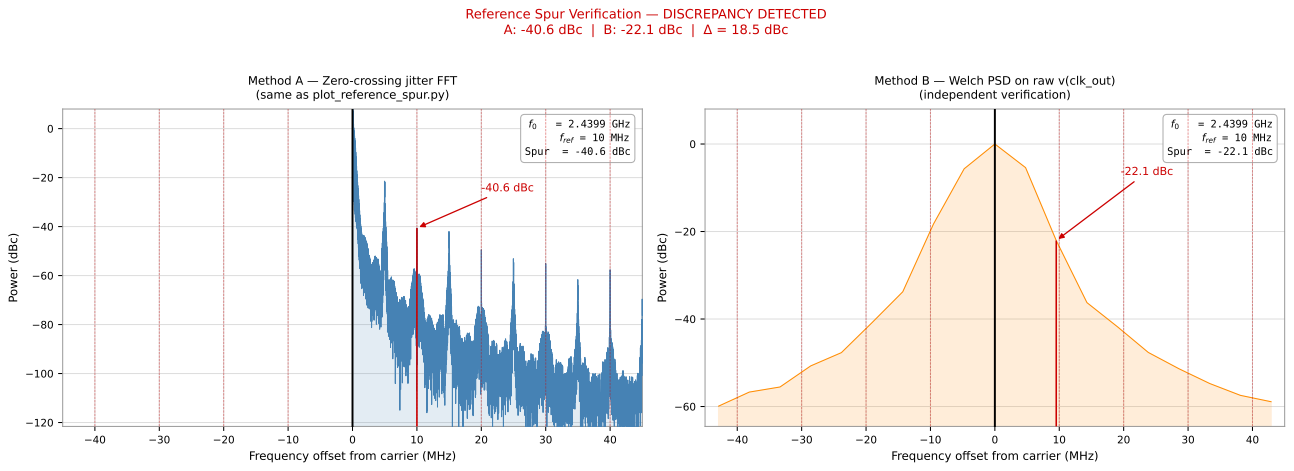
[picture p95: page 1]
Power (dBc); fref = 10; MHz; (independent verification)

Reference Spur Verification — DISCREPANCY DETECTED

A: -40.6 dBc | B: -22.1 dBc | Δ = 18.5 dBc

Method A — Zero-crossing jitter FFT
(same as plot_reference_spur.py)

Method B — Welch PSD on raw v(clk_out)

Spur = -40.6 | fref = 10 | MHz dBc

-22.1 dBc | Spur = -22.1 | dBc

-40.6 dBc

Frequency offset from carrier (MHz)
