Manimohan05/SG13G2_2.4GHz_LC_VCO_FPLL/HFSS Inductor Files/Workflow Development/Inductor_Workflow.pdf

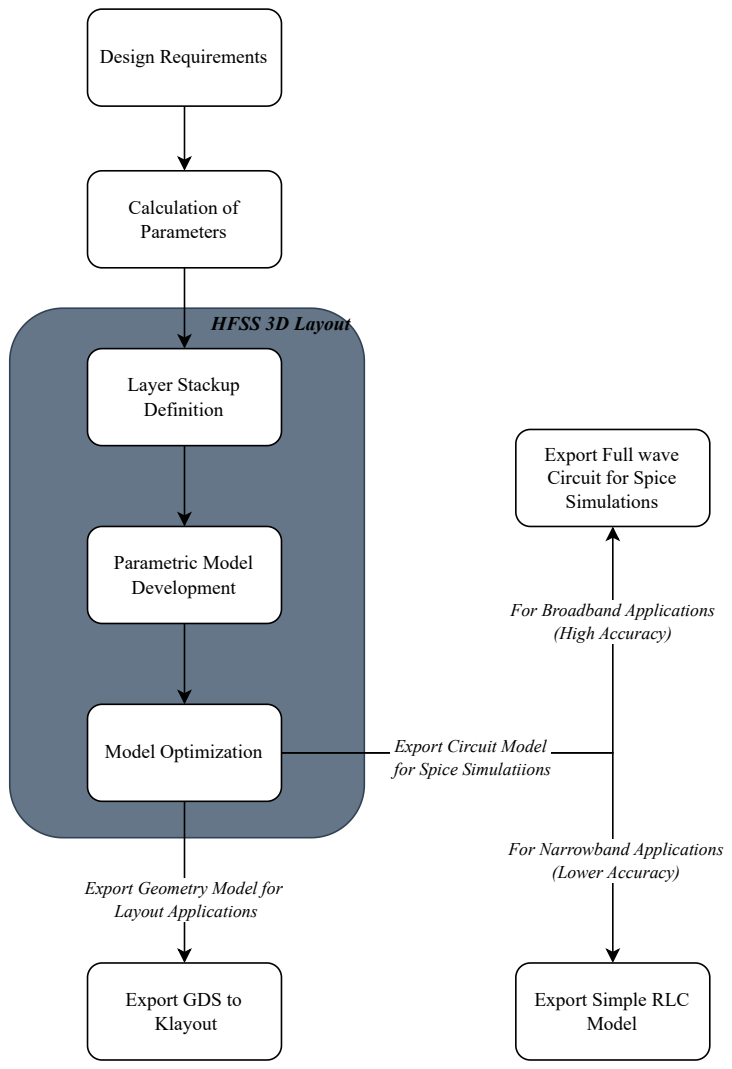
[picture p97: page 1]
Design Requirements; Calculation of Parameters; Layer Stackup Definition; Parametric Model Development; Model Optimization; HFSS 3D Layout

Export Full wave
Circuit for Spice
Simulations

For Broadband Applications
(High Accuracy)

Export Circuit Model
for Spice Simulatiions

For Narrowband Applications (Lower Accuracy)

Export Geometry Model for Layout Applications

Export GDS to
Klayout

Export Simple RLC
Model
