Manimohan05/SG13G2_2.4GHz_LC_VCO_FPLL/xschem/top-pll/plots/prelayout/plot_vctrl_transient.pdf

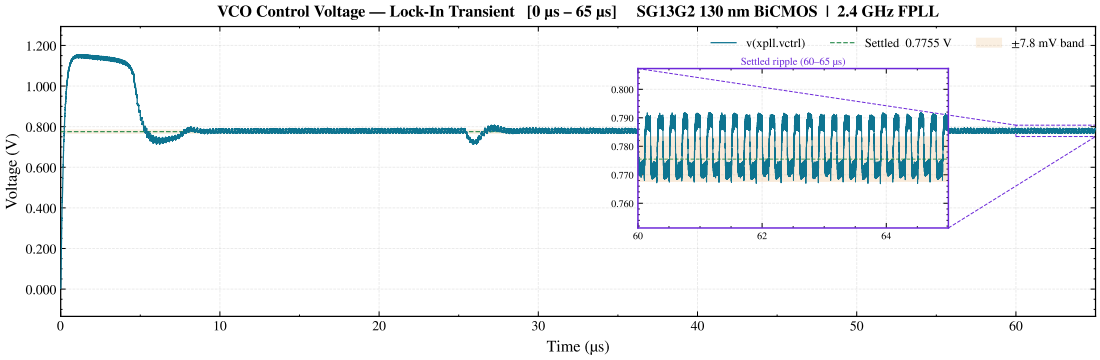
[picture p98: page 1]
Time (µs); Voltage (V)

VCO Control Voltage — Lock-In Transient [0 µs – 65 µs] SG13G2 130 nm BiCMOS | 2.4 GHz FPLL

v(xpll.vctrl) | Settled 0.7755 V ±7.8 mV band
Settled ripple (60–65 µs)
