Manimohan05/SG13G2_2.4GHz_LC_VCO_FPLL/xschem/top-pll/plots/prelayout/reference_spur_fixed_1.pdf

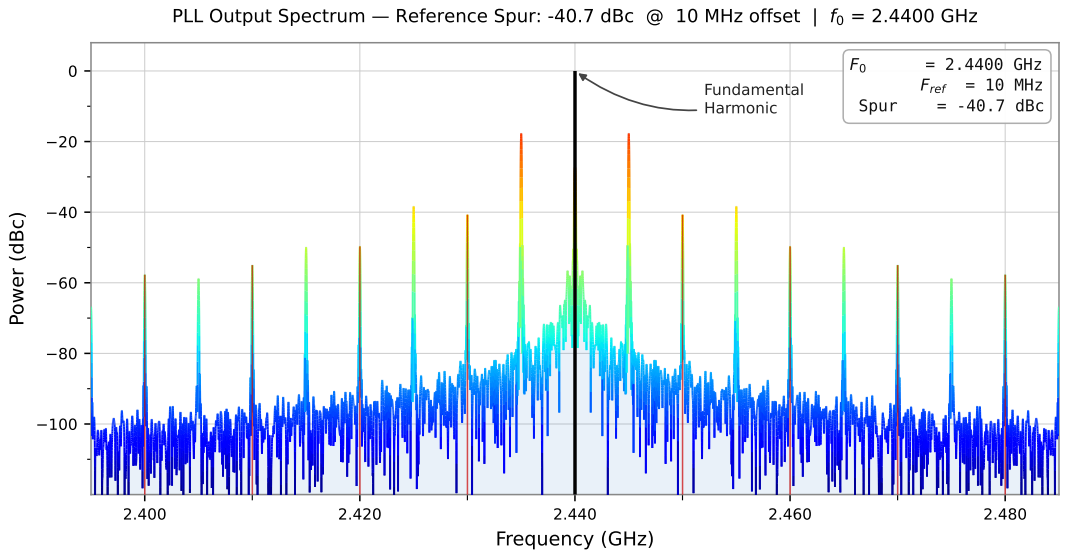
[picture p99: page 1]
Frequency (GHz); Power (dBc)

PLL Output Spectrum — Reference Spur: -40.7 dBc @ 10 MHz offset | f0 = 2.4400 GHz

F0 = 2.4400 | GHz

Fundamental Harmonic | Fref = 10 Spur = -40.7 | MHz dBc
