Manimohan05/SG13G2_2.4GHz_LC_VCO_FPLL/xschem/top-pll/plots/regenerated/vco_phase_noise_from_fft.pdf

−50

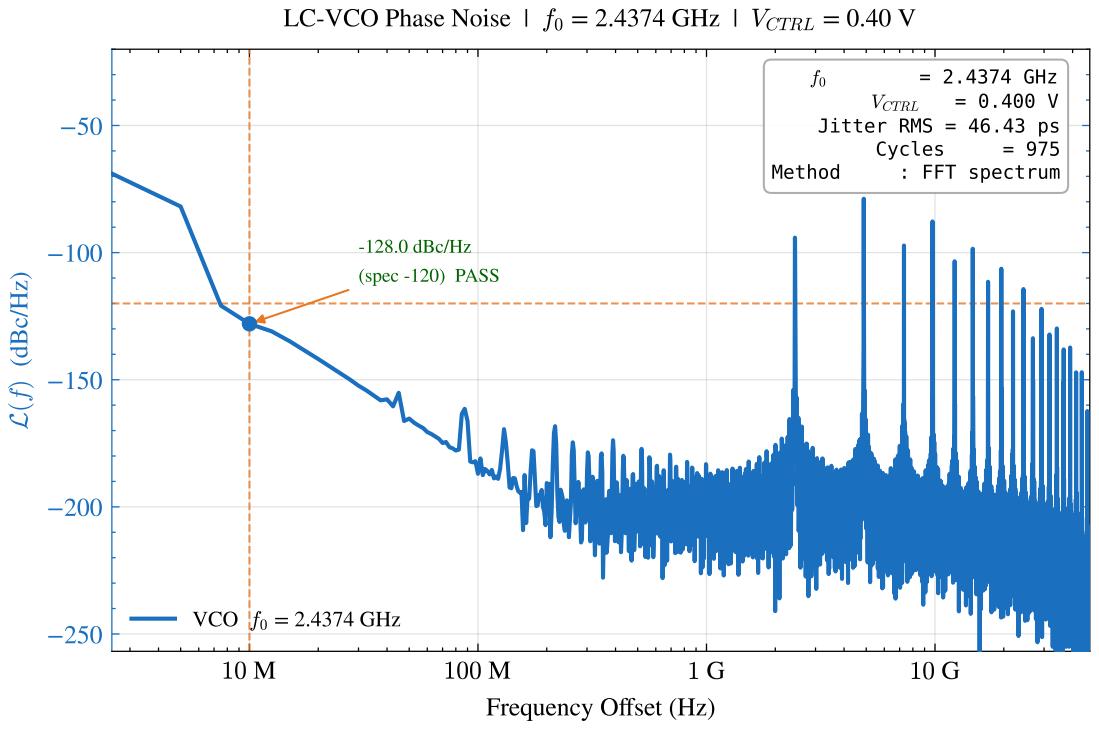
[picture p101: page 1]
VCO; f0 = 2.4374 GHz

LC-VCO Phase Noise | f0 = 2.4374 GHz | VCTRL = 0.40 V

f0 = VCTRL Jitter RMS | 2.4374 GHz = 0.400 V = 46.43 ps

-128.0 dBc/Hz | Cycles Method : FFT spectrum | = 975

(spec -120) PASS

Frequency Offset (Hz)
