Manimohan05/SG13G2_2.4GHz_LC_VCO_FPLL/paper_submission/pll_block.pdf

# VDD FREF FDIV

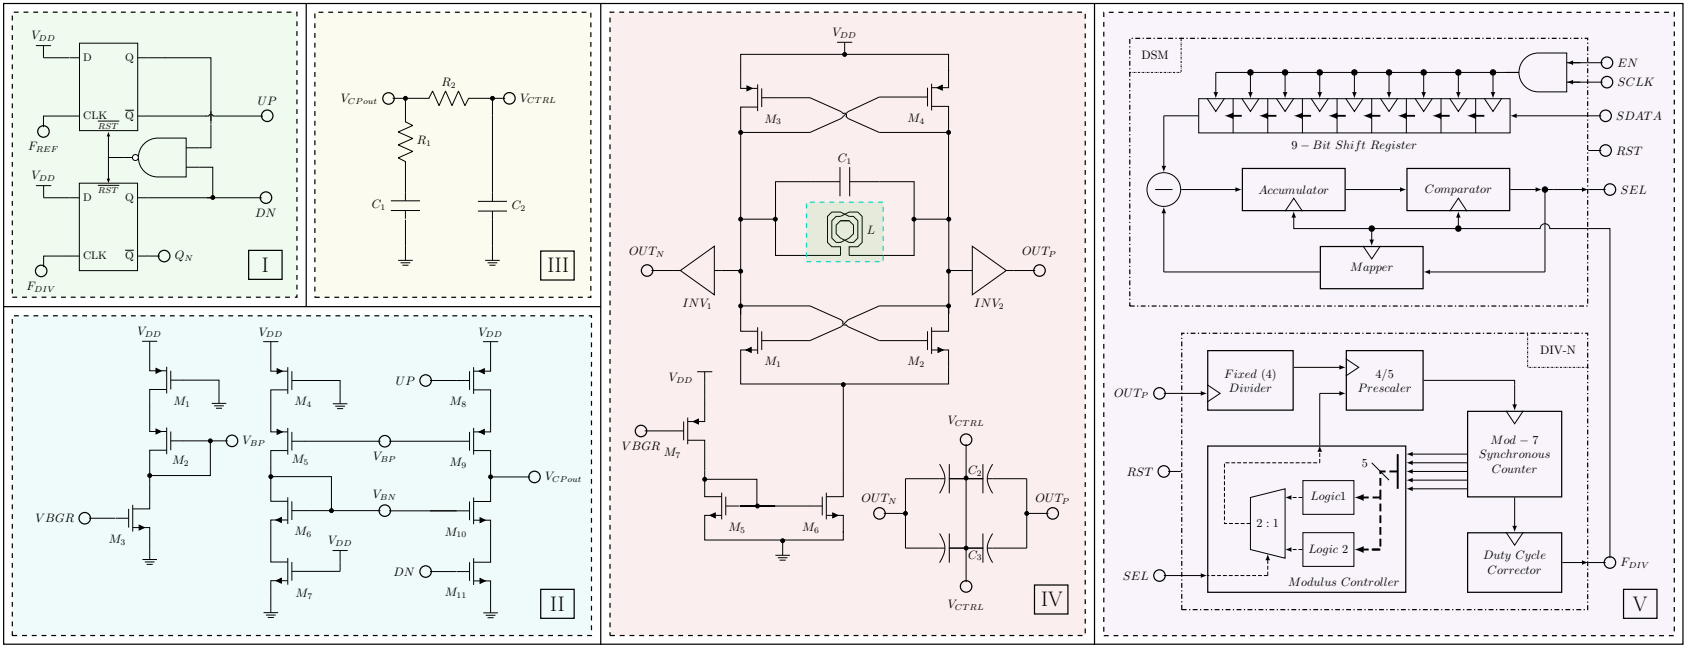
[picture p102: page 1]
Duty Cycle Corrector; 5 P rescaler; F ixed (4) Divider; Mod; 7 Synchronous Counter; SEL; FDIV; OUTP; DIV-N; Modulus Controller; Logic; RST; SCLK; SDAT A; Accumulator; Comparator; M apper; DSM; CLK; VDD; VBP; VBP VBN; VCP out; V BGR; III; VCT RL; VCT RL C3; OUTN; OUTP VCT RL C2; INV1; INV2

− Bit Shif t Register
