Manimohan05/SG13G2_2.4GHz_LC_VCO_FPLL/paper_submission/PLL_Layout.pdf

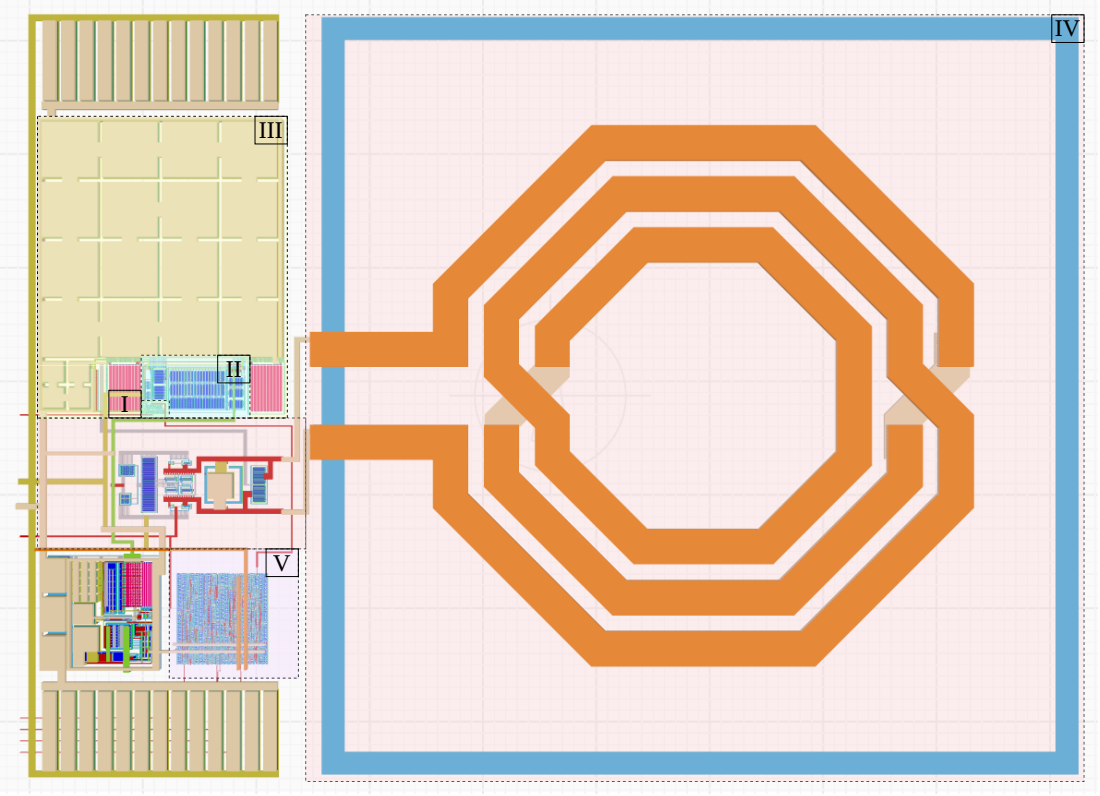
[picture p103: page 1]
III
