Manimohan05/SG13G2_2.4GHz_LC_VCO_FPLL/xschem/top-pll/plots/vco_tuning_pre_vs_post.pdf

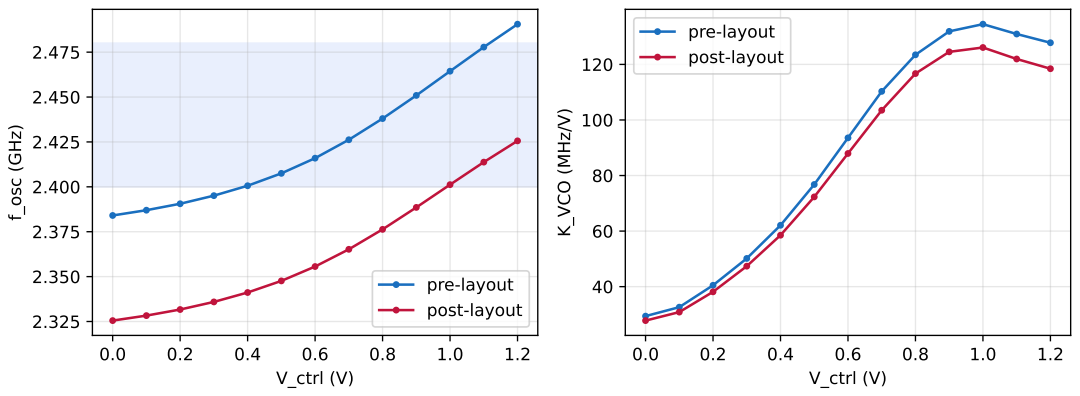
[picture p104: page 1]
V_ctrl (V); f_osc (GHz); pre-layout post-layout; K_VCO (MHz/V)
