Manimohan05/SG13G2_2.4GHz_LC_VCO_FPLL/HFSS Inductor Files/Results/Final_Inductor/inductor_comparison_plot_v2.pdf

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

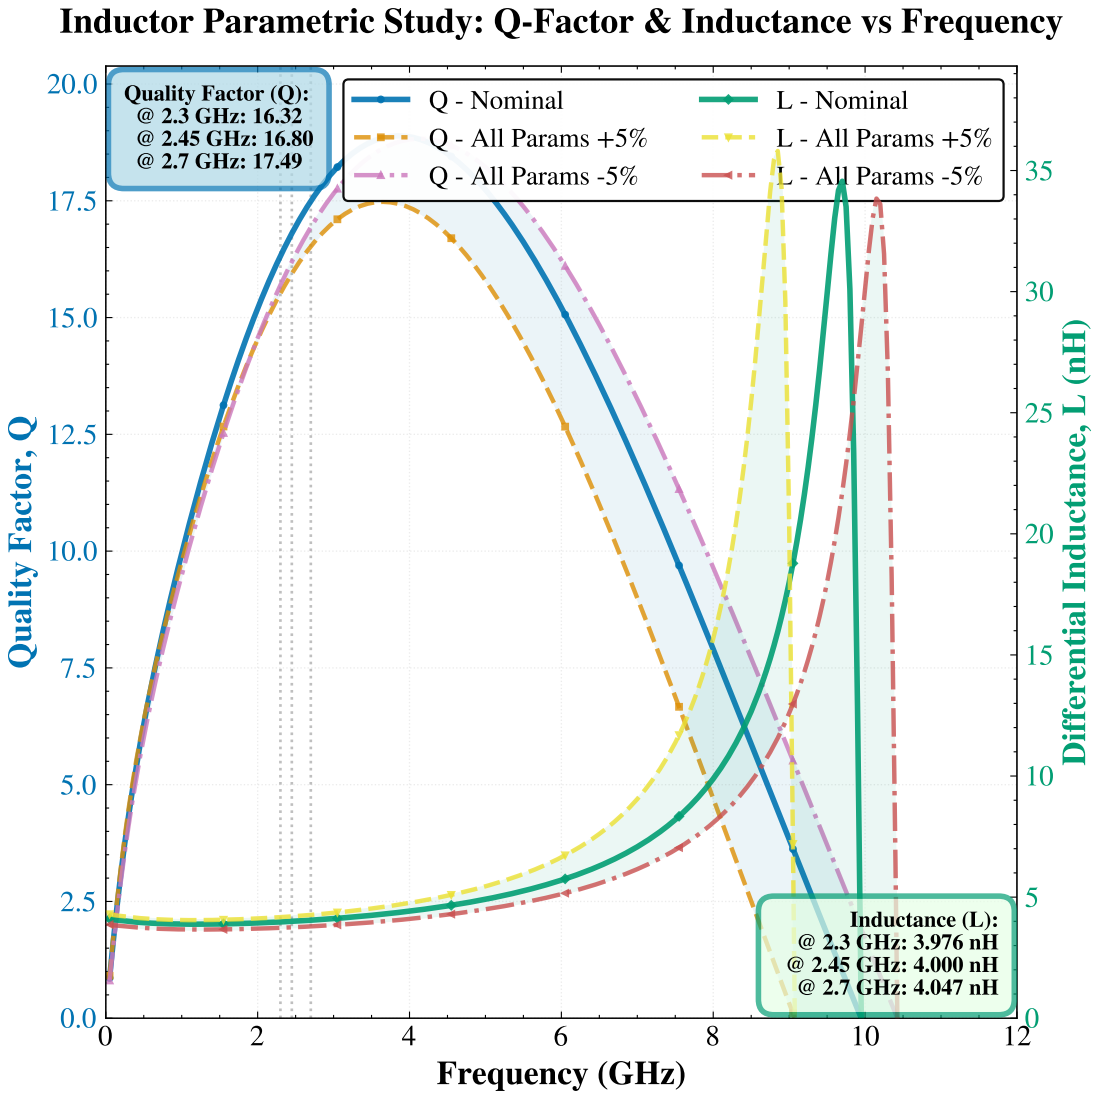
[picture p109: page 1]
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
