Manimohan05/SG13G2_2.4GHz_LC_VCO_FPLL/HFSS Inductor Files/Results/Results for the 2port inductor/radius_plots/L_vs_frequency.pdf

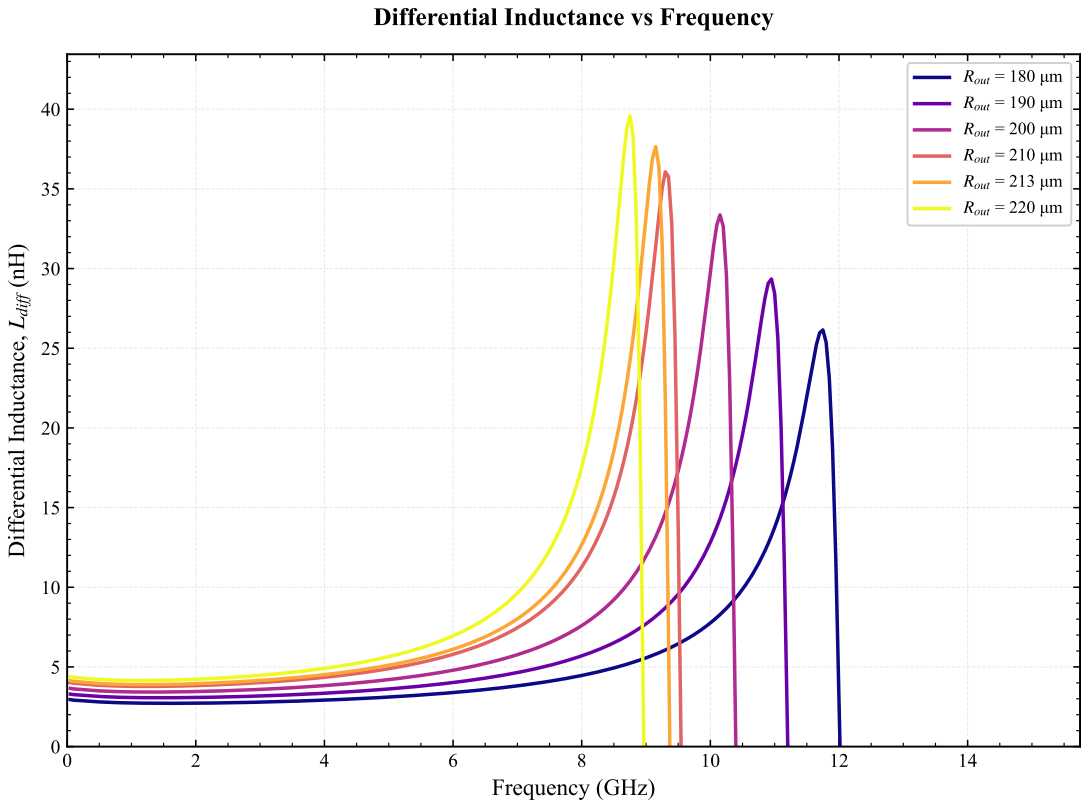
[picture p113: page 1]
Frequency (GHz)

Differential Inductance vs Frequency

Differential Inductance, Ldiff (nH)
