Manimohan05/SG13G2_2.4GHz_LC_VCO_FPLL/HFSS Inductor Files/Results/Results for the 2port inductor/Seperation_plots/combined_Q_L_vs_frequency.pdf

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

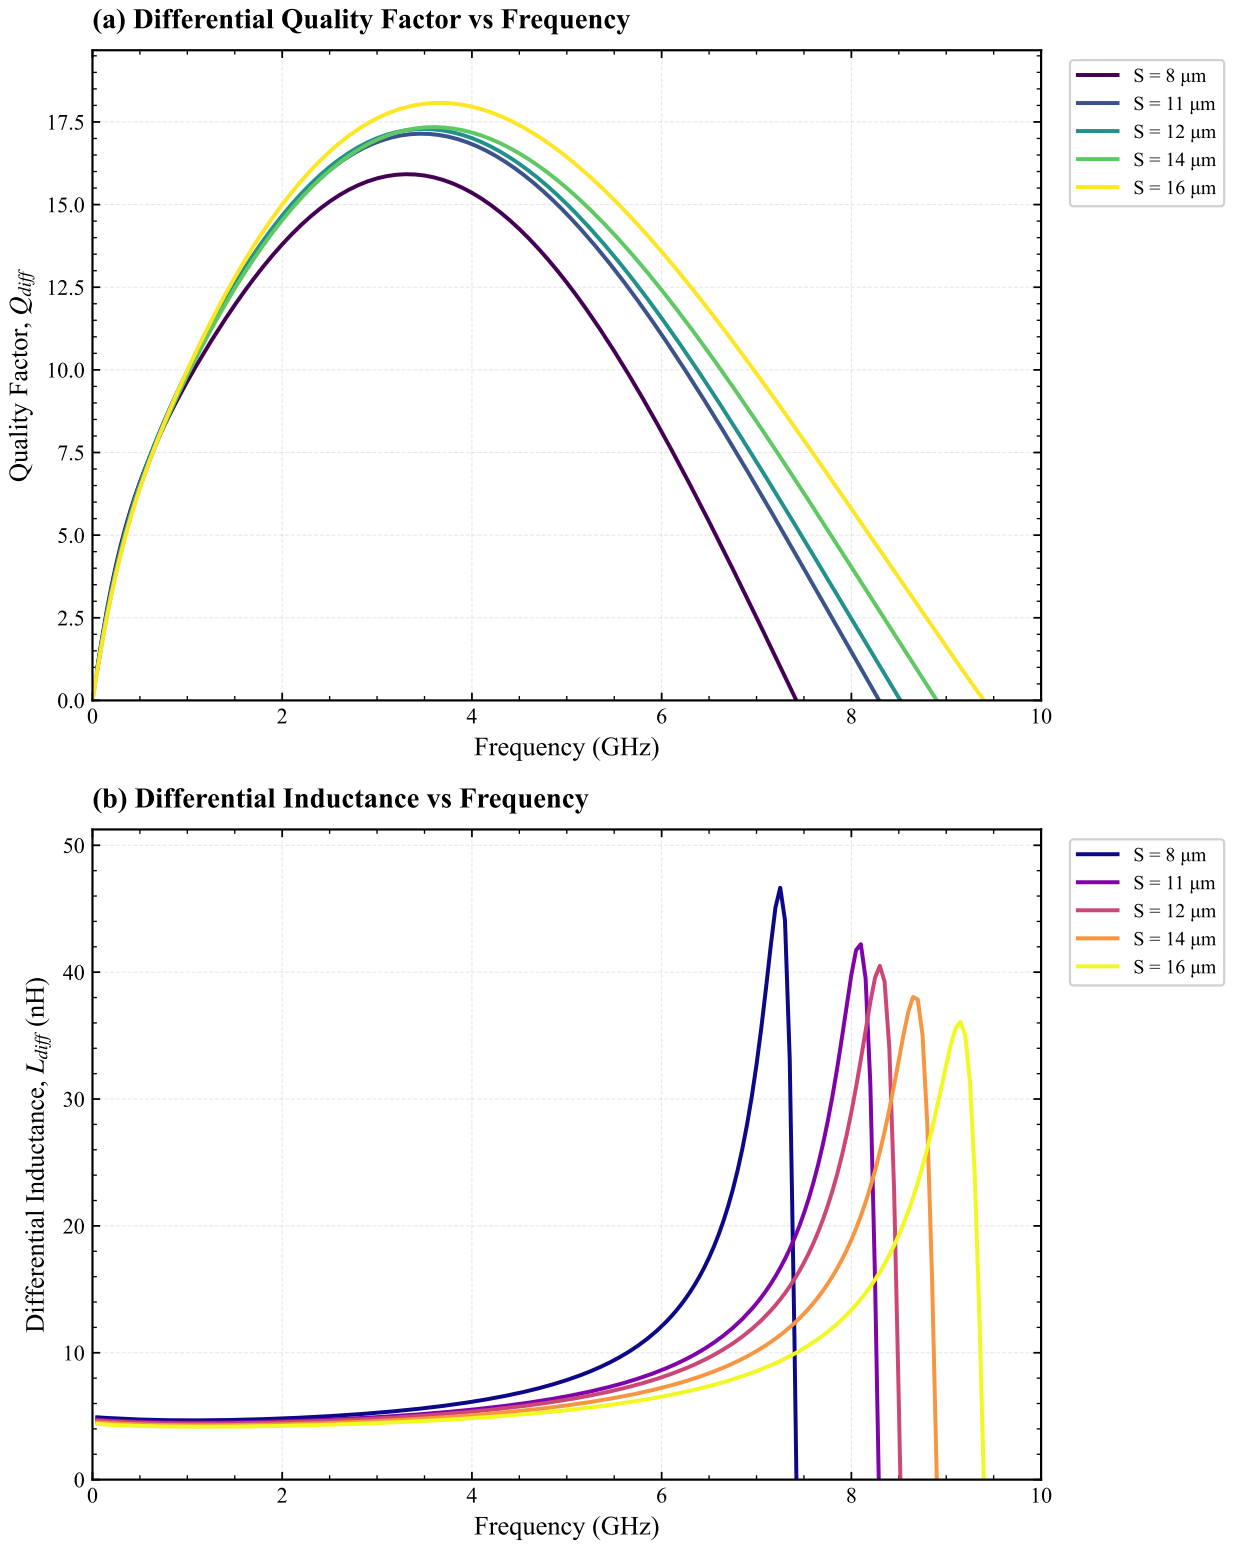
[picture p115: page 1]
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
