Manimohan05/SG13G2_2.4GHz_LC_VCO_FPLL/HFSS Inductor Files/Results/Results for the 2port inductor/width_plots/combined_Q_L_vs_frequency.pdf

## (a) Differential Quality Factor vs Frequency

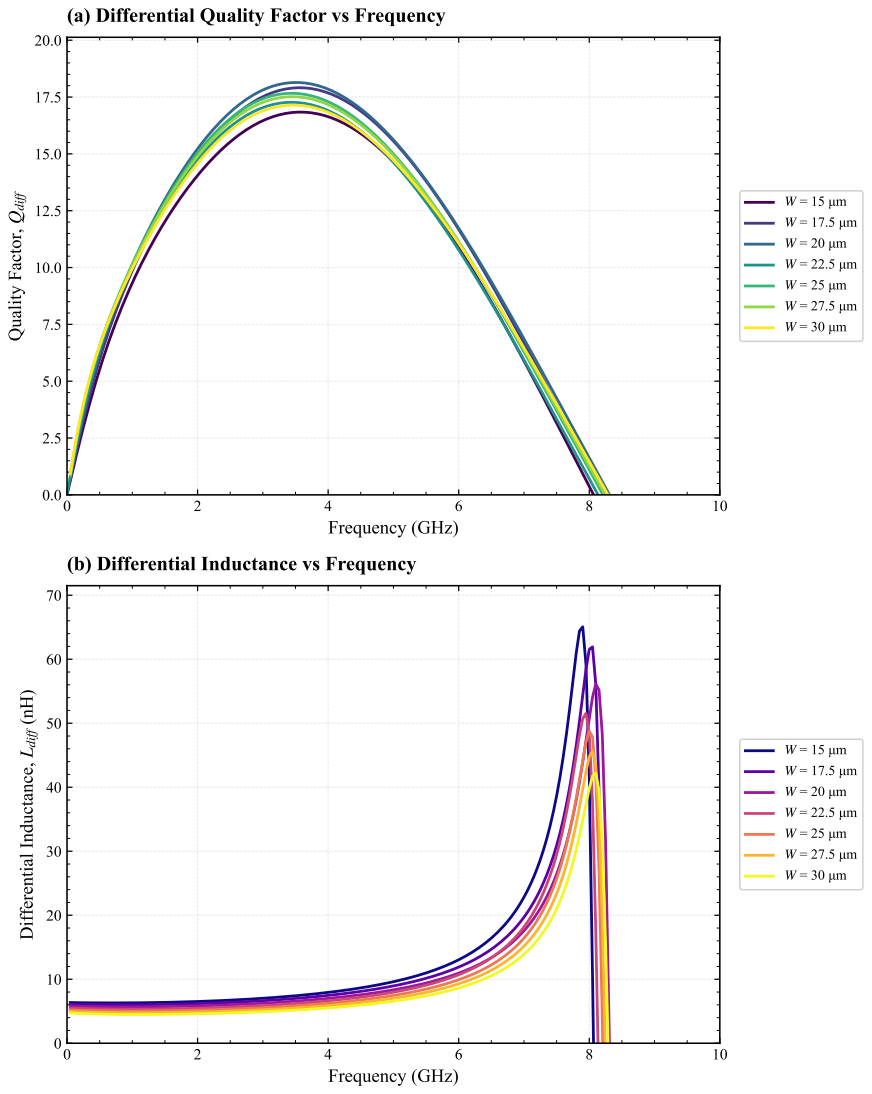
[picture p119: page 1]
Frequency (GHz); ality; ctor, Qdiff; Differe; ntial In; cta; e, Ldiff (n

(b) Differential Inductance vs Frequency
