Manimohan05/SG13G2_2.4GHz_LC_VCO_FPLL/HFSS Inductor Files/Results/Results for the 2port inductor/width_plots/dual_axis_L_Q_vs_frequency.pdf

## Differential Inductance and Quality Factor vs Frequency

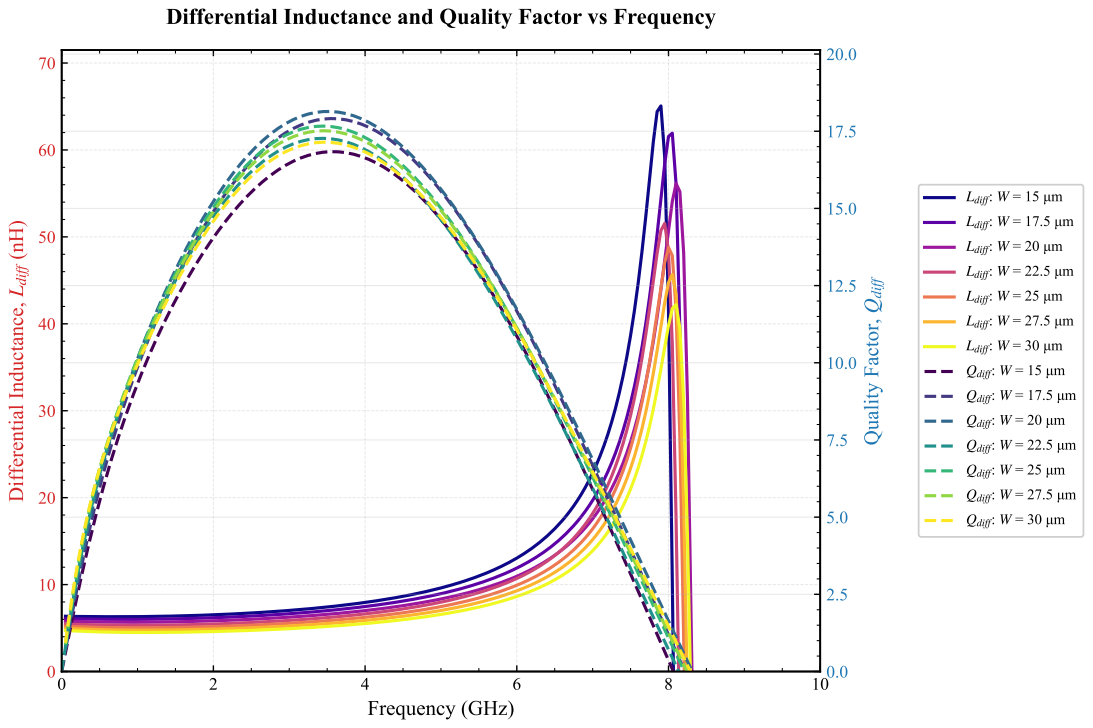
[picture p120: page 1]
Frequency (GHz); Differe; ntial In; cta; e, Ldiff (n; Ldiff; Qdiff; ality; ctor, Qdiff
