Manimohan05/SG13G2_2.4GHz_LC_VCO_FPLL/HFSS Inductor Files/Results/Results for the 2port inductor/width_plots/L_vs_frequency.pdf

## Differential Inductance vs Frequency

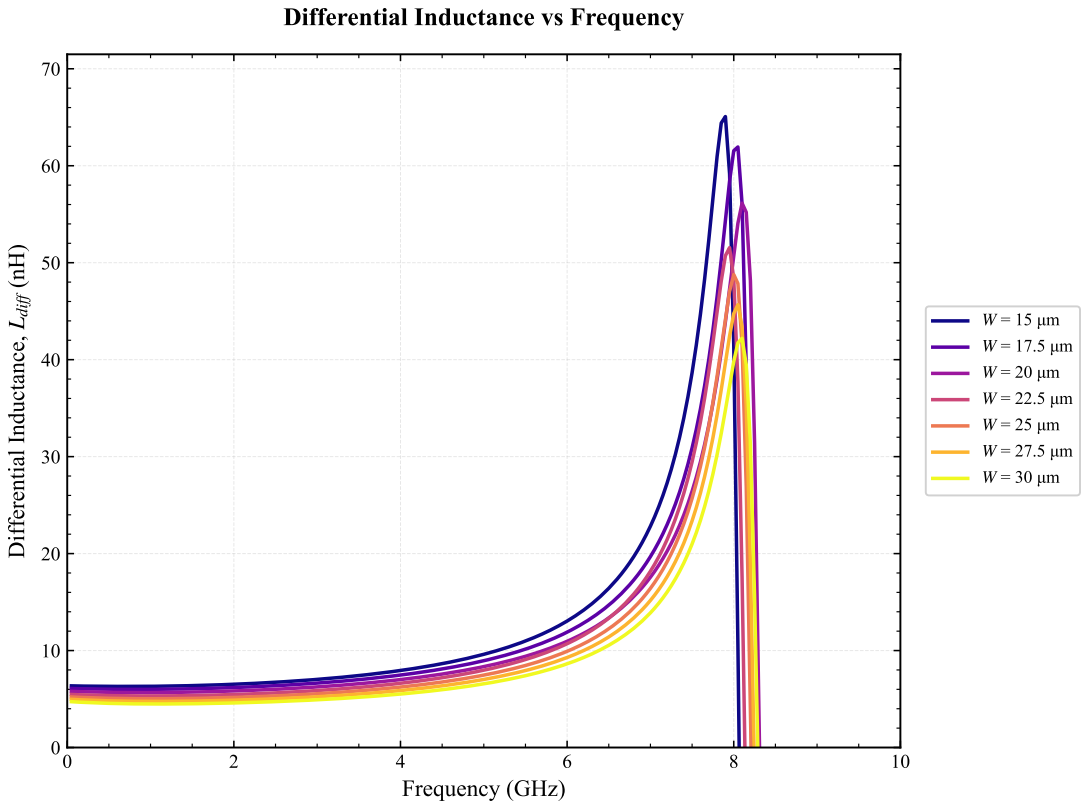
[picture p121: page 1]
Frequency (GHz); Differe; ntial In; cta; e, Ldiff (n
