Manimohan05/SG13G2_2.4GHz_LC_VCO_FPLL/HFSS Inductor Files/Results/Results for the 2port inductor/width_plots/Q_vs_frequency.pdf

## Differential Quality Factor vs Frequency

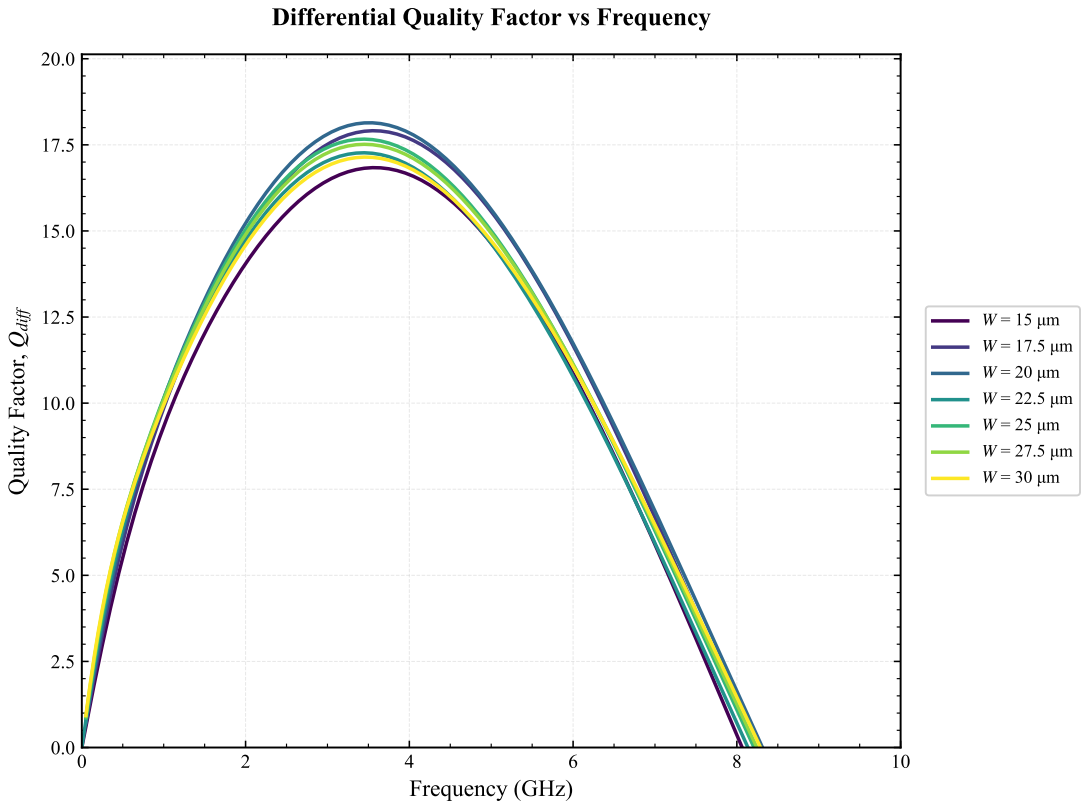
[picture p122: page 1]
Frequency (GHz); ality; ctor, Qdiff
