Manimohan05/SG13G2_2.4GHz_LC_VCO_FPLL/model/qucs_freq_divider/240_248_Divider/240_248_Divider.pdf

## SR D

## SR D

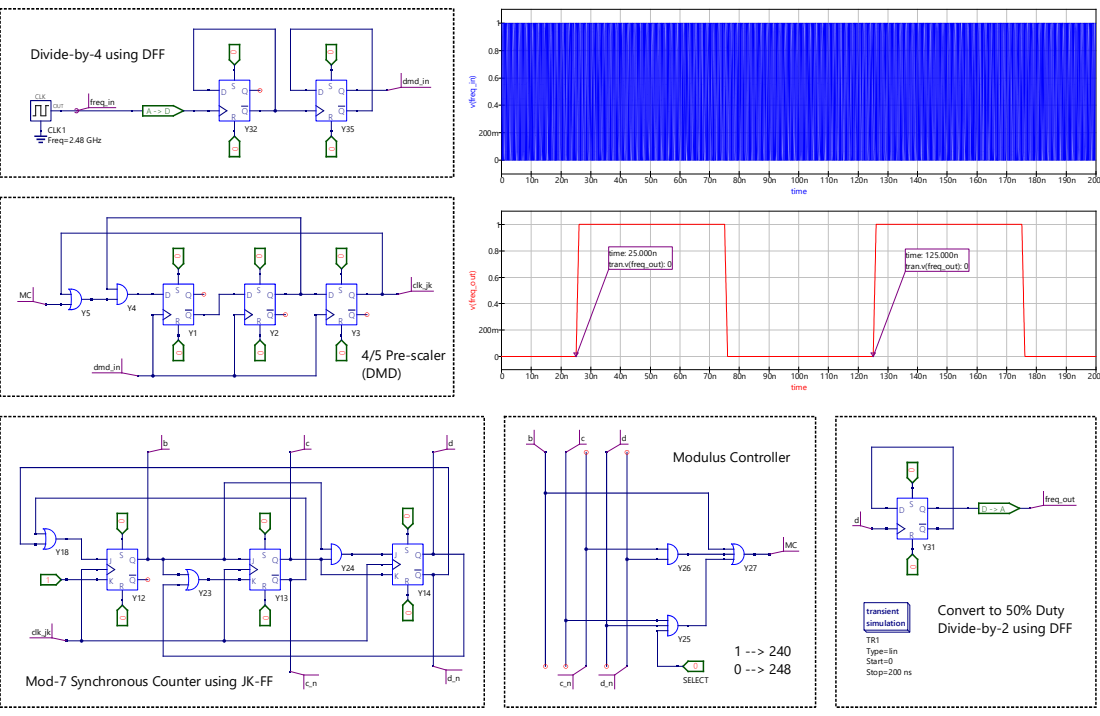
[picture p125: page 1]
CLK; OUT CLK1; Freq=2.48 GHz; transient simulation; TR1 Type=lin Start=0 Stop=200 ns; freq_in; freq_out MC; dmd_in; clk_jk; 4/5 Pre-scaler (DMD); Modulus Controller; time v⁽freq_in⁾; time v⁽freq_out⁾

Divide-by-4 using DFF

time: 25.000n
tran.v(freq_out): 0 | time: 125.000n tran.v(freq_out): 0

Convert to 50% Duty
Divide-by-2 using DFF

Mod-7 Synchronous Counter using JK-FF
