Manimohan05/SG13G2_2.4GHz_LC_VCO_FPLL/xschem/top-pll/plots/vco_phase_noise.pdf

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

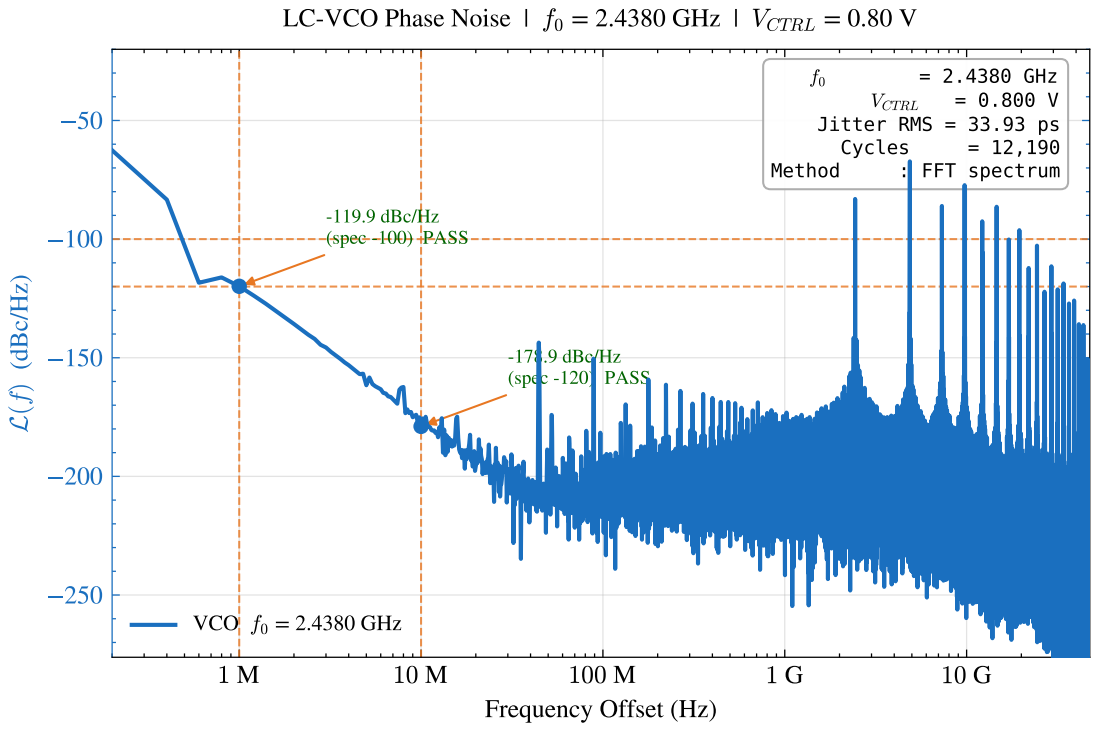
[picture p128: page 1]
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
