Manimohan05/SG13G2_2.4GHz_LC_VCO_FPLL/xschem/top-pll/plots/prelayout/phase_noise_steady_1.pdf

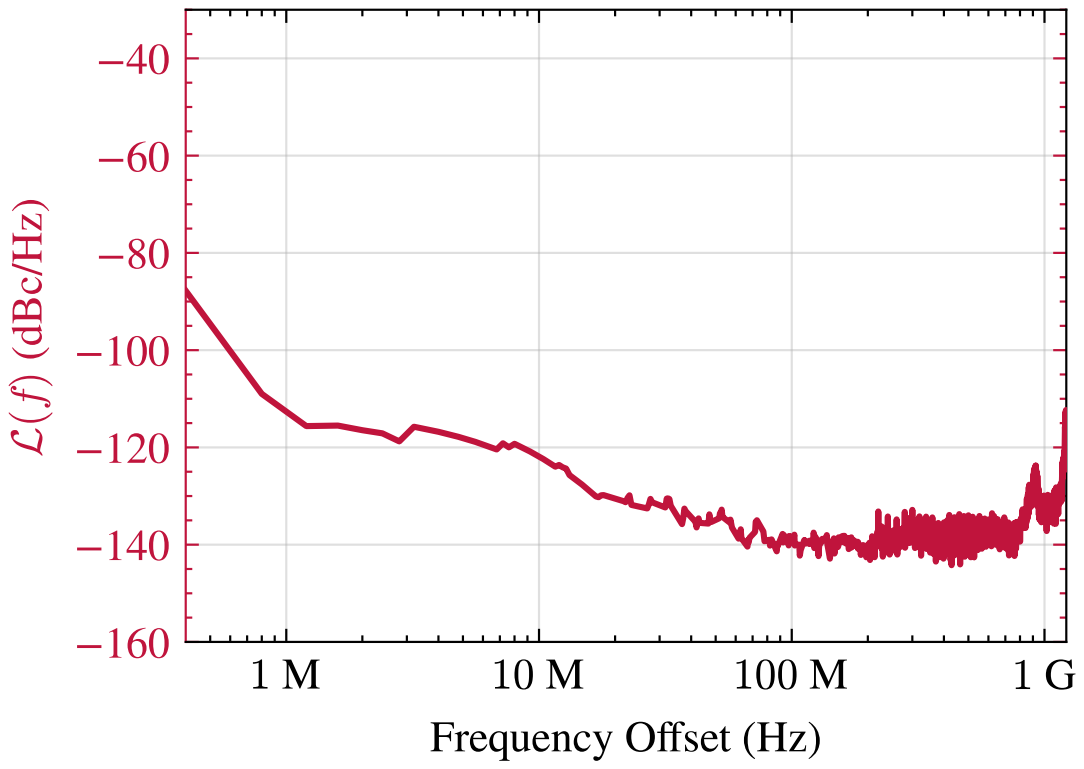
[picture p129: page 1]

Frequency Offset (Hz)
