Manimohan05/SG13G2_2.4GHz_LC_VCO_FPLL/xschem/top-pll/plots/prelayout/phase_noise_steady_2.pdf

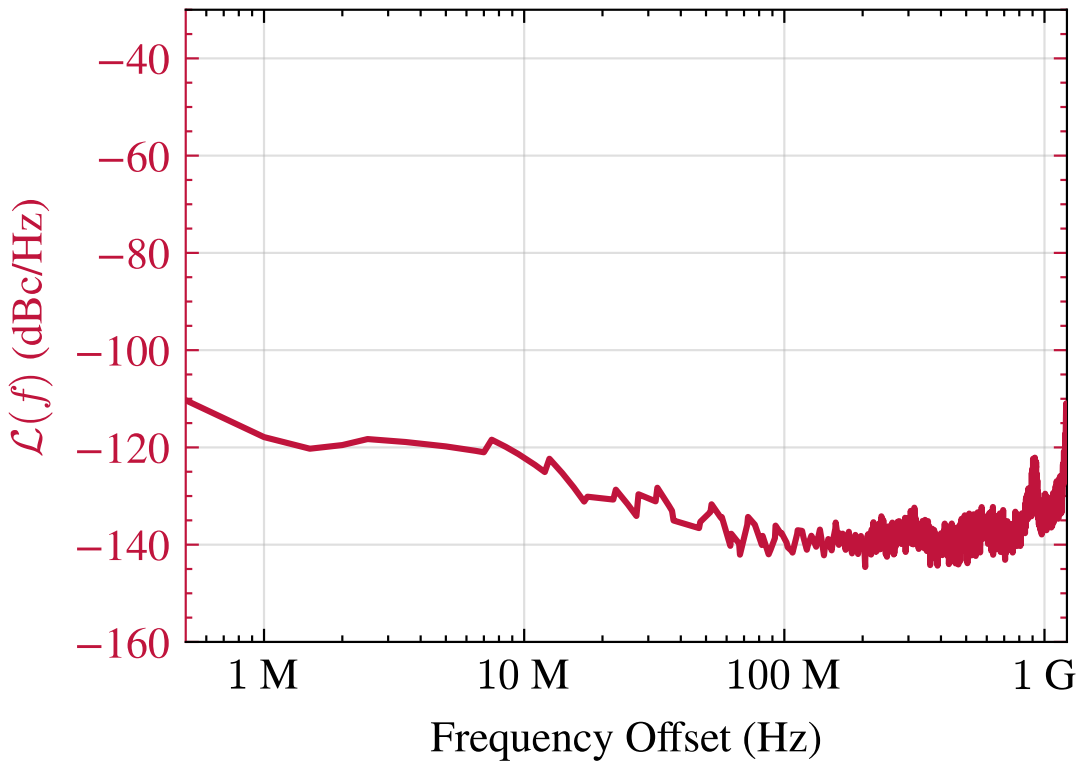
[picture p130: page 1]
Frequency O; ffset (Hz); L(f) (dBc/Hz)
