Manimohan05/SG13G2_2.4GHz_LC_VCO_FPLL/xschem/top-pll/plots/prelayout/phase_noise_with_tone_1.pdf

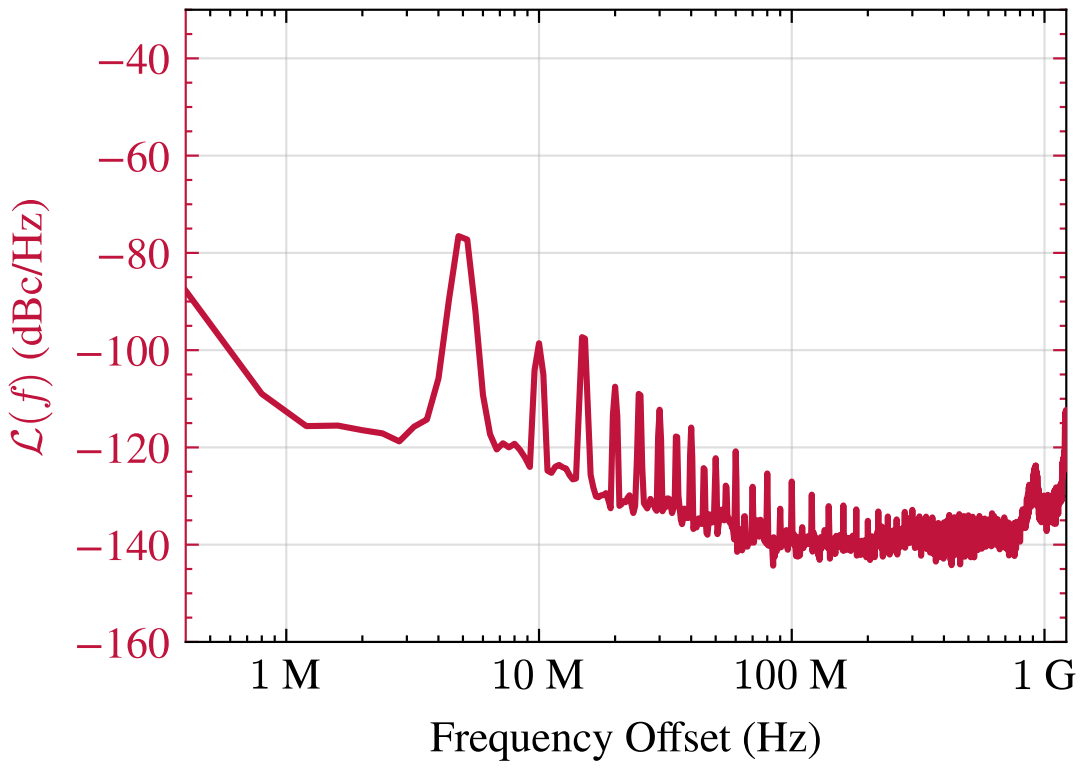
[picture p131: page 1]

Frequency Offset (Hz)
