Manimohan05/SG13G2_2.4GHz_LC_VCO_FPLL/xschem/top-pll/plots/prelayout/pll_lock_error.pdf

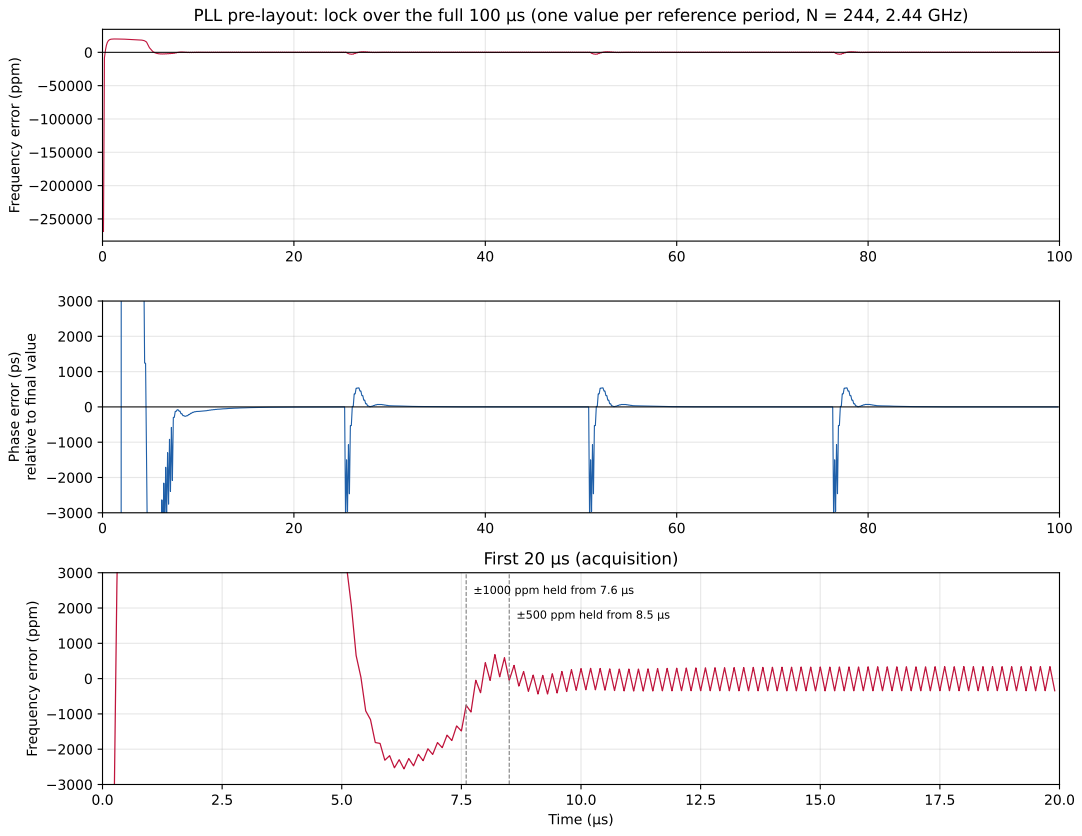
[picture p133: page 1]
relative to; final value; Time (µs)

PLL pre-layout: lock over the full 100 µs (one value per reference period, N = 244, 2.44 GHz)

Frequency error (ppm)

Phase error (ps)

First 20 µs (acquisition)

±1000 ppm held from 7.6 µs
±500 ppm held from 8.5 µs
