Manimohan05/SG13G2_2.4GHz_LC_VCO_FPLL/xschem/top-pll/plots/prelayout/pll_steady_state_pn_spur.pdf

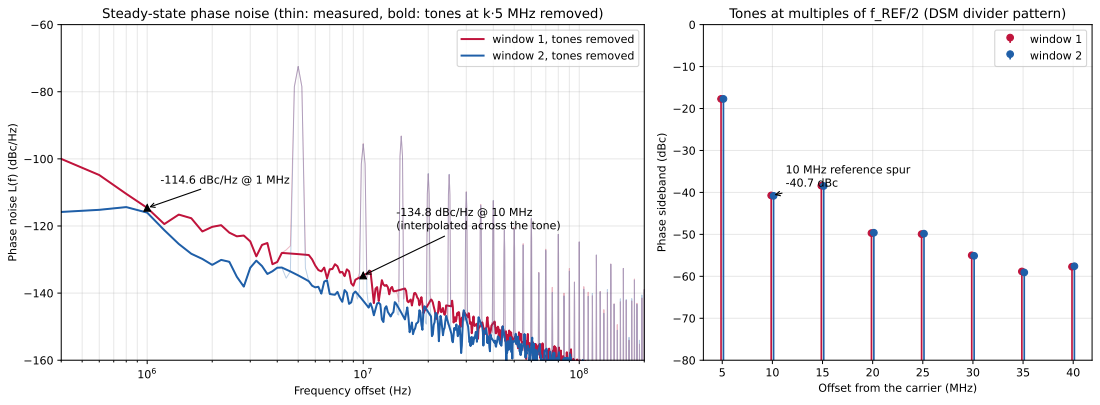
[picture p134: page 1]
window 1 window 2

Steady-state phase noise (thin: measured, bold: tones at k·5 MHz removed)

Tones at multiples of f_REF/2 (DSM divider pattern)

window 1, tones removed
window 2, tones removed

Phase noise L(f) (dBc/Hz)

Phase sideband (dBc)

10 MHz reference spur
-40.7 dBc

-114.6 dBc/Hz @ 1 MHz

-134.8 dBc/Hz @ 10 MHz
(interpolated across the tone)

Frequency offset (Hz)

Offset from the carrier (MHz)
