Manimohan05/SG13G2_2.4GHz_LC_VCO_FPLL/HFSS Inductor Files/Results/Results for the 2port inductor/Star-Hspice/Feb_01st_fws.sp

* BEGIN ANSOFT HEADER
* node 1    Port1:1
* node 2    Port2:1
*   Format: HSPICE
*   Topckt: Feb_01st_fws
*     Date: Thu Feb 12 16:04:12 2026
*    Notes: Frequency range: 0 to 1.5e+010 Hz, 301 points
*         : Maximum number of poles: 10000
*         : S-Matrix fitting error tolerance: 0.005
*         : Causality check tolerance: auto
*         : Passivity enforcement: off
*         : Causality enforcement: off
*         : Fitting method: TWA
*         : Matrix fitting: By entire matrix
*         : Ensure Z-parameter accuracy: on
*         : Relative error control: off
*         : Common ground option: on
*         : Final fitting error: 0.000123148
*         : Final model order: 20
* END ANSOFT HEADER

.subckt Feb_01st_fws 1 2
Vam1 1 n2 dc 0
Rport1 n2 0 50 noise=0
Vam2 2 n4 dc 0
Rport2 n4 0 50 noise=0

Fi1 0 ni1 Vam1 50
Gi1 0 ni1 1 0 1
Rt1 ni1 0 1 noise=0
Fi2 0 ni2 Vam2 50
Gi2 0 ni2 2 0 1
Rt2 ni2 0 1 noise=0

Ca1 ns1 0 1e-012
Ra1 ns1 0 65383.3304115 noise=0
Ca2 ns2 0 1e-012
Ra2 ns2 0 700.985908422 noise=0
Ca3 ns3 0 1e-012
Ca4 ns4 0 1e-012
Ra3 ns3 0 3203.97806018 noise=0
Ra4 ns4 0 3203.97806018 noise=0
Ga3 ns3 0 ns4 0 -0.00360543294404
Ga4 ns4 0 ns3 0 0.00360543294404
Ca5 ns5 0 1e-012
Ra5 ns5 0 229.153207458 noise=0
Ca6 ns6 0 1e-012
Ra6 ns6 0 75.0246573467 noise=0
Ca7 ns7 0 1e-012
Ra7 ns7 0 27.5143222557 noise=0
Ca8 ns8 0 1e-012
Ca9 ns9 0 1e-012
Ra8 ns8 0 6.38396750515 noise=0
Ra9 ns9 0 6.38396750515 noise=0
Ga8 ns8 0 ns9 0 -0.162554117523
Ga9 ns9 0 ns8 0 0.162554117523
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
Gc2_16 0 n4 ns16 0 0.000355783181274
Gc2_17 0 n4 ns17 0 0.0361772381767
Gc2_18 0 n4 ns18 0 0.0548302977393
Gc2_19 0 n4 ns19 0 -0.010837348132
Gc2_20 0 n4 ns20 0 -0.110555514531
Gd2_1 0 n4 ni1 0 0.00170840182023
Gd2_2 0 n4 ni2 0 -0.010013828236
.ends Feb_01st_fws
