Manimohan05/SG13G2_2.4GHz_LC_VCO_FPLL/spice/LC_VCO_FPLL.spice

** sch_path: /home/designer/shared/LC_VCO_FPLL/xschem/LC_VCO_FPLL.sch
.subckt LC_VCO_FPLL CLK_IN VDD CLK_OUT VSS EN RST SDATA SCLK
*.PININFO CLK_IN:I CLK_OUT:O EN:I SDATA:I SCLK:I RST:I VDD:B VSS:B
x1 CLK_IN UP VDD VSS CLK_FB DN PHASE_FREQ_DET
x2 UP VDD VCP VBGR VSS DN VSS CHARGE_PUMP
x3 VCTRL VCP VSS VSS LOOP_FILTER
x4 VDD VCTRL VSS CLK_OUT VBGR VSS LC_VCO
x5 CLK_OUT RST SCLK SDATA EN CLK_FB VDD VSS DSM_N_FREQ_DIV
x6 VDD VSS VBGR VSS BANDGAP_REF
CC1 VDD VSS cap_cmim w=20.0e-6 l=20.0e-6 m=40
**** begin user architecture code


* NGSPICE file created from DSM_N_FREQ_DIV.ext - technology: ihp-sg13g2

.subckt DSM_N_FREQ_DIV freq_in rst sclk sdata en freq_out VDD GND
XFILLER_13_111 VDD GND sg13g2_decap_8
XFILLER_9_159 VDD GND sg13g2_decap_8
XFILLER_3_67 VDD GND sg13g2_fill_1
XFILLER_10_147 VDD GND sg13g2_decap_8
X_200_ _200_/Y _200_/A _200_/B _200_/C VDD GND sg13g2_nand3_1
X_131_ _263_/D _263_/Q _262_/Q _130_/Y VDD GND sg13g2_a21oi_1
XFILLER_0_35 VDD GND sg13g2_decap_8
XFILLER_9_33 VDD GND sg13g2_decap_8
XFILLER_18_64 VDD GND sg13g2_fill_1
Xfanout7 _213_/A _260_/Q VDD GND sg13g2_buf_1
XFILLER_20_21 VDD GND sg13g2_decap_8
XFILLER_6_89 VDD GND sg13g2_decap_8
XFILLER_15_21 VDD GND sg13g2_decap_8
XFILLER_15_76 VDD GND sg13g2_decap_8
XFILLER_13_156 VDD GND sg13g2_decap_8
XFILLER_3_57 VDD GND sg13g2_fill_1
XFILLER_3_46 VDD GND sg13g2_decap_8
X_130_ _130_/Y _262_/Q _261_/Q _263_/Q VDD GND sg13g2_a21oi_1
XFILLER_0_14 VDD GND sg13g2_decap_8
X_259_ _259_/Q _260_/Q _259_/D _232_/Y VDD GND sg13g2_dfrbpq_1
XFILLER_9_67 VDD GND sg13g2_fill_2
XFILLER_2_144 VDD GND sg13g2_decap_8
XFILLER_18_54 VDD GND sg13g2_fill_2
XFILLER_15_7 VDD GND sg13g2_decap_8
Xfanout8 _224_/A input2/X VDD GND sg13g2_buf_1
XFILLER_20_77 VDD GND sg13g2_decap_8
XFILLER_6_68 VDD GND sg13g2_fill_1
XFILLER_19_151 VDD GND sg13g2_decap_8
XFILLER_16_165 VDD GND sg13g2_fill_2
XFILLER_9_128 VDD GND sg13g2_decap_8
XFILLER_10_116 VDD GND sg13g2_decap_8
XFILLER_10_138 VDD GND sg13g2_fill_1
XFILLER_5_164 VDD GND sg13g2_fill_2
X_189_ _196_/B _248_/Q _195_/B VDD GND sg13g2_xor2_1
X_258_ _258_/Q _260_/Q _258_/D _231_/Y VDD GND sg13g2_dfrbpq_1
XFILLER_9_79 VDD GND sg13g2_decap_8
Xfanout9 _232_/A input2/X VDD GND sg13g2_buf_1
XFILLER_1_0 VDD GND sg13g2_decap_8
XFILLER_20_56 VDD GND sg13g2_decap_8
XFILLER_6_47 VDD GND sg13g2_decap_8
XFILLER_19_130 VDD GND sg13g2_decap_8
XFILLER_15_56 VDD GND sg13g2_decap_8
XFILLER_13_136 VDD GND sg13g2_fill_1
XFILLER_9_107 VDD GND sg13g2_decap_8
XFILLER_12_35 VDD GND sg13g2_fill_2
XFILLER_5_7 VDD GND sg13g2_decap_8
XFILLER_5_143 VDD GND sg13g2_decap_8
XFILLER_0_49 VDD GND sg13g2_decap_8
X_188_ _192_/B _256_/Q _188_/B VDD GND sg13g2_nand2_1
X_257_ _257_/Q _260_/Q _257_/D _230_/Y VDD GND sg13g2_dfrbpq_1
XFILLER_9_69 VDD GND sg13g2_fill_1
XFILLER_9_47 VDD GND sg13g2_decap_4
XFILLER_6_26 VDD GND sg13g2_decap_8
XFILLER_20_35 VDD GND sg13g2_decap_8
XFILLER_20_7 VDD GND sg13g2_decap_8
XFILLER_15_35 VDD GND sg13g2_decap_8
XFILLER_13_104 VDD GND sg13g2_decap_8
XFILLER_7_91 VDD GND sg13g2_fill_2
XFILLER_7_80 VDD GND sg13g2_decap_8
XFILLER_8_130 VDD GND sg13g2_decap_4
XFILLER_5_122 VDD GND sg13g2_fill_2
XFILLER_5_166 VDD GND sg13g2_fill_1
XFILLER_2_158 VDD GND sg13g2_decap_4
XFILLER_2_136 VDD GND sg13g2_decap_4
XFILLER_2_114 VDD GND sg13g2_fill_1
XFILLER_0_28 VDD GND sg13g2_decap_8
XFILLER_13_90 VDD GND sg13g2_decap_8
X_256_ _256_/Q _213_/A _256_/D _229_/Y VDD GND sg13g2_dfrbpq_1
X_187_ _192_/A _247_/Q _195_/B VDD GND sg13g2_nand2_1
XFILLER_9_26 VDD GND sg13g2_decap_8
Xclkload0 clkload0/Y _250_/CLK VDD GND sg13g2_inv_1
X_239_ _239_/Y _239_/A VDD GND sg13g2_inv_1
XFILLER_20_14 VDD GND sg13g2_decap_8
XFILLER_19_165 VDD GND sg13g2_fill_2
XFILLER_15_14 VDD GND sg13g2_decap_8
XFILLER_15_69 VDD GND sg13g2_decap_8
XFILLER_16_113 VDD GND sg13g2_decap_4
XFILLER_11_4 VDD GND sg13g2_decap_4
XFILLER_13_149 VDD GND sg13g2_decap_8
XFILLER_4_93 VDD GND sg13g2_decap_8
X_255_ _255_/Q _213_/A _255_/D _228_/Y VDD GND sg13g2_dfrbpq_1
X_186_ _194_/A _172_/A _183_/Y _185_/Y VDD GND sg13g2_o21ai_1
X_238_ _238_/Y _239_/A VDD GND sg13g2_inv_1
X_169_ _171_/A _170_/A _170_/B _170_/C VDD GND sg13g2_a21oi_1
XFILLER_1_94 VDD GND sg13g2_decap_4
XFILLER_10_81 VDD GND sg13g2_decap_8
XFILLER_19_144 VDD GND sg13g2_decap_8
Xclkbuf_1_0__f_sclk _246_/CLK clkbuf_0_sclk/X VDD GND sg13g2_buf_16
XFILLER_10_109 VDD GND sg13g2_decap_8
XFILLER_12_49 VDD GND sg13g2_decap_4
XFILLER_5_157 VDD GND sg13g2_decap_8
XFILLER_5_102 VDD GND sg13g2_decap_8
XFILLER_4_72 VDD GND sg13g2_decap_8
X_254_ _254_/Q _213_/A _254_/D _227_/Y VDD GND sg13g2_dfrbpq_1
X_185_ _185_/Y _171_/A _184_/Y _179_/B VDD GND sg13g2_a21oi_1
XFILLER_3_7 VDD GND sg13g2_fill_2
XFILLER_2_127 VDD GND sg13g2_fill_1
XFILLER_1_160 VDD GND sg13g2_decap_8
X_237_ _237_/Y _241_/A VDD GND sg13g2_inv_1
X_168_ _170_/C _255_/Q _174_/B VDD GND sg13g2_xnor2_1
XFILLER_20_49 VDD GND sg13g2_decap_8
XFILLER_19_123 VDD GND sg13g2_decap_8
XFILLER_15_49 VDD GND sg13g2_decap_8
XFILLER_13_118 VDD GND sg13g2_decap_4
XFILLER_16_92 VDD GND sg13g2_decap_8
XFILLER_8_166 VDD GND sg13g2_fill_1
XFILLER_5_136 VDD GND sg13g2_decap_8
XFILLER_4_51 VDD GND sg13g2_decap_8
X_253_ _253_/Q _213_/A _253_/D _226_/Y VDD GND sg13g2_dfrbpq_1
X_184_ _184_/Y _184_/A _184_/B _184_/C VDD GND sg13g2_nand3_1
X_236_ _236_/Y _241_/A VDD GND sg13g2_inv_1
X_167_ _174_/B _246_/Q _173_/B VDD GND sg13g2_xor2_1
XFILLER_20_28 VDD GND sg13g2_decap_8
XFILLER_1_74 VDD GND sg13g2_fill_1
XFILLER_6_19 VDD GND sg13g2_decap_8
X_219_ _219_/Y _224_/A VDD GND sg13g2_inv_1
XFILLER_15_28 VDD GND sg13g2_decap_8
XFILLER_16_127 VDD GND sg13g2_decap_4
XFILLER_15_160 VDD GND sg13g2_decap_8
XFILLER_16_71 VDD GND sg13g2_decap_8
XFILLER_8_134 VDD GND sg13g2_fill_2
XFILLER_8_123 VDD GND sg13g2_decap_8
XFILLER_4_30 VDD GND sg13g2_decap_8
XFILLER_13_83 VDD GND sg13g2_decap_8
X_252_ _252_/Q _213_/A _252_/D _225_/Y VDD GND sg13g2_dfrbpq_1
X_183_ _183_/Y _183_/A _183_/B VDD GND sg13g2_nand2_1
XFILLER_9_19 VDD GND sg13g2_decap_8
X_235_ _235_/Y _241_/A VDD GND sg13g2_inv_1
X_166_ _170_/B _254_/Q _166_/B VDD GND sg13g2_nand2_1
XFILLER_10_95 VDD GND sg13g2_decap_8
X_218_ _218_/Y _224_/A VDD GND sg13g2_inv_1
X_149_ _157_/B _253_/Q _149_/B VDD GND sg13g2_xnor2_1
XFILLER_19_158 VDD GND sg13g2_decap_8
XFILLER_11_8 VDD GND sg13g2_fill_1
XFILLER_16_106 VDD GND sg13g2_decap_8
XFILLER_16_117 VDD GND sg13g2_fill_2
XFILLER_7_96 VDD GND sg13g2_decap_4
XFILLER_7_52 VDD GND sg13g2_fill_2
XFILLER_5_116 VDD GND sg13g2_fill_2
XFILLER_4_86 VDD GND sg13g2_decap_8
XFILLER_13_62 VDD GND sg13g2_decap_8
X_251_ _251_/Q _213_/A _251_/D _224_/Y VDD GND sg13g2_dfrbpq_1
X_182_ _256_/D _183_/B _182_/B VDD GND sg13g2_xnor2_1
XFILLER_8_0 VDD GND sg13g2_decap_8
XFILLER_1_7 VDD GND sg13g2_decap_4
X_234_ _234_/Y _241_/A VDD GND sg13g2_inv_1
X_165_ _170_/A _245_/Q _173_/B VDD GND sg13g2_nand2_1
XFILLER_1_87 VDD GND sg13g2_decap_8
XFILLER_10_52 VDD GND sg13g2_decap_8
X_217_ _217_/Y _224_/A VDD GND sg13g2_inv_1
X_148_ _149_/B _244_/Q _195_/B VDD GND sg13g2_xor2_1
XFILLER_19_83 VDD GND sg13g2_fill_2
XFILLER_19_137 VDD GND sg13g2_decap_8
XFILLER_12_165 VDD GND sg13g2_fill_2
XFILLER_4_65 VDD GND sg13g2_decap_8
X_250_ _250_/Q _250_/CLK _250_/D _223_/Y VDD GND sg13g2_dfrbpq_1
X_181_ _182_/B _180_/X _183_/A _171_/A VDD GND sg13g2_a21oi_1
XFILLER_1_153 VDD GND sg13g2_decap_8
X_233_ _233_/Y _239_/A VDD GND sg13g2_inv_1
X_164_ _172_/A _151_/A _160_/X _163_/X VDD GND sg13g2_a21oi_2
XFILLER_1_66 VDD GND sg13g2_decap_4
XFILLER_1_11 VDD GND sg13g2_fill_1
XFILLER_19_62 VDD GND sg13g2_decap_8
XFILLER_19_116 VDD GND sg13g2_decap_8
X_216_ _216_/Y _224_/A VDD GND sg13g2_inv_1
X_147_ _157_/A _252_/Q _140_/B _146_/X VDD GND sg13g2_a21oi_1
XFILLER_7_87 VDD GND sg13g2_decap_4
XFILLER_16_0 VDD GND sg13g2_decap_8
XFILLER_16_85 VDD GND sg13g2_decap_8
XFILLER_5_129 VDD GND sg13g2_decap_8
XFILLER_4_44 VDD GND sg13g2_decap_8
XFILLER_4_162 VDD GND sg13g2_decap_4
XFILLER_13_97 VDD GND sg13g2_decap_8
Xfanout10 _241_/A _239_/A VDD GND sg13g2_buf_1
X_180_ _180_/X _151_/A _160_/X _163_/X VDD GND sg13g2_a21o_1
XFILLER_1_132 VDD GND sg13g2_decap_8
X_232_ _232_/Y _232_/A VDD GND sg13g2_inv_1
X_163_ _163_/X _157_/Y _161_/Y _162_/Y VDD GND sg13g2_a21o_2
XFILLER_10_21 VDD GND sg13g2_decap_4
XFILLER_19_41 VDD GND sg13g2_decap_8
X_215_ _215_/Y _224_/A VDD GND sg13g2_inv_1
X_146_ _146_/X _243_/Q _173_/B VDD GND sg13g2_and2_1
XFILLER_15_153 VDD GND sg13g2_decap_8
X_129_ _262_/D _262_/Q _261_/Q _128_/Y VDD GND sg13g2_a21oi_1
XFILLER_8_116 VDD GND sg13g2_decap_8
XFILLER_4_23 VDD GND sg13g2_decap_8
XFILLER_4_141 VDD GND sg13g2_decap_8
Xfanout11 _239_/A input2/X VDD GND sg13g2_buf_1
XFILLER_13_76 VDD GND sg13g2_decap_8
XFILLER_1_111 VDD GND sg13g2_decap_8
X_231_ _231_/Y _232_/A VDD GND sg13g2_inv_1
X_162_ _162_/Y _162_/A _162_/B VDD GND sg13g2_nor2_1
XFILLER_1_46 VDD GND sg13g2_decap_4
XFILLER_10_66 VDD GND sg13g2_decap_8
XFILLER_10_88 VDD GND sg13g2_decap_8
Xinput1 _125_/S en VDD GND sg13g2_buf_1
X_214_ _267_/D _267_/Q VDD GND sg13g2_inv_1
X_145_ _151_/A _143_/Y _142_/B _144_/Y VDD GND sg13g2_a21o_2
XFILLER_18_162 VDD GND sg13g2_decap_4
XFILLER_15_132 VDD GND sg13g2_decap_8
X_128_ _128_/Y _262_/Q _261_/Q _127_/Y VDD GND sg13g2_o21ai_1
XFILLER_7_45 VDD GND sg13g2_decap_8
XFILLER_5_109 VDD GND sg13g2_decap_8
XFILLER_4_79 VDD GND sg13g2_decap_8
X_230_ _230_/Y _241_/A VDD GND sg13g2_inv_1
X_161_ _161_/Y _162_/A _162_/B VDD GND sg13g2_nand2_1
Xinput2 input2/X rst VDD GND sg13g2_buf_1
X_213_ _260_/D _213_/A VDD GND sg13g2_inv_1
X_144_ _144_/Y _144_/A _144_/B VDD GND sg13g2_nor2_1
XFILLER_19_76 VDD GND sg13g2_decap_8
XFILLER_18_130 VDD GND sg13g2_decap_4
XFILLER_15_111 VDD GND sg13g2_decap_8
X_127_ _127_/Y _263_/Q _262_/Q VDD GND sg13g2_nand2_1
XFILLER_16_33 VDD GND sg13g2_decap_4
XFILLER_16_99 VDD GND sg13g2_decap_8
XFILLER_14_0 VDD GND sg13g2_decap_8
XFILLER_4_58 VDD GND sg13g2_decap_8
XFILLER_4_121 VDD GND sg13g2_fill_1
XFILLER_13_34 VDD GND sg13g2_fill_2
XFILLER_13_45 VDD GND sg13g2_decap_4
XFILLER_1_146 VDD GND sg13g2_decap_8
X_160_ _160_/X _160_/A _160_/B VDD GND sg13g2_and2_1
Xinput3 input3/X sdata VDD GND sg13g2_buf_1
X_212_ _268_/D _268_/Q VDD GND sg13g2_inv_1
X_143_ _143_/Y _143_/A VDD GND sg13g2_inv_1
XFILLER_19_55 VDD GND sg13g2_decap_8
X_126_ _261_/D _263_/Q _262_/Q _261_/Q VDD GND sg13g2_a21oi_1
XFILLER_16_78 VDD GND sg13g2_decap_8
XFILLER_4_37 VDD GND sg13g2_decap_8
XFILLER_4_166 VDD GND sg13g2_fill_1
XFILLER_4_155 VDD GND sg13g2_decap_8
XFILLER_4_100 VDD GND sg13g2_decap_8
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
XFILLER_9_166 VDD GND sg13g2_fill_1
XFILLER_9_100 VDD GND sg13g2_decap_8
XFILLER_3_63 VDD GND sg13g2_decap_4
XFILLER_10_154 VDD GND sg13g2_decap_8
XFILLER_10_165 VDD GND sg13g2_fill_2
X_221_ _221_/Y _224_/A VDD GND sg13g2_inv_1
X_152_ _152_/X _244_/Q _195_/B VDD GND sg13g2_and2_1
XFILLER_5_0 VDD GND sg13g2_decap_8
XFILLER_19_8 VDD GND sg13g2_fill_1
XFILLER_17_39 VDD GND sg13g2_fill_1
X_204_ _204_/X _204_/A _204_/B VDD GND sg13g2_and2_1
XFILLER_0_42 VDD GND sg13g2_decap_8
X_135_ _264_/D _266_/D _135_/B VDD GND sg13g2_and2_1
XFILLER_9_40 VDD GND sg13g2_decap_8
X_118_ _249_/D _249_/Q _248_/Q _125_/S VDD GND sg13g2_mux2_1
XFILLER_6_96 VDD GND sg13g2_fill_2
XFILLER_20_0 VDD GND sg13g2_decap_8
Xclkbuf_1_1__f_sclk _250_/CLK clkbuf_0_sclk/X VDD GND sg13g2_buf_16
XFILLER_9_7 VDD GND sg13g2_fill_2
XFILLER_15_83 VDD GND sg13g2_decap_8
XFILLER_11_19 VDD GND sg13g2_decap_8
XFILLER_13_163 VDD GND sg13g2_decap_4
XFILLER_9_145 VDD GND sg13g2_decap_8
XFILLER_3_53 VDD GND sg13g2_decap_4
X_220_ _220_/Y _224_/A VDD GND sg13g2_inv_1
X_151_ _253_/D _151_/A _160_/A VDD GND sg13g2_xor2_1
XFILLER_3_107 VDD GND sg13g2_decap_8
XFILLER_0_21 VDD GND sg13g2_decap_8
X_203_ _258_/D _204_/B _203_/B VDD GND sg13g2_xnor2_1
X_134_ _135_/B _195_/B _127_/Y _133_/Y VDD GND sg13g2_o21ai_1
XFILLER_2_162 VDD GND sg13g2_fill_1
XFILLER_2_151 VDD GND sg13g2_decap_8
XFILLER_2_140 VDD GND sg13g2_fill_1
X_117_ _250_/D _250_/Q _249_/Q _125_/S VDD GND sg13g2_mux2_1
XFILLER_18_50 VDD GND sg13g2_decap_4
XFILLER_20_84 VDD GND sg13g2_decap_8
XFILLER_17_117 VDD GND sg13g2_fill_1
Xoutput4 freq_out _213_/A VDD GND sg13g2_buf_1
XFILLER_16_161 VDD GND sg13g2_decap_4
XFILLER_13_142 VDD GND sg13g2_decap_8
XFILLER_9_135 VDD GND sg13g2_decap_8
XFILLER_3_98 VDD GND sg13g2_fill_1
XFILLER_10_123 VDD GND sg13g2_decap_8
XFILLER_10_134 VDD GND sg13g2_decap_4
XFILLER_12_63 VDD GND sg13g2_decap_8
X_150_ _160_/A _157_/A _157_/B VDD GND sg13g2_xor2_1
XFILLER_6_138 VDD GND sg13g2_decap_8
X_202_ _203_/B _194_/A _204_/A _193_/A VDD GND sg13g2_a21oi_1
X_133_ _133_/Y _261_/Q _266_/Q _133_/C VDD GND sg13g2_nor3_1
XFILLER_0_99 VDD GND sg13g2_decap_8
XFILLER_9_86 VDD GND sg13g2_decap_8
Xfanout5 _173_/B _195_/B VDD GND sg13g2_buf_1
XFILLER_6_54 VDD GND sg13g2_decap_8
XFILLER_20_63 VDD GND sg13g2_decap_8
XFILLER_15_63 VDD GND sg13g2_fill_1
XFILLER_9_114 VDD GND sg13g2_decap_8
XFILLER_10_102 VDD GND sg13g2_decap_8
XFILLER_6_106 VDD GND sg13g2_decap_8
XFILLER_12_53 VDD GND sg13g2_fill_1
XFILLER_5_150 VDD GND sg13g2_decap_8
X_201_ _204_/B _201_/A _200_/Y VDD GND sg13g2_nor2b_1
X_132_ _133_/C _263_/Q _262_/Q VDD GND sg13g2_nor2_1
XFILLER_3_0 VDD GND sg13g2_decap_8
XFILLER_0_56 VDD GND sg13g2_decap_8
XFILLER_0_78 VDD GND sg13g2_decap_8
Xfanout6 _195_/B _259_/Q VDD GND sg13g2_buf_1
XFILLER_20_97 VDD GND sg13g2_decap_8
XFILLER_20_42 VDD GND sg13g2_decap_8
XFILLER_6_77 VDD GND sg13g2_decap_8
XFILLER_6_33 VDD GND sg13g2_decap_8
XFILLER_15_42 VDD GND sg13g2_decap_8
XFILLER_15_97 VDD GND sg13g2_decap_8
XFILLER_17_108 VDD GND sg13g2_decap_4
.ends




************************************************************************
* Library Name: sg13g2_stdcell
* Cell Name:    sg13g2_a21o_1
* View Name:    schematic
************************************************************************

.SUBCKT sg13g2_a21o_1 X A1 A2 B1 VDD VSS
*.PININFO A1:I A2:I B1:I X:O VDD:B VSS:B
MN0 net1 A1 net2 VSS sg13_lv_nmos m=1 w=640.00n l=130.00n ng=1
MN1 net2 A2 VSS VSS sg13_lv_nmos m=1 w=640.00n l=130.00n ng=1
MN2 net1 B1 VSS VSS sg13_lv_nmos m=1 w=640.00n l=130.00n ng=1
MN3 X net1 VSS VSS sg13_lv_nmos m=1 w=740.00n l=130.00n ng=1
MP2 net1 B1 net3 VDD sg13_lv_pmos m=1 w=1.000u l=130.00n ng=1
MP0 net3 A1 VDD VDD sg13_lv_pmos m=1 w=1.000u l=130.00n ng=1
MP1 net3 A2 VDD VDD sg13_lv_pmos m=1 w=1.000u l=130.00n ng=1
MP3 X net1 VDD VDD sg13_lv_pmos m=1 w=1.12u l=130.00n ng=1
.ENDS

************************************************************************
* Library Name: sg13g2_stdcell
* Cell Name:    sg13g2_a21o_2
* View Name:    schematic
************************************************************************

.SUBCKT sg13g2_a21o_2 X A1 A2 B1 VDD VSS
*.PININFO A1:I A2:I B1:I X:O VDD:B VSS:B
MN0 net1 A1 net2 VSS sg13_lv_nmos m=1 w=740.00n l=130.00n ng=1
MN1 net2 A2 VSS VSS sg13_lv_nmos m=1 w=740.00n l=130.00n ng=1
MN2 net1 B1 VSS VSS sg13_lv_nmos m=1 w=740.00n l=130.00n ng=1
MN3 X net1 VSS VSS sg13_lv_nmos m=1 w=1.48u l=130.00n ng=2
MP2 net1 B1 net3 VDD sg13_lv_pmos m=1 w=1.000u l=130.00n ng=1
MP0 net3 A1 VDD VDD sg13_lv_pmos m=1 w=1.000u l=130.00n ng=1
MP1 net3 A2 VDD VDD sg13_lv_pmos m=1 w=1.000u l=130.00n ng=1
MP3 X net1 VDD VDD sg13_lv_pmos m=1 w=2.24u l=130.00n ng=2
.ENDS

************************************************************************
* Library Name: sg13g2_stdcell
* Cell Name:    sg13g2_a21oi_1
* View Name:    schematic
************************************************************************

.SUBCKT sg13g2_a21oi_1 Y A1 A2 B1 VDD VSS
*.PININFO A1:I A2:I B1:I Y:O VDD:B VSS:B
MN0 Y B1 VSS VSS sg13_lv_nmos m=1 w=740.00n l=130.00n ng=1
MN2 net1 A2 VSS VSS sg13_lv_nmos m=1 w=740.00n l=130.00n ng=1
MN1 Y A1 net1 VSS sg13_lv_nmos m=1 w=740.00n l=130.00n ng=1
MP2 Y B1 net2 VDD sg13_lv_pmos m=1 w=1.12u l=130.00n ng=1
MP1 net2 A2 VDD VDD sg13_lv_pmos m=1 w=1.12u l=130.00n ng=1
MP0 net2 A1 VDD VDD sg13_lv_pmos m=1 w=1.12u l=130.00n ng=1
.ENDS

************************************************************************
* Library Name: sg13g2_stdcell
* Cell Name:    sg13g2_a21oi_2
* View Name:    schematic
************************************************************************

.SUBCKT sg13g2_a21oi_2 Y A1 A2 B1 VDD VSS
*.PININFO A1:I A2:I B1:I Y:O VDD:B VSS:B
MN0 Y B1 VSS VSS sg13_lv_nmos m=1 w=1.48u l=130.00n ng=2
MN2 net2 A2 VSS VSS sg13_lv_nmos m=1 w=1.48u l=130.00n ng=2
MN1 Y A1 net2 VSS sg13_lv_nmos m=1 w=1.48u l=130.00n ng=2
MP2 Y B1 net1 VDD sg13_lv_pmos m=1 w=2.24u l=130.00n ng=2
MP1 net1 A2 VDD VDD sg13_lv_pmos m=1 w=2.24u l=130.00n ng=2
MP0 net1 A1 VDD VDD sg13_lv_pmos m=1 w=2.24u l=130.00n ng=2
.ENDS

************************************************************************
* Library Name: sg13g2_stdcell
* Cell Name:    sg13g2_a221oi_1
* View Name:    schematic
************************************************************************

.SUBCKT sg13g2_a221oi_1 Y A1 A2 B1 B2 C1 VDD VSS
*.PININFO A1:I A2:I B1:I B2:I C1:I Y:O VDD:B VSS:B
MP2 Y C1 net3 VDD sg13_lv_pmos m=1 w=1.12u l=130.00n ng=1
MP4 net3 B2 net1 VDD sg13_lv_pmos m=1 w=1.12u l=130.00n ng=1
MP1 net3 B1 net1 VDD sg13_lv_pmos m=1 w=1.12u l=130.00n ng=1
MP3 net1 A2 VDD VDD sg13_lv_pmos m=1 w=1.12u l=130.00n ng=1
MP0 net1 A1 VDD VDD sg13_lv_pmos m=1 w=1.12u l=130.00n ng=1
MN4 Y C1 VSS VSS sg13_lv_nmos m=1 w=740.00n l=130.00n ng=1
MN3 net4 B2 VSS VSS sg13_lv_nmos m=1 w=740.00n l=130.00n ng=1
MN2 Y B1 net4 VSS sg13_lv_nmos m=1 w=740.00n l=130.00n ng=1
MN1 net2 A2 VSS VSS sg13_lv_nmos m=1 w=740.00n l=130.00n ng=1
MN0 Y A1 net2 VSS sg13_lv_nmos m=1 w=740.00n l=130.00n ng=1
.ENDS

************************************************************************
* Library Name: sg13g2_stdcell
* Cell Name:    sg13g2_and2_1
* View Name:    schematic
************************************************************************

.SUBCKT sg13g2_and2_1 X A B VDD VSS
*.PININFO A:I B:I X:O VDD:B VSS:B
MN0 net4 A net2 VSS sg13_lv_nmos m=1 w=640.00n l=130.00n ng=1
MN2 X net4 VSS VSS sg13_lv_nmos m=1 w=740.00n l=130.00n ng=1
MN1 net2 B VSS VSS sg13_lv_nmos m=1 w=640.00n l=130.00n ng=1
MP0 net4 B VDD VDD sg13_lv_pmos m=1 w=840.00n l=130.00n ng=1
MP2 X net4 VDD VDD sg13_lv_pmos m=1 w=1.12u l=130.00n ng=1
MP1 net4 A VDD VDD sg13_lv_pmos m=1 w=840.00n l=130.00n ng=1
.ENDS

************************************************************************
* Library Name: sg13g2_stdcell
* Cell Name:    sg13g2_and2_2
* View Name:    schematic
************************************************************************

.SUBCKT sg13g2_and2_2 X A B VDD VSS
*.PININFO A:I B:I X:O VDD:B VSS:B
MN0 net1 A net2 VSS sg13_lv_nmos m=1 w=640.00n l=130.00n ng=1
MN2 X net1 VSS VSS sg13_lv_nmos m=1 w=1.48u l=130.00n ng=2
MN1 net2 B VSS VSS sg13_lv_nmos m=1 w=640.00n l=130.00n ng=1
MP0 net1 B VDD VDD sg13_lv_pmos m=1 w=840.00n l=130.00n ng=1
MP2 X net1 VDD VDD sg13_lv_pmos m=1 w=2.24u l=130.00n ng=2
MP1 net1 A VDD VDD sg13_lv_pmos m=1 w=840.00n l=130.00n ng=1
.ENDS

************************************************************************
* Library Name: sg13g2_stdcell
* Cell Name:    sg13g2_and3_1
* View Name:    schematic
************************************************************************

.SUBCKT sg13g2_and3_1 X A B C VDD VSS
*.PININFO A:I B:I C:I X:O VDD:B VSS:B
MN2 net3 C VSS VSS sg13_lv_nmos m=1 w=640.00n l=130.00n ng=1
MN3 X net2 VSS VSS sg13_lv_nmos m=1 w=740.00n l=130.00n ng=1
MN0 net2 A net1 VSS sg13_lv_nmos m=1 w=640.00n l=130.00n ng=1
MN1 net1 B net3 VSS sg13_lv_nmos m=1 w=640.00n l=130.00n ng=1
MP3 X net2 VDD VDD sg13_lv_pmos m=1 w=1.12u l=130.00n ng=1
MP1 net2 B VDD VDD sg13_lv_pmos m=1 w=840.00n l=130.00n ng=1
MP2 net2 A VDD VDD sg13_lv_pmos m=1 w=840.00n l=130.00n ng=1
MP0 net2 C VDD VDD sg13_lv_pmos m=1 w=840.00n l=130.00n ng=1
.ENDS

************************************************************************
* Library Name: sg13g2_stdcell
* Cell Name:    sg13g2_and3_2
* View Name:    schematic
************************************************************************
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
