Manimohan05/SG13G2_2.4GHz_LC_VCO_FPLL/simulations/4nH_INDUCTOR.spice

.subckt 4nH_INDUCTOR 1 2
Vam1 1 n2 dc 0
Rport1 n2 0 50
Vam2 2 n4 dc 0
Rport2 n4 0 50

Fi1 0 ni1 Vam1 50
Gi1 0 ni1 1 0 1
Rt1 ni1 0 1
Fi2 0 ni2 Vam2 50
Gi2 0 ni2 2 0 1
Rt2 ni2 0 1

Ca1 ns1 0 1e-012
Ra1 ns1 0 131834.068078
Ca2 ns2 0 1e-012
Ra2 ns2 0 735.819681122
Ca3 ns3 0 1e-012
Ca4 ns4 0 1e-012
Ra3 ns3 0 186.359484923
Ra4 ns4 0 186.359484923
Ga3 ns3 0 ns4 0 -0.00231880636624
Ga4 ns4 0 ns3 0 0.00231880636624
Ca5 ns5 0 1e-012
Ra5 ns5 0 141.613068254
Ca6 ns6 0 1e-012
Ra6 ns6 0 29.4273648628
Ca7 ns7 0 1e-012
Ca8 ns8 0 1e-012
Ra7 ns7 0 8.35389829092
Ra8 ns8 0 8.35389829092
Ga7 ns7 0 ns8 0 -0.17749287689
Ga8 ns8 0 ns7 0 0.17749287689
Ca9 ns9 0 1e-012
Ra9 ns9 0 3.07433189927
Ca10 ns10 0 1e-012
Ra10 ns10 0 131834.068078
Ca11 ns11 0 1e-012
Ra11 ns11 0 735.819681122
Ca12 ns12 0 1e-012
Ca13 ns13 0 1e-012
Ra12 ns12 0 186.359484923
Ra13 ns13 0 186.359484923
Ga12 ns12 0 ns13 0 -0.00231880636624
Ga13 ns13 0 ns12 0 0.00231880636624
Ca14 ns14 0 1e-012
Ra14 ns14 0 141.613068254
Ca15 ns15 0 1e-012
Ra15 ns15 0 29.4273648628
Ca16 ns16 0 1e-012
Ca17 ns17 0 1e-012
Ra16 ns16 0 8.35389829092
Ra17 ns17 0 8.35389829092
Ga16 ns16 0 ns17 0 -0.17749287689
Ga17 ns17 0 ns16 0 0.17749287689
Ca18 ns18 0 1e-012
Ra18 ns18 0 3.07433189927

Gb1_1 ns1 0 ni1 0 7.58529274395e-006
Gb2_1 ns2 0 ni1 0 0.00135902861211
Gb3_1 ns3 0 ni1 0 0.00636800260357
Gb5_1 ns5 0 ni1 0 0.00706149518775
Gb6_1 ns6 0 ni1 0 0.0339819757788
Gb7_1 ns7 0 ni1 0 0.25822394612
Gb9_1 ns9 0 ni1 0 0.32527392382
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
Gc2_13 0 n4 ns13 0 -2.42792134581e-005
Gc2_14 0 n4 ns14 0 0.000591575130422
Gc2_15 0 n4 ns15 0 0.0316267338258
Gc2_16 0 n4 ns16 0 0.0354660552526
Gc2_17 0 n4 ns17 0 -0.00282616402358
Gc2_18 0 n4 ns18 0 -0.0703910464608
Gd2_1 0 n4 ni1 0 0.00193597863841
Gd2_2 0 n4 ni2 0 -0.0115657051542
.ends
