Manimohan05/SG13G2_2.4GHz_LC_VCO_FPLL/spice/DSM_N_FREQ_DIV.spice

* NGSPICE file created from DSM_N_FREQ_DIV.ext - technology: ihp-sg13g2

.subckt DSM_N_FREQ_DIV freq_in rst sclk sdata en freq_out VDD GND
XFILLER_13_111 VDD GND sg13g2_decap_8
XFILLER_9_159 VDD GND sg13g2_decap_8
XFILLER_3_67 VDD GND sg13g2_fill_1
XFILLER_10_147 VDD GND sg13g2_decap_8
X_200_ _200_/Y _200_/A _200_/B _200_/C VDD GND sg13g2_nand3_1
X_131_ _263_/D _263_/Q _262_/Q _130_/Y VDD GND sg13g2_a21oi_1
XFILLER_0_35 VDD GND sg13g2_decap_8
XFILLER_9_33 VDD GND sg13g2_decap_8
XFILLER_18_64 VDD GND sg13g2_fill_1
Xfanout7 _213_/A _260_/Q VDD GND sg13g2_buf_1
XFILLER_20_21 VDD GND sg13g2_decap_8
XFILLER_6_89 VDD GND sg13g2_decap_8
XFILLER_15_21 VDD GND sg13g2_decap_8
XFILLER_15_76 VDD GND sg13g2_decap_8
XFILLER_13_156 VDD GND sg13g2_decap_8
XFILLER_3_57 VDD GND sg13g2_fill_1
XFILLER_3_46 VDD GND sg13g2_decap_8
X_130_ _130_/Y _262_/Q _261_/Q _263_/Q VDD GND sg13g2_a21oi_1
XFILLER_0_14 VDD GND sg13g2_decap_8
X_259_ _259_/Q _260_/Q _259_/D _232_/Y VDD GND sg13g2_dfrbpq_1
XFILLER_9_67 VDD GND sg13g2_fill_2
XFILLER_2_144 VDD GND sg13g2_decap_8
XFILLER_18_54 VDD GND sg13g2_fill_2
XFILLER_15_7 VDD GND sg13g2_decap_8
Xfanout8 _224_/A input2/X VDD GND sg13g2_buf_1
XFILLER_20_77 VDD GND sg13g2_decap_8
XFILLER_6_68 VDD GND sg13g2_fill_1
XFILLER_19_151 VDD GND sg13g2_decap_8
XFILLER_16_165 VDD GND sg13g2_fill_2
XFILLER_9_128 VDD GND sg13g2_decap_8
XFILLER_10_116 VDD GND sg13g2_decap_8
XFILLER_10_138 VDD GND sg13g2_fill_1
XFILLER_5_164 VDD GND sg13g2_fill_2
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
XFILLER_11_8 VDD GND sg13g2_fill_1
XFILLER_16_106 VDD GND sg13g2_decap_8
XFILLER_16_117 VDD GND sg13g2_fill_2
XFILLER_7_96 VDD GND sg13g2_decap_4
XFILLER_7_52 VDD GND sg13g2_fill_2
XFILLER_5_116 VDD GND sg13g2_fill_2
XFILLER_4_86 VDD GND sg13g2_decap_8
XFILLER_13_62 VDD GND sg13g2_decap_8
X_251_ _251_/Q _213_/A _251_/D _224_/Y VDD GND sg13g2_dfrbpq_1
X_182_ _256_/D _183_/B _182_/B VDD GND sg13g2_xnor2_1
XFILLER_8_0 VDD GND sg13g2_decap_8
XFILLER_1_7 VDD GND sg13g2_decap_4
X_234_ _234_/Y _241_/A VDD GND sg13g2_inv_1
X_165_ _170_/A _245_/Q _173_/B VDD GND sg13g2_nand2_1
XFILLER_1_87 VDD GND sg13g2_decap_8
XFILLER_10_52 VDD GND sg13g2_decap_8
X_217_ _217_/Y _224_/A VDD GND sg13g2_inv_1
X_148_ _149_/B _244_/Q _195_/B VDD GND sg13g2_xor2_1
XFILLER_19_83 VDD GND sg13g2_fill_2
XFILLER_19_137 VDD GND sg13g2_decap_8
XFILLER_12_165 VDD GND sg13g2_fill_2
XFILLER_4_65 VDD GND sg13g2_decap_8
X_250_ _250_/Q _250_/CLK _250_/D _223_/Y VDD GND sg13g2_dfrbpq_1
X_181_ _182_/B _180_/X _183_/A _171_/A VDD GND sg13g2_a21oi_1
XFILLER_1_153 VDD GND sg13g2_decap_8
X_233_ _233_/Y _239_/A VDD GND sg13g2_inv_1
X_164_ _172_/A _151_/A _160_/X _163_/X VDD GND sg13g2_a21oi_2
XFILLER_1_66 VDD GND sg13g2_decap_4
XFILLER_1_11 VDD GND sg13g2_fill_1
XFILLER_19_62 VDD GND sg13g2_decap_8
XFILLER_19_116 VDD GND sg13g2_decap_8
X_216_ _216_/Y _224_/A VDD GND sg13g2_inv_1
X_147_ _157_/A _252_/Q _140_/B _146_/X VDD GND sg13g2_a21oi_1
XFILLER_7_87 VDD GND sg13g2_decap_4
XFILLER_16_0 VDD GND sg13g2_decap_8
XFILLER_16_85 VDD GND sg13g2_decap_8
XFILLER_5_129 VDD GND sg13g2_decap_8
XFILLER_4_44 VDD GND sg13g2_decap_8
XFILLER_4_162 VDD GND sg13g2_decap_4
XFILLER_13_97 VDD GND sg13g2_decap_8
Xfanout10 _241_/A _239_/A VDD GND sg13g2_buf_1
X_180_ _180_/X _151_/A _160_/X _163_/X VDD GND sg13g2_a21o_1
XFILLER_1_132 VDD GND sg13g2_decap_8
X_232_ _232_/Y _232_/A VDD GND sg13g2_inv_1
X_163_ _163_/X _157_/Y _161_/Y _162_/Y VDD GND sg13g2_a21o_2
XFILLER_10_21 VDD GND sg13g2_decap_4
XFILLER_19_41 VDD GND sg13g2_decap_8
X_215_ _215_/Y _224_/A VDD GND sg13g2_inv_1
X_146_ _146_/X _243_/Q _173_/B VDD GND sg13g2_and2_1
XFILLER_15_153 VDD GND sg13g2_decap_8
X_129_ _262_/D _262_/Q _261_/Q _128_/Y VDD GND sg13g2_a21oi_1
XFILLER_8_116 VDD GND sg13g2_decap_8
XFILLER_4_23 VDD GND sg13g2_decap_8
XFILLER_4_141 VDD GND sg13g2_decap_8
Xfanout11 _239_/A input2/X VDD GND sg13g2_buf_1
XFILLER_13_76 VDD GND sg13g2_decap_8
XFILLER_1_111 VDD GND sg13g2_decap_8
X_231_ _231_/Y _232_/A VDD GND sg13g2_inv_1
X_162_ _162_/Y _162_/A _162_/B VDD GND sg13g2_nor2_1
XFILLER_1_46 VDD GND sg13g2_decap_4
XFILLER_10_66 VDD GND sg13g2_decap_8
XFILLER_10_88 VDD GND sg13g2_decap_8
Xinput1 _125_/S en VDD GND sg13g2_buf_1
X_214_ _267_/D _267_/Q VDD GND sg13g2_inv_1
X_145_ _151_/A _143_/Y _142_/B _144_/Y VDD GND sg13g2_a21o_2
XFILLER_18_162 VDD GND sg13g2_decap_4
XFILLER_15_132 VDD GND sg13g2_decap_8
X_128_ _128_/Y _262_/Q _261_/Q _127_/Y VDD GND sg13g2_o21ai_1
XFILLER_7_45 VDD GND sg13g2_decap_8
XFILLER_5_109 VDD GND sg13g2_decap_8
XFILLER_4_79 VDD GND sg13g2_decap_8
X_230_ _230_/Y _241_/A VDD GND sg13g2_inv_1
X_161_ _161_/Y _162_/A _162_/B VDD GND sg13g2_nand2_1
Xinput2 input2/X rst VDD GND sg13g2_buf_1
X_213_ _260_/D _213_/A VDD GND sg13g2_inv_1
X_144_ _144_/Y _144_/A _144_/B VDD GND sg13g2_nor2_1
XFILLER_19_76 VDD GND sg13g2_decap_8
XFILLER_18_130 VDD GND sg13g2_decap_4
XFILLER_15_111 VDD GND sg13g2_decap_8
X_127_ _127_/Y _263_/Q _262_/Q VDD GND sg13g2_nand2_1
XFILLER_16_33 VDD GND sg13g2_decap_4
XFILLER_16_99 VDD GND sg13g2_decap_8
XFILLER_14_0 VDD GND sg13g2_decap_8
XFILLER_4_58 VDD GND sg13g2_decap_8
XFILLER_4_121 VDD GND sg13g2_fill_1
XFILLER_13_34 VDD GND sg13g2_fill_2
XFILLER_13_45 VDD GND sg13g2_decap_4
XFILLER_1_146 VDD GND sg13g2_decap_8
X_160_ _160_/X _160_/A _160_/B VDD GND sg13g2_and2_1
Xinput3 input3/X sdata VDD GND sg13g2_buf_1
X_212_ _268_/D _268_/Q VDD GND sg13g2_inv_1
X_143_ _143_/Y _143_/A VDD GND sg13g2_inv_1
XFILLER_19_55 VDD GND sg13g2_decap_8
X_126_ _261_/D _263_/Q _262_/Q _261_/Q VDD GND sg13g2_a21oi_1
XFILLER_16_78 VDD GND sg13g2_decap_8
XFILLER_4_37 VDD GND sg13g2_decap_8
XFILLER_4_166 VDD GND sg13g2_fill_1
XFILLER_4_155 VDD GND sg13g2_decap_8
XFILLER_4_100 VDD GND sg13g2_decap_8
XFILLER_1_125 VDD GND sg13g2_decap_8
XFILLER_10_14 VDD GND sg13g2_decap_8
XFILLER_10_25 VDD GND sg13g2_fill_2
X_211_ _265_/D _264_/Q VDD GND sg13g2_inv_1
X_142_ _252_/D _143_/A _142_/B VDD GND sg13g2_xnor2_1
XFILLER_4_0 VDD GND sg13g2_decap_8
XFILLER_15_146 VDD GND sg13g2_decap_8
X_125_ _242_/D _242_/Q input3/X _125_/S VDD GND sg13g2_mux2_1
XFILLER_7_37 VDD GND sg13g2_decap_4
XFILLER_20_160 VDD GND sg13g2_decap_8
XFILLER_7_131 VDD GND sg13g2_decap_4
XFILLER_4_134 VDD GND sg13g2_decap_8
XFILLER_13_36 VDD GND sg13g2_fill_1
XFILLER_13_69 VDD GND sg13g2_decap_8
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
XFILLER_19_4 VDD GND sg13g2_decap_4
X_208_ _209_/B _250_/Q _208_/B VDD GND sg13g2_xor2_1
X_139_ _140_/B _243_/Q _173_/B VDD GND sg13g2_xor2_1
XFILLER_0_127 VDD GND sg13g2_decap_8
XFILLER_14_47 VDD GND sg13g2_fill_2
XFILLER_14_58 VDD GND sg13g2_fill_2
XFILLER_17_112 VDD GND sg13g2_fill_2
XFILLER_15_90 VDD GND sg13g2_decap_8
XFILLER_11_26 VDD GND sg13g2_decap_8
XFILLER_14_148 VDD GND sg13g2_decap_8
X_241_ _241_/Y _241_/A VDD GND sg13g2_inv_1
X_172_ _255_/D _172_/A _183_/A VDD GND sg13g2_xnor2_1
XFILLER_9_152 VDD GND sg13g2_decap_8
XFILLER_7_0 VDD GND sg13g2_decap_8
XFILLER_20_118 VDD GND sg13g2_decap_8
XFILLER_0_7 VDD GND sg13g2_decap_8
X_224_ _224_/Y _224_/A VDD GND sg13g2_inv_1
X_155_ _162_/B _254_/Q _166_/B VDD GND sg13g2_xnor2_1
XFILLER_6_166 VDD GND sg13g2_fill_1
XFILLER_3_114 VDD GND sg13g2_fill_1
X_207_ _208_/B _258_/Q _198_/B _206_/Y VDD GND sg13g2_a21oi_1
X_138_ _144_/A _173_/B _251_/Q VDD GND sg13g2_nor2_1
XFILLER_0_106 VDD GND sg13g2_decap_8
XFILLER_20_91 VDD GND sg13g2_fill_2
XFILLER_14_127 VDD GND sg13g2_decap_8
X_240_ _240_/Y _241_/A VDD GND sg13g2_inv_1
X_171_ _183_/A _171_/A _170_/Y VDD GND sg13g2_nor2b_1
X_223_ _223_/Y _232_/A VDD GND sg13g2_inv_1
XFILLER_8_39 VDD GND sg13g2_fill_1
XFILLER_12_70 VDD GND sg13g2_decap_8
X_154_ _166_/B _245_/Q _173_/B VDD GND sg13g2_xor2_1
XFILLER_6_145 VDD GND sg13g2_decap_8
X_206_ _206_/Y _259_/Q _249_/Q VDD GND sg13g2_nor2b_1
X_137_ _143_/A _210_/B _242_/Q VDD GND sg13g2_nand2b_1
XFILLER_9_93 VDD GND sg13g2_decap_8
XFILLER_15_0 VDD GND sg13g2_decap_8
XFILLER_14_49 VDD GND sg13g2_fill_1
XFILLER_20_70 VDD GND sg13g2_decap_8
XFILLER_6_61 VDD GND sg13g2_decap_8
XFILLER_17_158 VDD GND sg13g2_decap_8
X_170_ _170_/Y _170_/A _170_/B _170_/C VDD GND sg13g2_nand3_1
XFILLER_9_121 VDD GND sg13g2_decap_8
XFILLER_3_84 VDD GND sg13g2_decap_8
XFILLER_11_109 VDD GND sg13g2_decap_8
X_222_ _222_/Y _232_/A VDD GND sg13g2_inv_1
X_153_ _162_/A _253_/Q _149_/B _152_/X VDD GND sg13g2_a21oi_1
XFILLER_6_157 VDD GND sg13g2_decap_8
XFILLER_6_113 VDD GND sg13g2_fill_1
X_205_ _209_/A _193_/A _200_/Y _204_/X _194_/A _201_/A VDD GND sg13g2_a221oi_1
X_136_ _210_/B _173_/B _251_/Q VDD GND sg13g2_xor2_1
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
