Manimohan05/SG13G2_2.4GHz_LC_VCO_FPLL/xschem/dsm/src/runs/RUN_2026-03-04_15-08-00/final/nl/dsm_and_freq_divider.nl.v

module dsm_and_freq_divider (en,
    freq_in,
    freq_out,
    rst,
    sclk,
    sdata);
 input en;
 input freq_in;
 output freq_out;
 input rst;
 input sclk;
 input sdata;

 wire _000_;
 wire _001_;
 wire _002_;
 wire _003_;
 wire _004_;
 wire _005_;
 wire _006_;
 wire _007_;
 wire _008_;
 wire _009_;
 wire _010_;
 wire _011_;
 wire _012_;
 wire _013_;
 wire _014_;
 wire _015_;
 wire _016_;
 wire _017_;
 wire _018_;
 wire _019_;
 wire _020_;
 wire _021_;
 wire _022_;
 wire _023_;
 wire _024_;
 wire _025_;
 wire _026_;
 wire _027_;
 wire _028_;
 wire _029_;
 wire _030_;
 wire _031_;
 wire _032_;
 wire _033_;
 wire _034_;
 wire _035_;
 wire _036_;
 wire _037_;
 wire _038_;
 wire _039_;
 wire _040_;
 wire _041_;
 wire _042_;
 wire _043_;
 wire _044_;
 wire _045_;
 wire _046_;
 wire _047_;
 wire _048_;
 wire _049_;
 wire _050_;
 wire _051_;
 wire _052_;
 wire _053_;
 wire _054_;
 wire _055_;
 wire _056_;
 wire _057_;
 wire _058_;
 wire _059_;
 wire _060_;
 wire _061_;
 wire _062_;
 wire _063_;
 wire _064_;
 wire _065_;
 wire _066_;
 wire _067_;
 wire _068_;
 wire _069_;
 wire _070_;
 wire _071_;
 wire _072_;
 wire _073_;
 wire _074_;
 wire _075_;
 wire _076_;
 wire _077_;
 wire _078_;
 wire _079_;
 wire _080_;
 wire _081_;
 wire _082_;
 wire _083_;
 wire _084_;
 wire _085_;
 wire _086_;
 wire _087_;
 wire _088_;
 wire _089_;
 wire _090_;
 wire _091_;
 wire _092_;
 wire _093_;
 wire _094_;
 wire _095_;
 wire _096_;
 wire _097_;
 wire _098_;
 wire _099_;
 wire _100_;
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
 sg13g2_decap_8 FILLER_9_121 ();
 sg13g2_decap_8 FILLER_9_128 ();
 sg13g2_decap_8 FILLER_9_135 ();
 sg13g2_decap_8 FILLER_9_145 ();
 sg13g2_decap_8 FILLER_9_152 ();
 sg13g2_decap_8 FILLER_9_159 ();
 sg13g2_fill_1 FILLER_9_166 ();
 sg13g2_decap_8 FILLER_9_19 ();
 sg13g2_decap_8 FILLER_9_26 ();
 sg13g2_decap_8 FILLER_9_33 ();
 sg13g2_decap_8 FILLER_9_40 ();
 sg13g2_decap_4 FILLER_9_47 ();
 sg13g2_fill_2 FILLER_9_67 ();
 sg13g2_fill_1 FILLER_9_69 ();
 sg13g2_fill_2 FILLER_9_7 ();
 sg13g2_decap_8 FILLER_9_79 ();
 sg13g2_decap_8 FILLER_9_86 ();
 sg13g2_decap_8 FILLER_9_93 ();
 sg13g2_mux2_1 _117_ (.A0(\data_word[8] ),
    .A1(\data_word[7] ),
    .S(net1),
    .X(_044_));
 sg13g2_mux2_1 _118_ (.A0(\data_word[7] ),
    .A1(\data_word[6] ),
    .S(net1),
    .X(_043_));
 sg13g2_mux2_1 _119_ (.A0(\data_word[6] ),
    .A1(\data_word[5] ),
    .S(net1),
    .X(_042_));
 sg13g2_mux2_1 _120_ (.A0(\data_word[5] ),
    .A1(\data_word[4] ),
    .S(net1),
    .X(_041_));
 sg13g2_mux2_1 _121_ (.A0(\data_word[4] ),
    .A1(\data_word[3] ),
    .S(net1),
    .X(_040_));
 sg13g2_mux2_1 _122_ (.A0(\data_word[3] ),
    .A1(\data_word[2] ),
    .S(net1),
    .X(_039_));
 sg13g2_mux2_1 _123_ (.A0(\data_word[2] ),
    .A1(\data_word[1] ),
    .S(net1),
    .X(_038_));
 sg13g2_mux2_1 _124_ (.A0(\data_word[1] ),
    .A1(\data_word[0] ),
    .S(net1),
    .X(_037_));
 sg13g2_mux2_1 _125_ (.A0(\data_word[0] ),
    .A1(net3),
    .S(net1),
    .X(_036_));
 sg13g2_a21oi_1 _126_ (.A1(\uut.d ),
    .A2(\uut.c ),
    .Y(\uut.mod7.jk1.d_in ),
    .B1(\uut.b ));
 sg13g2_nand2_1 _127_ (.Y(_113_),
    .A(\uut.d ),
    .B(\uut.c ));
 sg13g2_o21ai_1 _128_ (.B1(_113_),
    .Y(_114_),
    .A1(\uut.c ),
    .A2(\uut.b ));
 sg13g2_a21oi_1 _129_ (.A1(\uut.c ),
    .A2(\uut.b ),
    .Y(\uut.mod7.jk2.d_in ),
    .B1(_114_));
 sg13g2_a21oi_1 _130_ (.A1(\uut.c ),
    .A2(\uut.b ),
    .Y(_115_),
    .B1(\uut.d ));
 sg13g2_a21oi_1 _131_ (.A1(\uut.d ),
    .A2(\uut.c ),
    .Y(\uut.mod7.jk3.d_in ),
    .B1(_115_));
 sg13g2_nor2_1 _132_ (.A(\uut.d ),
    .B(\uut.c ),
    .Y(_116_));
 sg13g2_nor3_1 _133_ (.A(\uut.b ),
    .B(\uut.clk_jk ),
    .C(_116_),
    .Y(_045_));
 sg13g2_o21ai_1 _134_ (.B1(_045_),
    .Y(_046_),
    .A1(net6),
    .A2(_113_));
 sg13g2_and2_1 _135_ (.A(\uut.pre45.d3 ),
    .B(_046_),
    .X(\uut.pre45.d1 ));
 sg13g2_xor2_1 _136_ (.B(\u_dsm.integrator[0] ),
    .A(net5),
    .X(_047_));
 sg13g2_nand2b_1 _137_ (.Y(_048_),
    .B(\data_word[0] ),
    .A_N(_047_));
 sg13g2_nor2_1 _138_ (.A(net5),
    .B(\u_dsm.integrator[0] ),
    .Y(_049_));
 sg13g2_xor2_1 _139_ (.B(net5),
    .A(\data_word[1] ),
    .X(_050_));
 sg13g2_xnor2_1 _140_ (.Y(_051_),
    .A(\u_dsm.integrator[1] ),
    .B(_050_));
 sg13g2_xor2_1 _141_ (.B(_051_),
    .A(_049_),
    .X(_052_));
 sg13g2_xnor2_1 _142_ (.Y(_001_),
    .A(_048_),
    .B(_052_));
 sg13g2_inv_1 _143_ (.Y(_053_),
    .A(_048_));
 sg13g2_nor2_1 _144_ (.A(_049_),
    .B(_051_),
    .Y(_054_));
 sg13g2_a21o_2 _145_ (.A2(_052_),
    .A1(_053_),
    .B1(_054_),
    .X(_055_));
 sg13g2_and2_1 _146_ (.A(\data_word[1] ),
    .B(net5),
    .X(_056_));
 sg13g2_a21oi_1 _147_ (.A1(\u_dsm.integrator[1] ),
    .A2(_050_),
    .Y(_057_),
    .B1(_056_));
 sg13g2_xor2_1 _148_ (.B(net6),
    .A(\data_word[2] ),
    .X(_058_));
 sg13g2_xnor2_1 _149_ (.Y(_059_),
    .A(\u_dsm.integrator[2] ),
    .B(_058_));
 sg13g2_xor2_1 _150_ (.B(_059_),
    .A(_057_),
    .X(_060_));
 sg13g2_xor2_1 _151_ (.B(_060_),
    .A(_055_),
    .X(_002_));
 sg13g2_and2_1 _152_ (.A(\data_word[2] ),
    .B(net6),
    .X(_061_));
 sg13g2_a21oi_1 _153_ (.A1(\u_dsm.integrator[2] ),
    .A2(_058_),
    .Y(_062_),
    .B1(_061_));
 sg13g2_xor2_1 _154_ (.B(net5),
    .A(\data_word[3] ),
    .X(_063_));
 sg13g2_xnor2_1 _155_ (.Y(_064_),
    .A(\u_dsm.integrator[3] ),
    .B(_063_));
 sg13g2_xor2_1 _156_ (.B(_064_),
    .A(_062_),
    .X(_065_));
 sg13g2_nor2_1 _157_ (.A(_057_),
    .B(_059_),
    .Y(_066_));
 sg13g2_a21oi_1 _158_ (.A1(_055_),
    .A2(_060_),
    .Y(_067_),
    .B1(_066_));
 sg13g2_xnor2_1 _159_ (.Y(_003_),
    .A(_065_),
    .B(_067_));
 sg13g2_and2_1 _160_ (.A(_060_),
    .B(_065_),
    .X(_068_));
 sg13g2_nand2_1 _161_ (.Y(_069_),
    .A(_062_),
    .B(_064_));
 sg13g2_nor2_1 _162_ (.A(_062_),
    .B(_064_),
    .Y(_070_));
 sg13g2_a21o_2 _163_ (.A2(_069_),
    .A1(_066_),
    .B1(_070_),
    .X(_071_));
 sg13g2_a21oi_2 _164_ (.B1(_071_),
    .Y(_072_),
    .A2(_068_),
    .A1(_055_));
 sg13g2_nand2_1 _165_ (.Y(_073_),
    .A(\data_word[3] ),
    .B(net5));
 sg13g2_nand2_1 _166_ (.Y(_074_),
    .A(\u_dsm.integrator[3] ),
    .B(_063_));
 sg13g2_xor2_1 _167_ (.B(net5),
    .A(\data_word[4] ),
    .X(_075_));
 sg13g2_xnor2_1 _168_ (.Y(_076_),
    .A(\u_dsm.integrator[4] ),
    .B(_075_));
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
 sg13g2_dfrbpq_1 _264_ (.RESET_B(_031_),
    .D(\uut.pre45.d1 ),
    .Q(\uut.pre45.ff1.q ),
    .CLK(\uut.div4.dff2.q ));
 sg13g2_dfrbpq_1 _265_ (.RESET_B(_032_),
    .D(\uut.pre45.d2 ),
    .Q(\uut.pre45.d3 ),
    .CLK(\uut.div4.dff2.q ));
 sg13g2_dfrbpq_1 _266_ (.RESET_B(_033_),
    .D(\uut.pre45.d3 ),
    .Q(\uut.clk_jk ),
    .CLK(\uut.div4.dff2.q ));
 sg13g2_dfrbpq_1 _267_ (.RESET_B(_034_),
    .D(\uut.div4.dff1.d ),
    .Q(\uut.div4.dff1.q ),
    .CLK(freq_in));
 sg13g2_dfrbpq_1 _268_ (.RESET_B(_035_),
    .D(\uut.div4.dff2.d ),
    .Q(\uut.div4.dff2.q ),
    .CLK(\uut.div4.dff1.q ));
 sg13g2_buf_16 clkbuf_0_sclk (.X(clknet_0_sclk),
    .A(sclk));
 sg13g2_buf_16 clkbuf_1_0__f_sclk (.X(clknet_1_0__leaf_sclk),
    .A(clknet_0_sclk));
 sg13g2_buf_16 clkbuf_1_1__f_sclk (.X(clknet_1_1__leaf_sclk),
    .A(clknet_0_sclk));
 sg13g2_inv_1 clkload0 (.A(clknet_1_1__leaf_sclk));
 sg13g2_buf_1 fanout10 (.A(net11),
    .X(net10));
 sg13g2_buf_1 fanout11 (.A(net2),
    .X(net11));
 sg13g2_buf_1 fanout5 (.A(net6),
    .X(net5));
 sg13g2_buf_1 fanout6 (.A(\u_dsm.integrator[8] ),
    .X(net6));
 sg13g2_buf_1 fanout7 (.A(net4),
    .X(net7));
 sg13g2_buf_1 fanout8 (.A(net2),
    .X(net8));
 sg13g2_buf_1 fanout9 (.A(net2),
    .X(net9));
 sg13g2_buf_1 input1 (.A(en),
    .X(net1));
 sg13g2_buf_1 input2 (.A(rst),
    .X(net2));
 sg13g2_buf_1 input3 (.A(sdata),
    .X(net3));
 sg13g2_buf_1 output4 (.A(net7),
    .X(freq_out));
endmodule
