Manimohan05/SG13G2_2.4GHz_LC_VCO_FPLL/(commit log)

2026-05-02 Add layout files, final pre-layout simulation schematics, and SPICE files for the paper 'A 2.4 GHz LC-VCO Fractional-N Phase-Locked Loop Open-Source Design in 130-nm BiCMOS' (SMACD 2026)
    [240_248_Divider.sch, 30_31_DMD.sch, 4_5_Prescaler.sch, 4n_ind_spar.sch, All_params_5_increased.csv, All_params_5_reduced.csv, BANDGAP_REF.sch, CHARGE_PUMP.sch]
2026-07-01 Simulation plots generated
    [Freq_Div_std.sch, Frequency_Divider_tb.sch, LCVCO_DSM_tb.sch, LCVCO_temp_Fredivider_tb.sch, LC_VCO_FPLL_tb.sch, PFD_CP_pex_tb.sch, PFD_CP_tb.sch, pll_dsm_freqdivider_tb.sch]
2026-09-14 Integrated layout DRC, LVS passed - final layout updated
    Final LC_VCO_FPLL integrated layout passes both DRC and LVS.
    Design database synced with avishkaherath/LC_VCO_FPLL @ d6700f9:
    - spice/: LC_VCO, LC_VCO_FPLL, LC_VCO_NOIND, PFD_CP_LF, PHASE_FREQ_DET
    - gds/: top level plus 4nH_INDUCTOR, LC_VCO, LC_VCO_NOIND
    - xschem/: 16 schematics and symbols, placed in their existing block folders
    - new DRC/LVS runs for LC_VCO, LC_VCO_FPLL, LC_VCO_NOIND
    - new xschem/sg13g2_stdcells/ and docs/img/
    Upstream keeps schematics in a flat folder, so 10 symbol references in
    LC_VCO.sch, LC_VCO_FPLL.sch, PHASE_FREQ_DET.sch and PFD_CP_LF.sch were
    remapped to this repo's nested layout, including three hardcoded a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
    [LC_VCO.sch, LC_VCO_FPLL.sch, LC_VCO_NOIND.sch, PFD_CP_LF.sch, PHASE_FREQ_DET.sch]
2026-09-18 Add open-source inductor EM flow, archive HFSS, rewrite README
    em/: GDS -> OpenEMS -> de-embed -> vector fit -> ngspice .subckt, replacing
    the Ansys HFSS step that produced the taped-out inductor model. Depends only
    on numpy/scipy/matplotlib - includes a self-contained GDSII reader and a
    vector-fitting implementation rather than pulling in gdstk/scikit-rf.
    The generated model emits ".subckt 4nH_INDUCTOR 1 2", the same interface as
    the HFSS export, so it is a drop-in for spice/4nH_INDUCTOR.spice with no
    schematic change. S-parameters are fitted to a shared pole set and realised
    as a scattering network using only R, C, V, E, G and F elements.
    scripts/validate.py checks the whole chain agains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
    [All_params_5_increased.csv, All_params_5_reduced.csv, Final_inductor.csv, Radius_180um_220um.csv, Seperation_variations.csv, Width_variations.csv]
2026-09-18 README: add paper specs, new layout and verification images
    Restore the member list to its previous order and formatting - the ordering
    was unchanged, but the Instructor/Supervisor labels and reformatting are
    reverted. Sajitha Madugalle and Lohan Atapattu remain noted as earlier
    contributors rather than being dropped.
    Add section 3.1 with the values as published at SMACD 2026, each against its
    design target: output range 2.4-2.48 GHz, K_VCO 120 MHz/V, phase noise
    -100.8 dBc/Hz at 1 MHz, reference spur -40.2 dBc, power 12.73 mW, area
    930 x 666 um. Tuning range (>3.3 % against 8 %) and reference spur are marked
    as missing their targets. Spiral inductor table carries the paper's geometry,
    L/Q,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
2026-09-25 lvs: emit LVS-only stub and std-cell block only in LVS mode
    The 4nH_INDUCTOR black-box stub (LC_VCO.sch) and the inline std-cell
    library (LC_VCO_FPLL.sch) are needed for LVS but leaked into simulation
    netlists, where they override the full inductor model and the PDK cells.
    Gate both code blocks on the lvs_ignore Tcl variable so they are emitted
    only when netlisting for LVS.
    [LC_VCO.sch, LC_VCO_FPLL.sch]
2026-09-25 vco: fix LC_VCO_tb pin wiring and stale inductor symbol paths
    Connect VDD to the LC_VCO symbol pin and tie SUB! to GND in LC_VCO_tb,
    use repo-relative paths for the inductor symbol in the standalone and
    parametric testbenches, and regenerate LC_VCO_tb.spice.
    [LC_VCO_parametric.sch, LC_VCO_standalone_tb.sch, LC_VCO_tb.sch]
2026-09-25 pex: use this repo's pex/ in post-layout testbenches, fix DSM convergence
    Point the BGR, CP+LF, PFD and DSM post-layout testbenches at the parasitic
    netlists under pex/ instead of the old frac-n-pll-vco-unic_cass clone (the
    files are byte-identical). For the DSM testbench also include
    stimuli_test.cir, which drives rst/en/sclk/sdata, and loosen the ngspice
    options (reltol, gmin, abstol, itl4, cshunt) so the extracted netlist
    converges through the rst release instead of aborting at 53 ns. Regenerate
    the four decks.
    [tb_BGR_PEX.sch, tb_CP_LF_PEX.sch, tb_DSM_N_FREQ_DIV_PEX.sch, tb_PHASE_FREQ_DET_PEX.sch]
2026-09-25 layout: name block ports to match the schematics and expose SUB!
    Labels only, plus one substrate tap per block; no existing geometry changes.
    - LOOP_FILTER, CHARGE_PUMP_V2: rename ground pin VSS -> GND.
    - DSM_N_FREQ_DIV: rename VGND/VPWR -> GND/VDD.
    - LC_VCO: add top-level VDD, VCTRL, GND, FOUT, VBGR labels (were only in
    the child cell).
    - LOOP_FILTER, CHARGE_PUMP_V2, BANDGAP_REF: add a P+ substrate tap on a
    Metal1 pad labelled SUB!, placed clear of existing shapes, so the
    layout has the SUB! pin the schematics declare.
    Strict LVS (no --ignore_top_ports_mismatch) now matches for all five.
2026-09-25 drc: re-run LOOP_FILTER, CHARGE_PUMP, BANDGAP_REF, DSM_N_FREQ_DIV, LC_VCO
    Fresh archived runs for the five layouts changed in the previous commit,
    replacing the superseded run directories. 0 violations on all five
    (density rules disabled, as in the earlier archived runs).
    KLayout 0.30.11, IHP-Open-PDK 7e53c77.
2026-09-25 lvs: re-run LOOP_FILTER, CHARGE_PUMP, BANDGAP_REF, DSM_N_FREQ_DIV, LC_VCO
    Fresh archived runs, replacing the superseded run directories. All five
    match the schematic netlists in spice/ with strict port checking
    (no --ignore_top_ports_mismatch).
    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
2026-09-25 pex: re-extract blocks from the final layouts, use CHARGE_PUMP_V2
    Re-run kpex (Magic RC, same settings as before) on BANDGAP_REF,
    CHARGE_PUMP_V2, LOOP_FILTER and DSM_N_FREQ_DIV, replacing the superseded
    archive folders. The charge pump archive was extracted from the V1 layout
    while V2 ships in the top level; it is now pex/CHARGE_PUMP_V2__CHARGE_PUMP.
    The archived <CELL>.pex.spice are the testbench-ready netlists (subcircuit
    <CELL>_PEX, ports in testbench order). tb_CP_LF_PEX now includes the V2
    extraction and its deck is regenerated.
    kpex 0.3.10, Magic 8.3 rev 636, IHP-Open-PDK 7e53c77.
    [tb_CP_LF_PEX.sch]
2026-09-25 sim: run the DSM pre- and post-layout testbenches on the same stimulus
    The divided output has a 24.4 us period at the original 10 MHz input, which
    cannot be simulated on the extracted netlist. Both DSM testbenches now use
    the same 100 MHz input (0.5 ns edges), the same stimuli_test.cir, a 0.2 ns
    maximum step and a 2 us window, and measure the first rising/falling edge
    and the half period of freq_out. The post-layout deck uses looser ngspice
    converges through the rst and sclk edges.
    Result: first rising edge 0.6230 us pre vs 0.6234 us post, half period
    1.2400 us in both (124 input cycles).
    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
    [tb_DSM_N_FREQ_DIV_PEX.sch]
2026-09-25 docs: add paper link, final chip figure, updated DRC/LVS and comparison tables
    - Link the IEEE Xplore paper (document 11647761) under the title and in the
    Publication section.
    - Section 8: all blocks match in strict LVS (no waiver); describe the pin
    naming and the SUB! substrate tap.
    - Section 9: archived PEX now covers CHARGE_PUMP_V2 and LC_VCO_NOIND; explain
    the LC-VCO extraction without the inductor.
    - New section 9.7: block-level pre- vs post-layout comparison table.
    - Figure 11 uses the renamed PLL_Architecture.png with a matching caption;
    add the final chip figure and renumber the later figures.
2026-09-25 sim: measurements and raw output in the block testbenches
    Add .meas lines and supply-current measurements to the bandgap, PFD and
    CP+LF testbenches (pre- and post-layout) so a run from xschem reproduces
    the README comparison table. The PFD testbenches now run at nominal
    conditions (27 C, 1.2 V, one run); the Monte Carlo spread stays in the
    deck as comments. The CP+LF transient write names its signals because the
    stale tb_CP.save include breaks a bare write. Regenerated the decks.
    [tb_BGR.sch, tb_BGR_PEX.sch, tb_CP_LF.sch, tb_CP_LF_PEX.sch, tb_PHASE_FREQ_DET.sch, tb_PHASE_FREQ_DET_PEX.sch]
2026-09-25 sim: closed-loop PLL testbenches, pre- and post-layout
    tb_LC_VCO_FPLL runs the pre-layout blocks; tb_LC_VCO_FPLL_PEX runs the
    Magic RC extractions with the EM inductor across the VCO tank. Both use the
    compiled behavioural divider and an ideal VBGR (the bandgap is a test block,
    not part of the tapeout). The post-layout deck adds a start-up kick on OUTp
    and sets the ADC threshold to the mid-swing of the extracted VCO output.
    LC_VCO_FPLL_PEX.sch / _PEX_tb.sch mirror the integrated schematic and its
    testbench with the extracted block symbols; LC_VCO_NOIND.sym is the
    extracted-VCO symbol they need.
    [LC_VCO_FPLL_PEX.sch, LC_VCO_FPLL_PEX_tb.sch, tb_LC_VCO_FPLL.sch, tb_LC_VCO_FPLL_PEX.sch]
2026-09-25 docs: LC-VCO tuning range and K_VCO, pre- vs post-layout
    13-point V_CTRL sweeps on the schematic and on the extraction (with the EM
    inductor). Pre-layout: 2.384-2.4906 GHz, peak K_VCO 134 MHz/V. Post-layout:
    2.3255-2.4256 GHz, peak 126 MHz/V; the extracted VCO does not reach 2.48 GHz.
    README section 9.8 documents both and the post-layout shortfall.
    plot_vco_paper.py now reads a CSV when given one.
    [vco_tuning_post.csv, vco_tuning_pre.csv]
2026-09-26 sim: divider testbenches at the PLL clock, post-layout from the OpenLane netlist
    Both divider testbenches now use a 2.4 GHz, 1.2 V input clock (what the VCO delivers) with a 10 ps step
    and a 250 ns window. Post-layout includes the layout-extracted netlist of the OpenLane run directly
    (final/spice/dsm_and_freq_divider.spice, PDK standard cells first, small wrapper for the power pins),
    so the separate kpex extraction pex/DSM_N_FREQ_DIV__DSM_N_FREQ_DIV is removed. The pre-layout testbench
    netlists again: its dut instance carries the behavioural d_cosim format, which the symbol lost when it was
    changed for LVS. Both divide by 248 (output period 103.33 ns).
    [LC_VCO_PEX_tb.sch, tb_DSM_N_FREQ_DIV.sch, tb_DSM_N_FREQ_DIV_PEX.sch, tb_LC_VCO_FPLL.sch, tb_LC_VCO_FPLL_PEX.sch]
2026-09-26 sim: viewer graphs that mirror the popup plots, popups for every block, post-layout VCO testbench
    Each block testbench's waveform viewer now plots the same signals, in the same colours and order, as
    its ngspice popups, for pre- and post-layout (bandgap, charge pump, charge pump + loop filter, PFD, VCO).
    Popups were added where a testbench only had viewer graphs. The PEX bandgap graph no longer reads the
    pre-layout result.
    LC_VCO_PEX_tb is the post-layout twin of LC_VCO_tb (extracted VCO with the EM inductor, start-up kick);
    it replaces the legacy LC_VCO_pex_tb. raw_spectrum_as_tran.py relabels the FFT result so the xschem viewer
    can draw it (xschem ignores ngspice's "Spectrum" plot type).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
    [LC_VCO_PEX_tb.sch, LC_VCO_tb.sch, tb_BGR.sch, tb_BGR_PEX.sch, tb_CP.sch, tb_CP_LF.sch, tb_CP_LF_PEX.sch, tb_PHASE_FREQ_DET.sch]
2026-09-26 sim: integrated PLL testbenches; drop the hand-built flat PLL testbenches
    Remove tb_LC_VCO_FPLL and tb_LC_VCO_FPLL_PEX (and their netlists); the closed-loop PLL is simulated from
    LC_VCO_FPLL_tb and the post-layout LC_VCO_FPLL_PEX_tb built on the same symbol. LC_VCO_FPLL_tb now
    reads the raw file it writes (tb_LC_VCO_FPLL_40u.raw); LC_VCO_FPLL_PEX_tb uses the OpenLane divider netlist.
    Includes the regenerated netlist and the schematic re-save of PFD_CP_LF.
    [LC_VCO_FPLL_PEX_tb.sch, LC_VCO_FPLL_tb.sch, PFD_CP_LF.sch]
2026-09-26 docs: block-level pre- vs post-layout comparison tables
    Rerun of every block testbench from xschem. Adds supply current per block, updates the PFD, charge pump +
    loop filter, VCO (from the tuning sweep) and divider rows, and describes the divider condition (2.4 GHz,
    1.2 V) and its post-layout netlist (OpenLane, no separate extraction).
2026-09-26 Add UNIC-CASS final chip, KLayout editor and 2.5D screenshots; remove duplicate images
    [MPC0388.sch, team1.sch, user_project_wrapper_team1.sch]
2026-09-26 Update VCO standalone simulation data, PEX testbench pin labels, DSM behavioural model and regenerated phase-noise plots
    [LC_VCO_PEX_tb.sch]
2026-09-26 README: update PLL die size to the measured 907 x 670 um
2026-09-27 Add high-quality KLayout/xschem exports and collages for the PLL and full chip
    - Fix KLayout renders using the actual PDK layer colors: load_layer_props() must be
    called explicitly on a layout loaded from a script, the -l command-line flag alone
    does not apply.
    - PLL layout (top view) and PLL 2.5D view (top and oblique), full UNIC-CASS chip
    layout (with filler cells) and its 2.5D view, using a trimmed metal-stack-only
    d25 script so the whole-chip mesh fits this container's memory.
    - Side-by-side and top/bottom collages of the above, cropped to content, native
    resolution, legible labels naming their subject.
    - Re-exported the integrated schematic and PLL testbench waveforms; fixed t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
    [LC_VCO_FPLL_PEX_tb.sch, LC_VCO_FPLL_tb.sch, LC_VCO_response_tb.sch, tb_PHASE_FREQ_DET.sch, tb_PHASE_FREQ_DET_PEX.sch]
2026-09-27 README consistency fixes
    - Correct the false 'Monte Carlo not run' claim: add the actual bandgap and
    charge-pump mismatch results (200 samples each).
    - Add the missing Figure 17 caption and renumber every figure after it through 26.
    - Clarify which of section 9's results are the paper's actual post-layout figures,
    which are this repo's own post-layout PEX comparisons, and which are the
    schematic-level closed-loop run placed there for comparison.
    - Section 3.2 lock time now reflects the measured pre-layout value instead of the
    earlier 'no number exists' status.
    - Drop the 'HFSS / paper' table header down to 'HFSS' and rephrase the EM flow
    section, em/README.md and CLAUDE.md so the i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
2026-09-27 Clean up repository for open-sourcing
    Drop tracked files that should never have been versioned or that were
    exact duplicates, and clean up filenames, ahead of making the repo public:
    - Remove ~95 MB of fft_output/vco_waveform simulation dumps under
    xschem/ and simulations/ - regenerable testbench output, already covered
    by .gitignore, just committed before that rule existed.
    - Remove openems/ - a single empty placeholder file from before em/ existed.
    - Consolidate paper_submission/: two pairs of PDFs were byte-identical
    under different names; kept one clean name per unique version
    (SMACD_2026_paper_5699.pdf, SMACD_2026_paper_5699_draft.pdf).
    - Remove archive/hfss/.../Pspice.zip and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
    [fft_output_parametric.txt, vco_waveform_parametric.txt]
2026-09-30 Fix remaining overstated EM-verification claims
    README §5.2 said the open-source flow reproduces every published figure,
    without saying that claim covers only the de-embed/fit/solve stages run
    against HFSS S-parameters, not an independent OpenEMS FDTD solve (which
    has not been run in this repo). validate.py's docstring still called
    HFSS 'the reference this design was actually taped out with', left over
    from before the paper-consistency pass earlier.
2026-10-03 em: fix two bugs that made the OpenEMS inductor model impossibly slow
    Found while actually trying to run the OpenEMS stage for the first time
    (it had never been executed in this repo before).
    1. gds_geometry.read_gds()/build_openems.collect_layers() filtered GDS
    polygons by layer number only, ignoring datatype. SG13G2's TopMetal1
    and TopMetal2 layer numbers also carry a full-cell marker polygon on a
    different datatype (fill-exclusion/boundary, not drawn metal), so the
    EM model was including a bogus 666x666 um conductor plate spanning the
    whole die on both layers. Fixed by matching (layer, datatype=0) pairs;
    read_gds() now accepts either bare layer numbers or (layer, dataty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
2026-10-07 Make schematic and netlist paths relative to the repo
    Replace hard-coded /foss/designs/... container paths with paths relative to
    each file, and point .xschemrc at the repo it is launched from ([pwd]).
    Netlist content and simulation settings are unchanged; only where files are
    found differs. Every replaced reference was checked to resolve.
    [LC_VCO_FPLL_PEX_tb.sch, tb_BGR_PEX.sch, tb_CP_LF_PEX.sch, tb_DSM_N_FREQ_DIV_PEX.sch, tb_PHASE_FREQ_DET_PEX.sch]
