Manimohan05/SG13G2_2.4GHz_LC_VCO_FPLL/(notices)

Notices in the files:
xschem/dsm/src/generate_sym.py:
This program is free software; you can redistribute it and/or modify
it under the terms of the GNU General Public License as published by
the Free Software Foundation; either version 2 of the License, or
(at your option) any later version.
